budabalint/T.E.E.M.O/Circuit/CanSat/canSat_edge_cut_v1.dxf

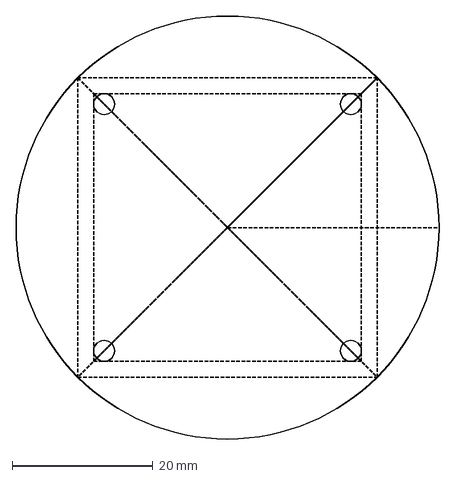
[picture p1: CAD file, 2025-11-27]
Circuit/CanSat/canSat_edge_cut_v1.dxf
60.0 x 60.0 mm
