budabalint/T.E.E.M.O/Circuit/CanSat_V2/V0.2.pdf

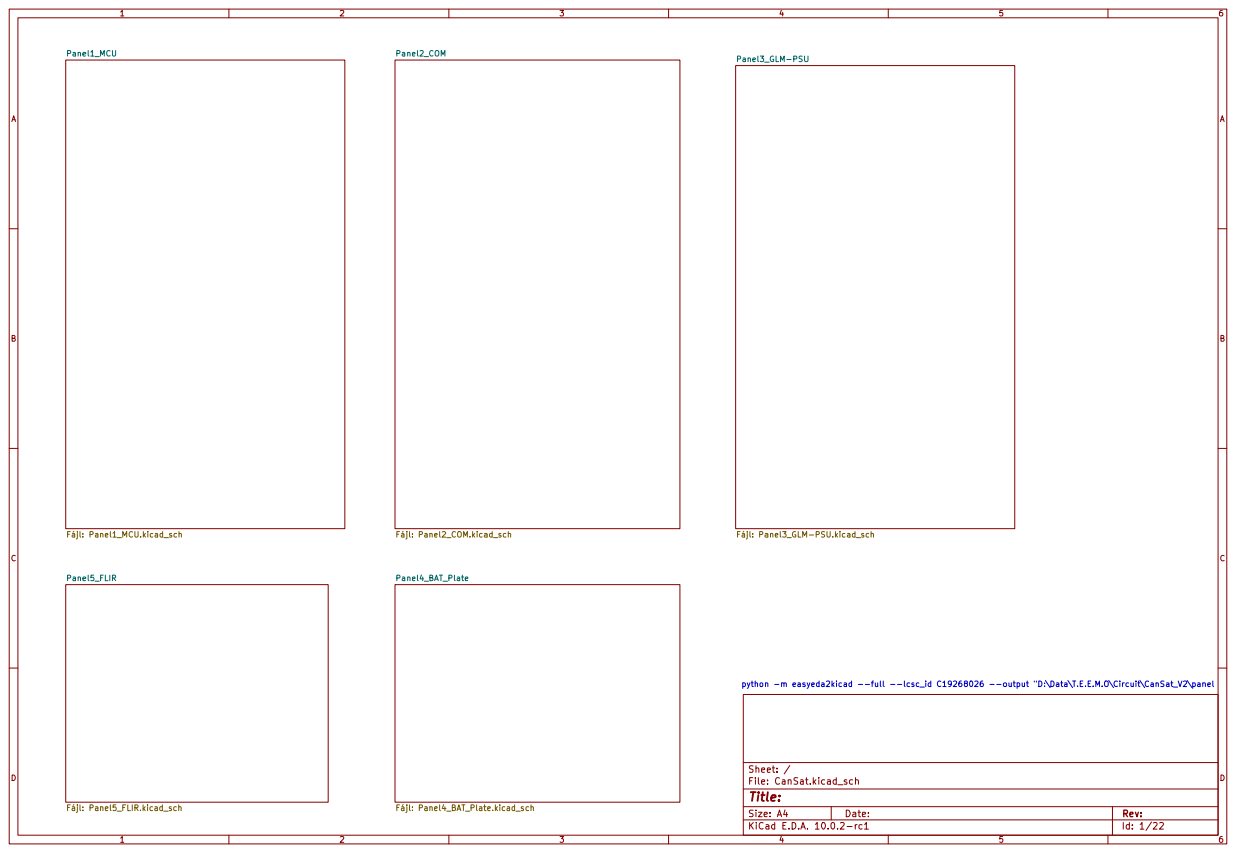
[picture p2: page 1]

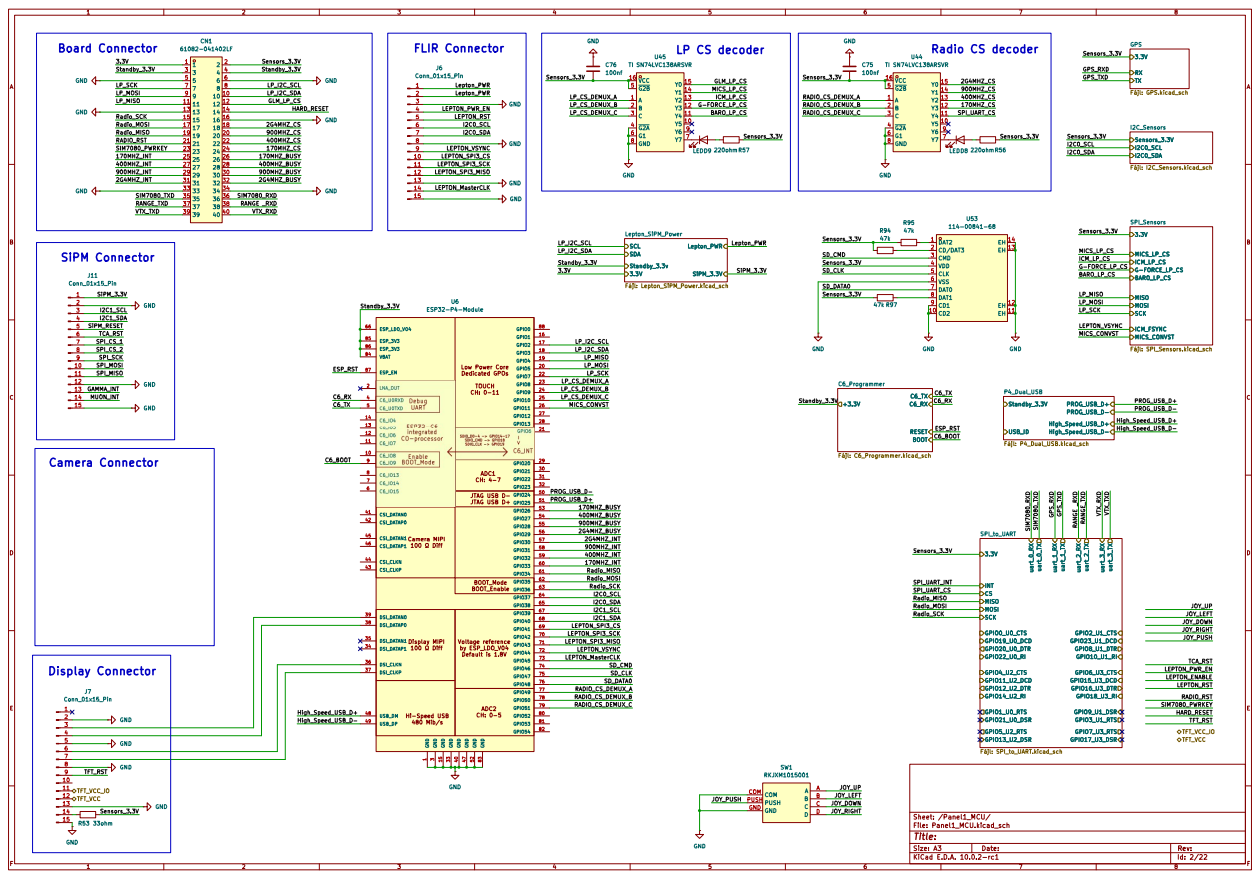
[picture p3: page 2]

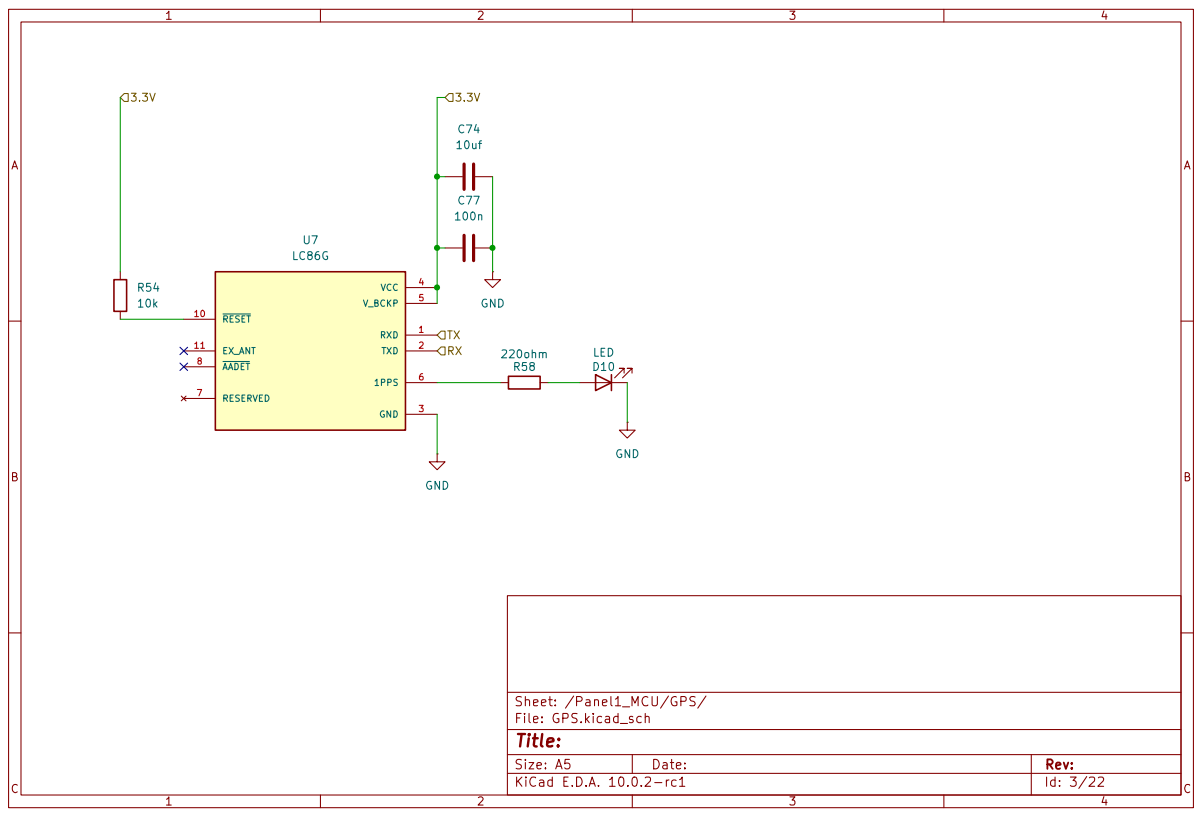
[picture p4: page 3]

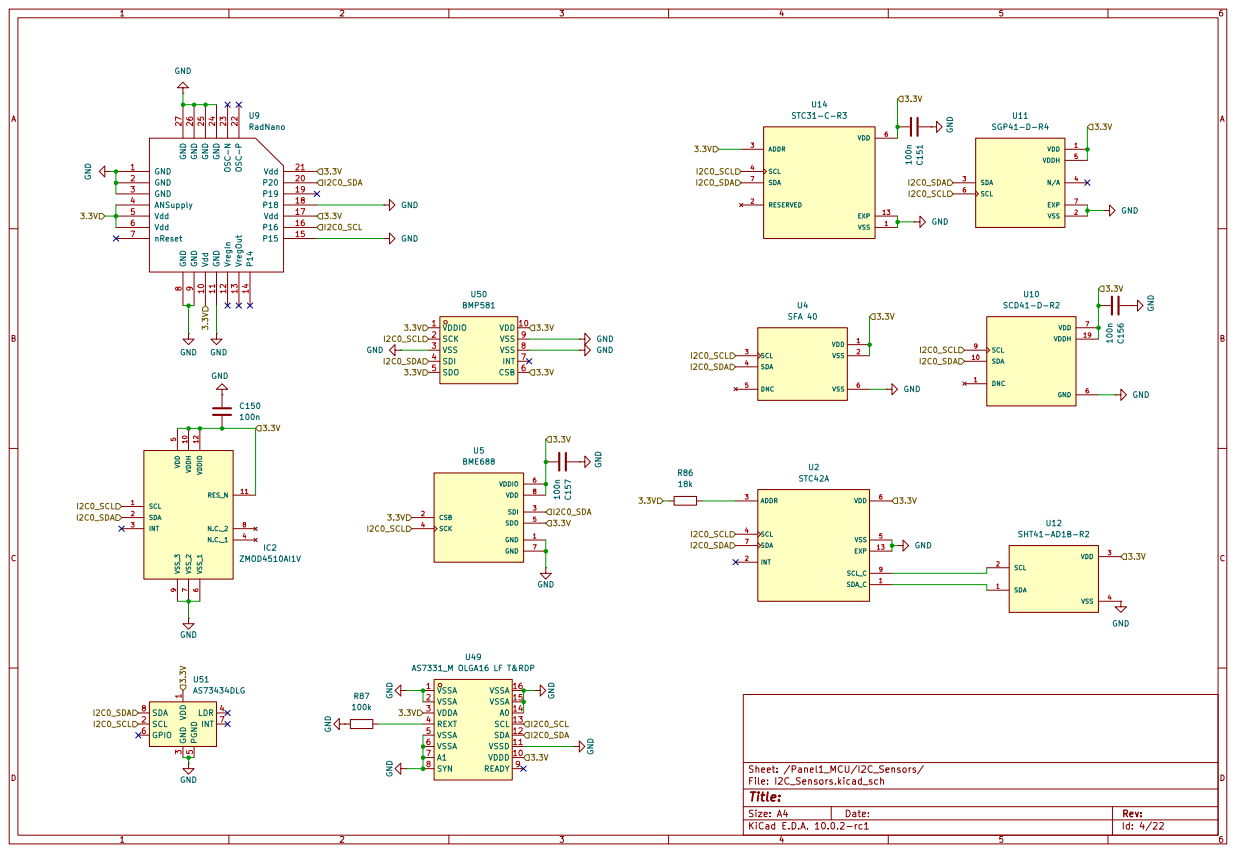
[picture p5: page 4]

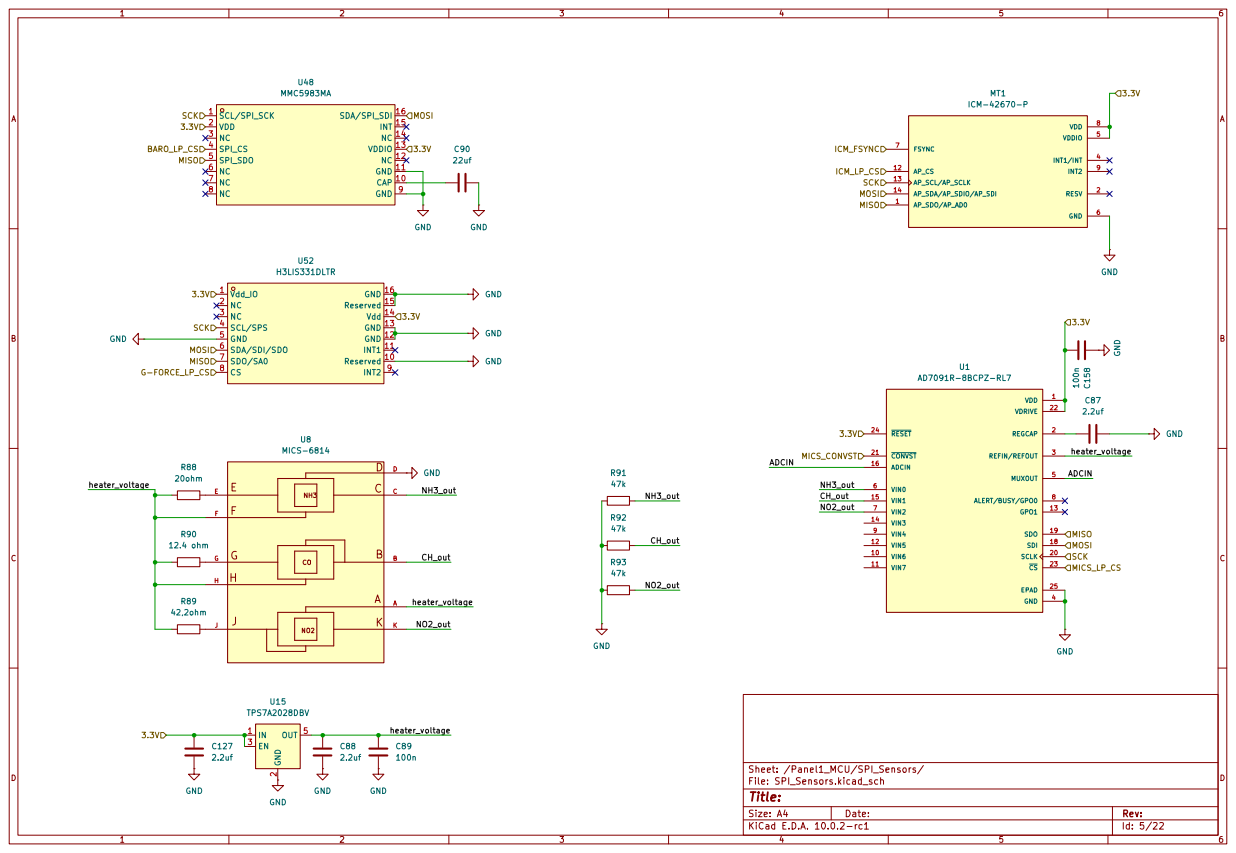
[picture p6: page 5]

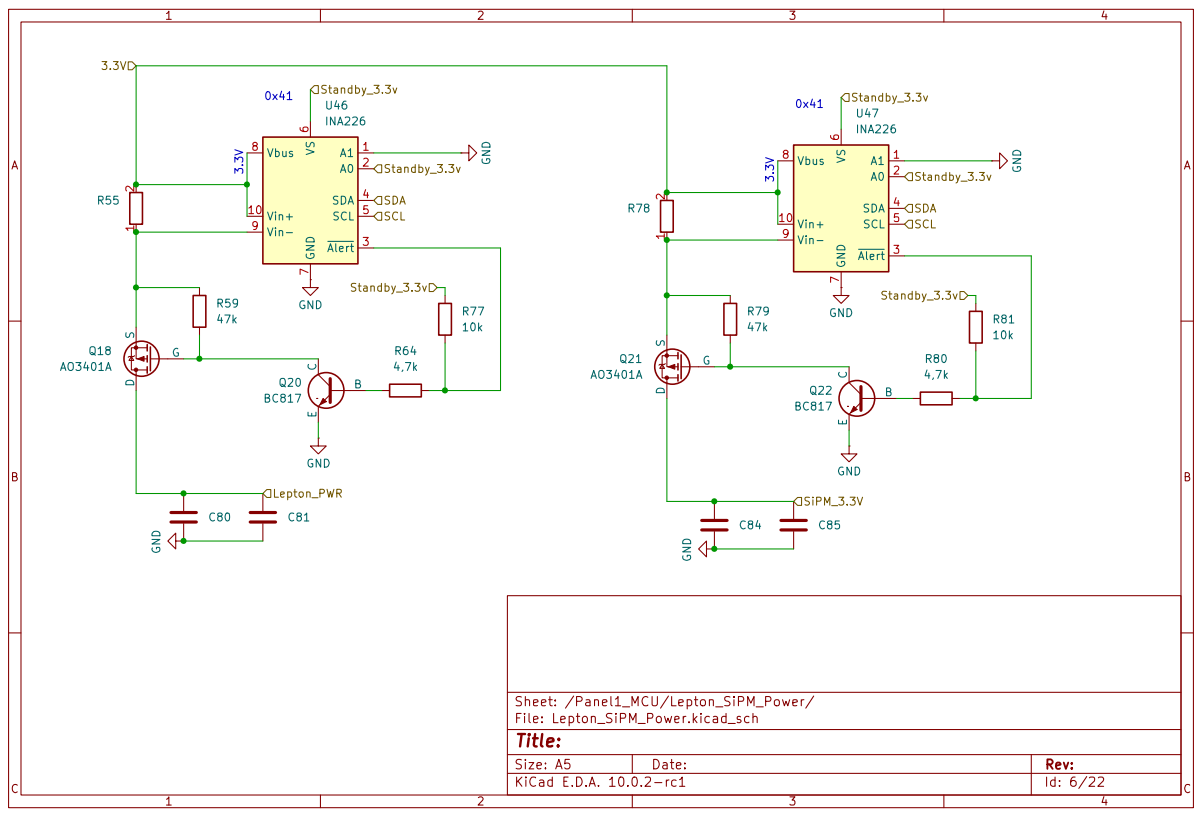
[picture p7: page 6]

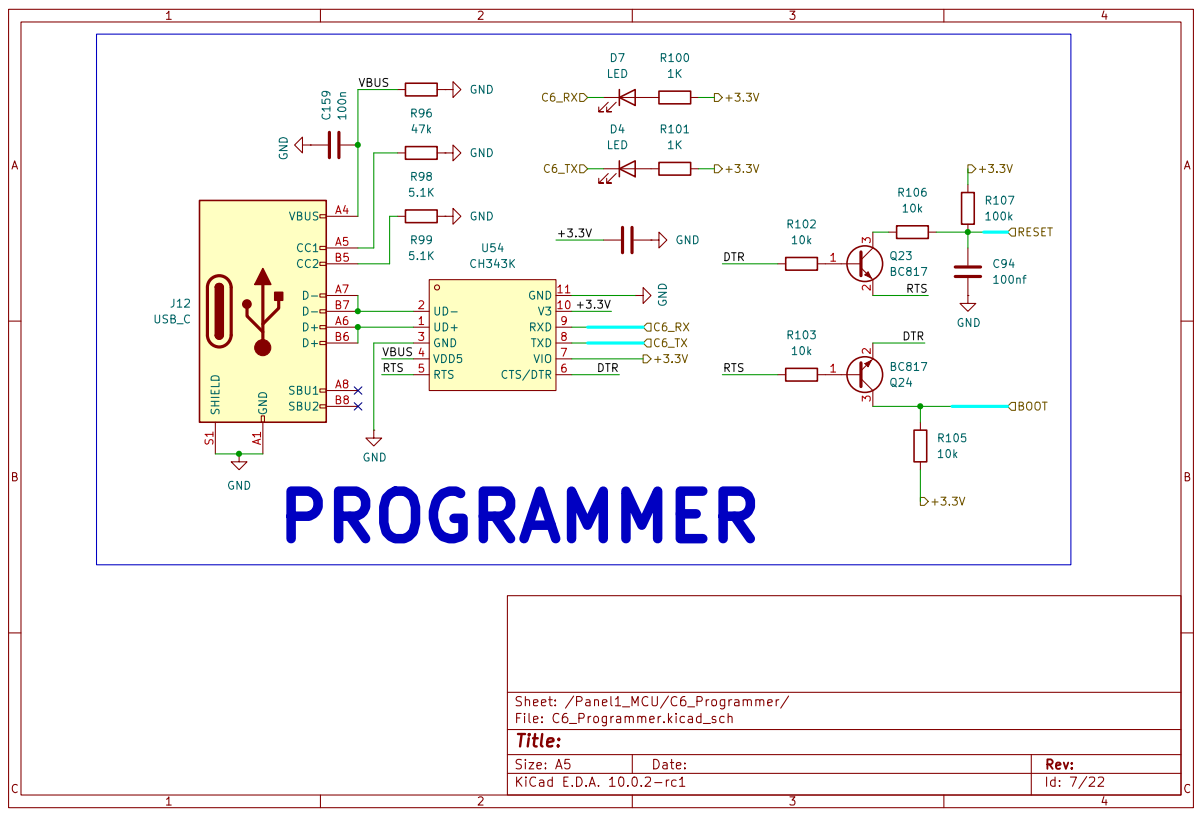
[picture p8: page 7]

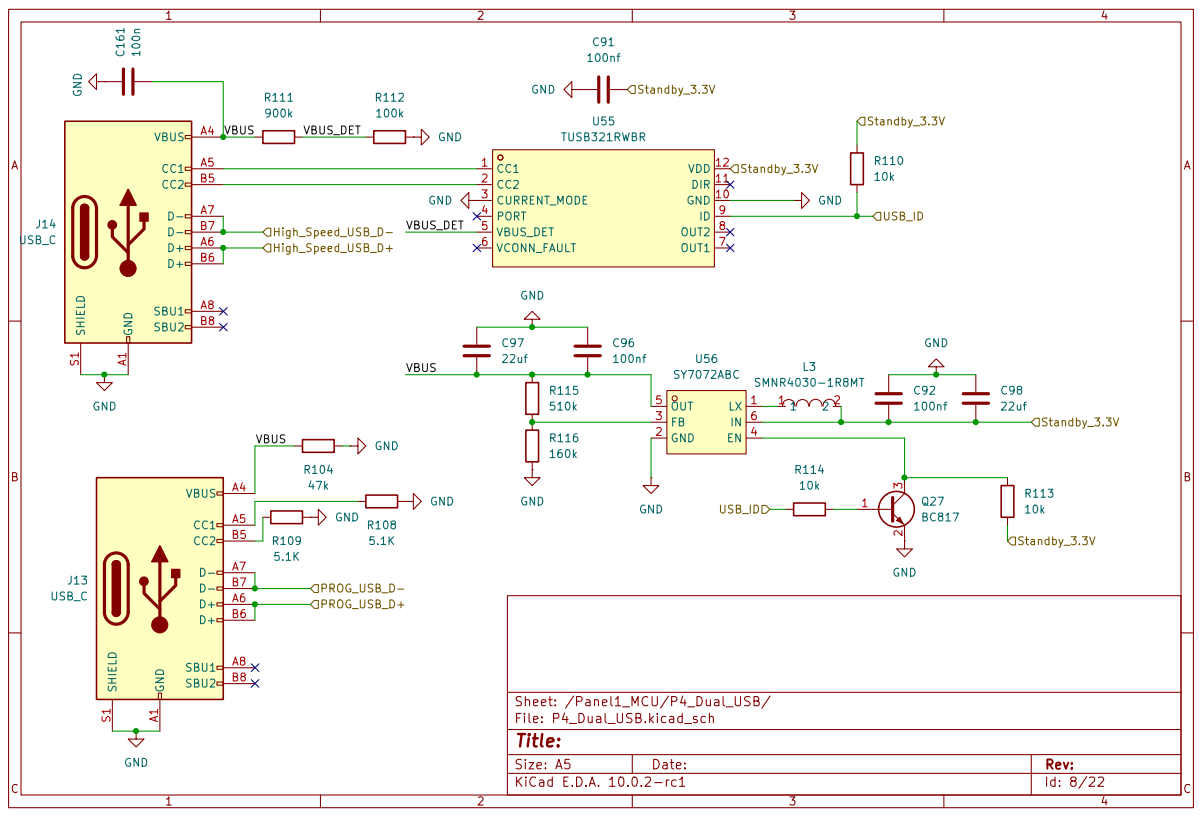
[picture p9: page 8]

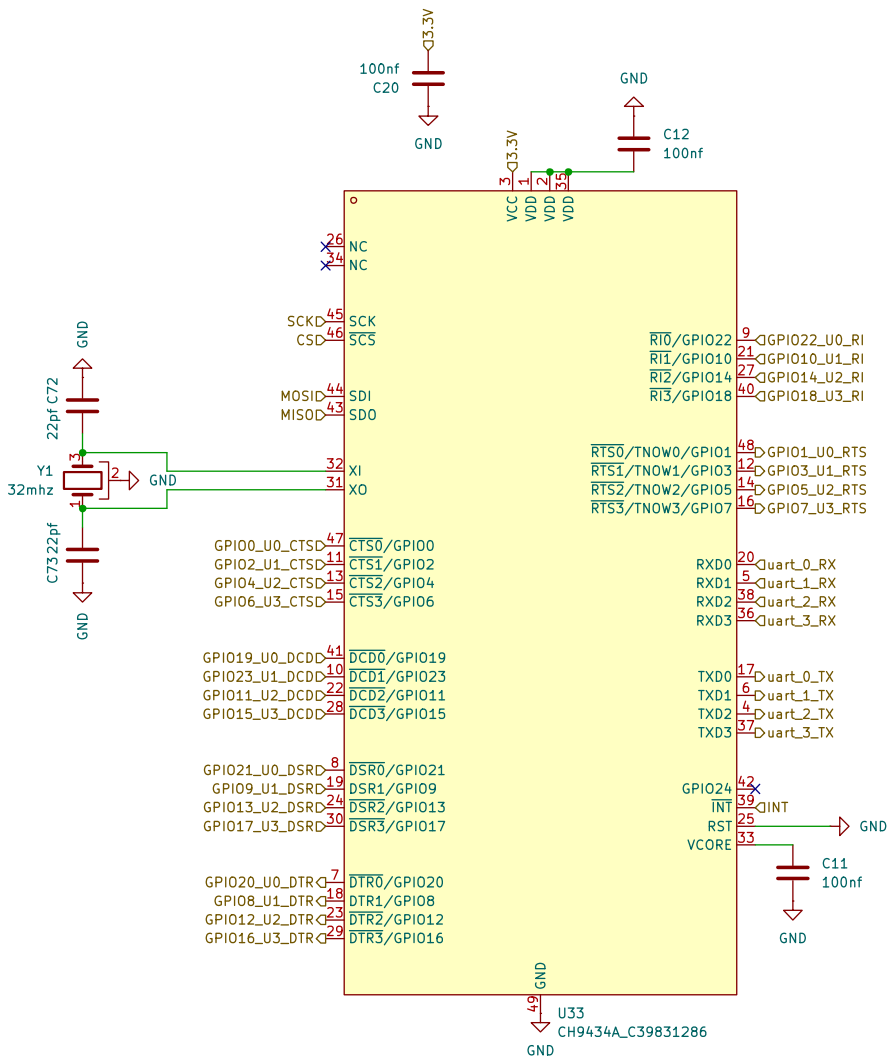
[picture p10: page 9]

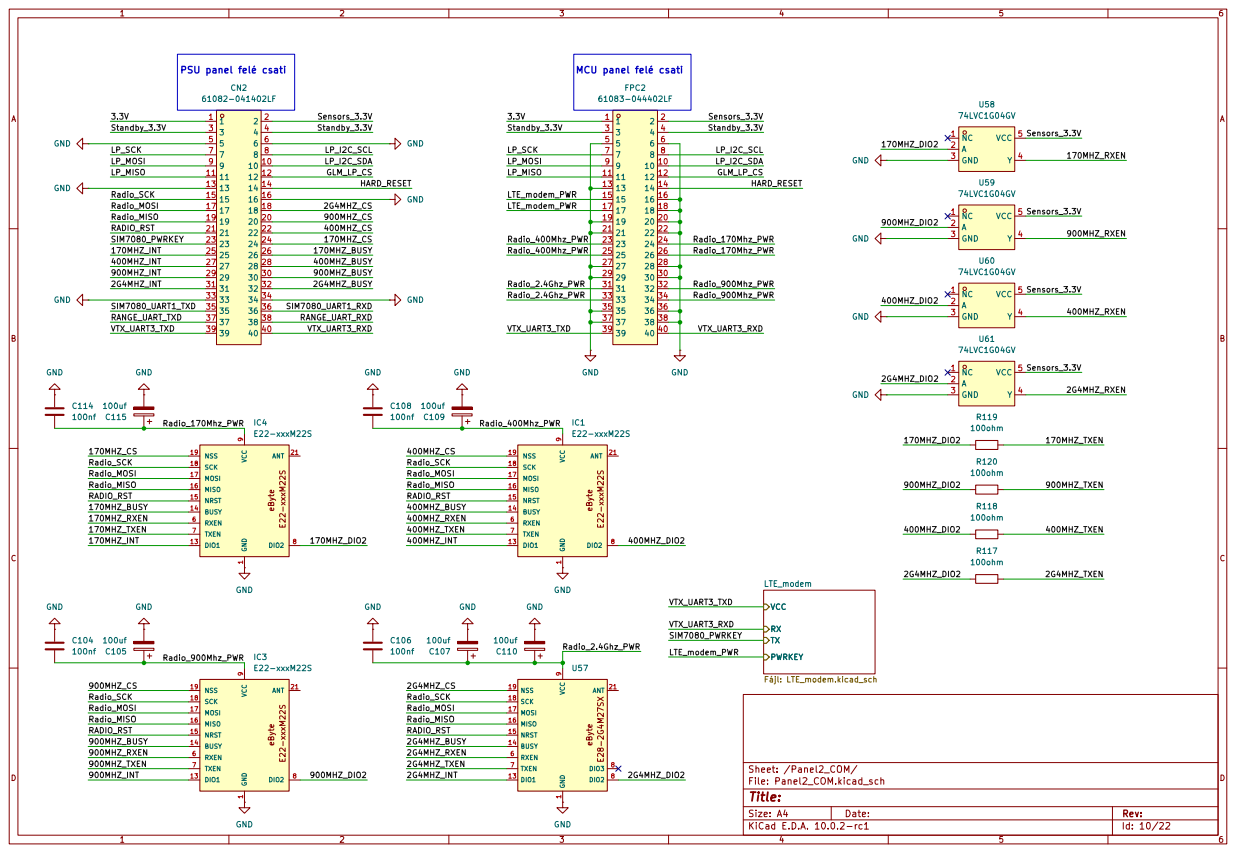
[picture p11: page 10]

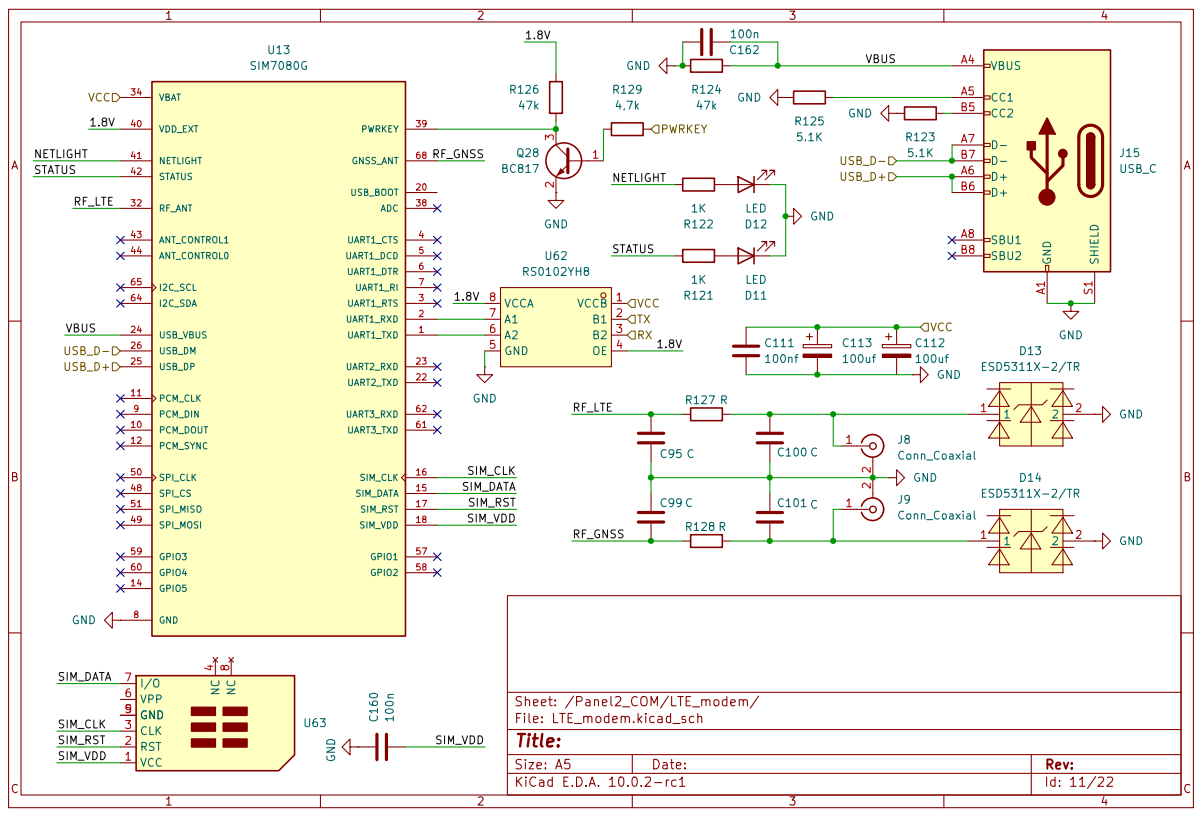
[picture p12: page 11]

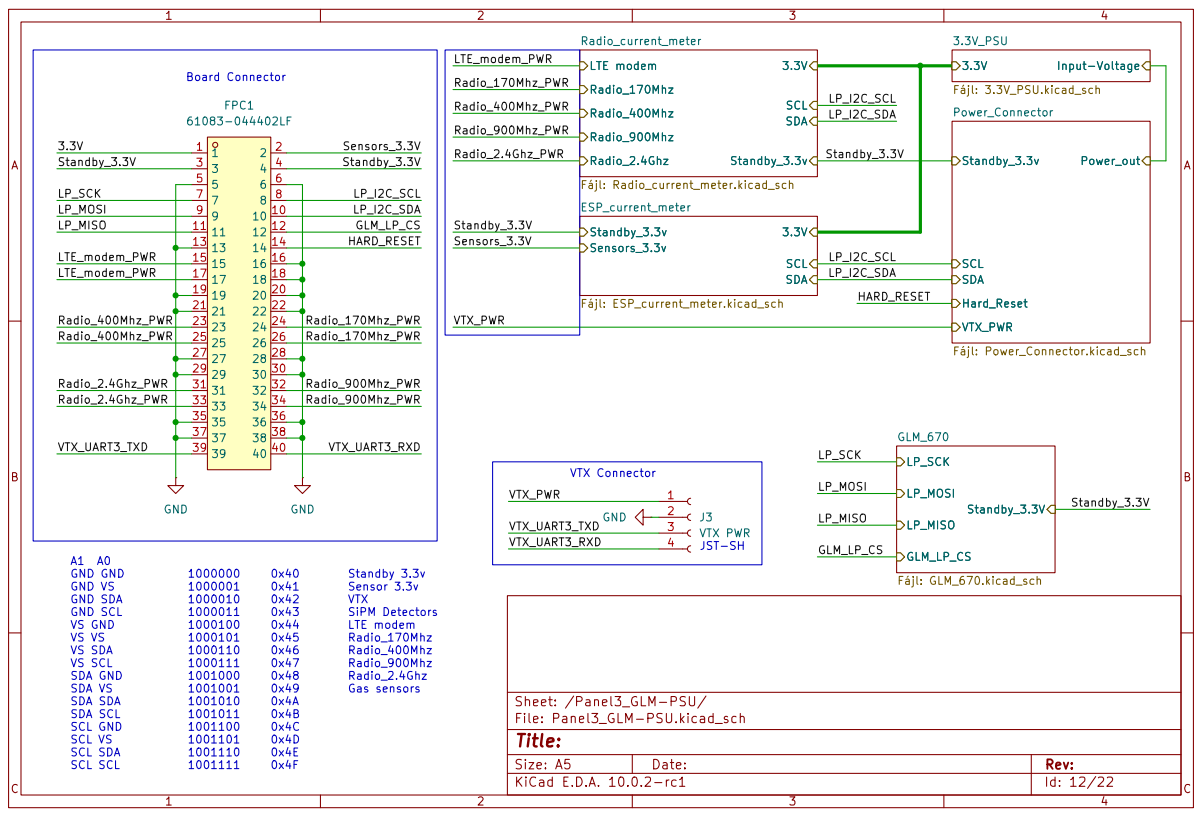
[picture p13: page 12]

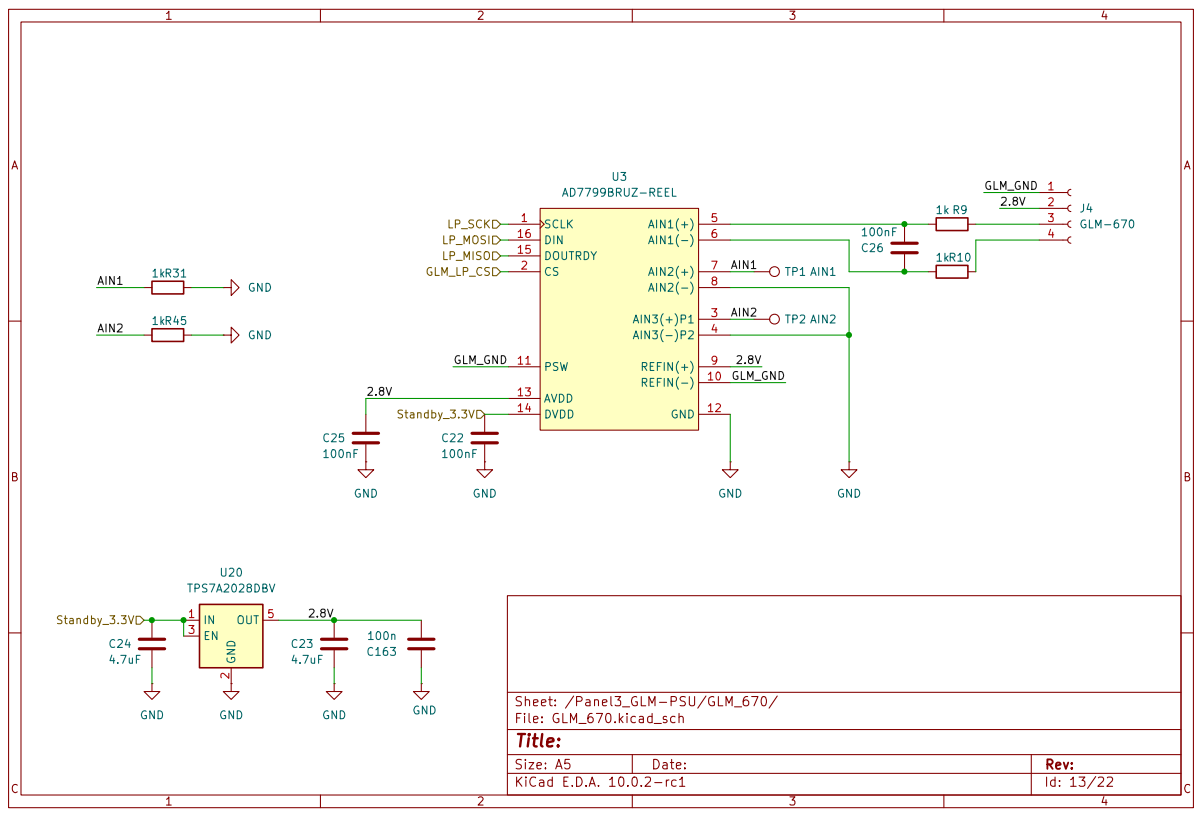
[picture p14: page 13]

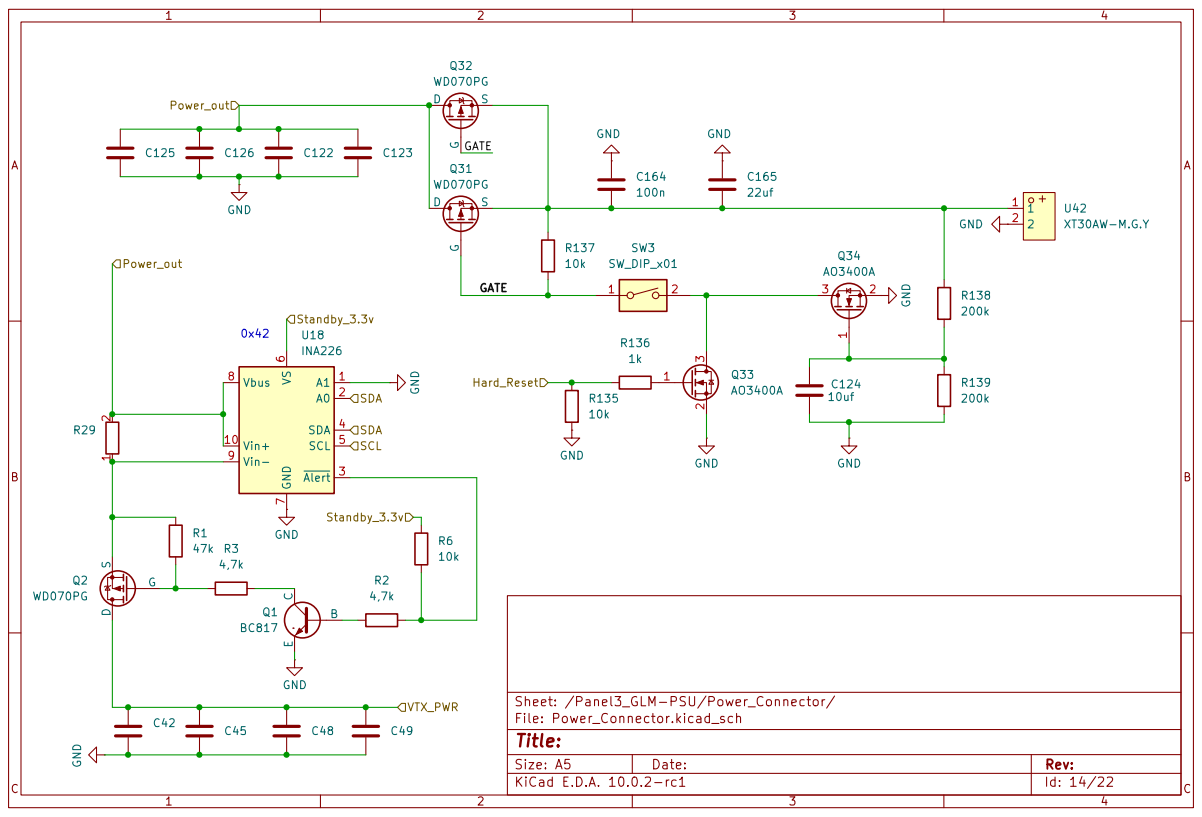
[picture p15: page 14]

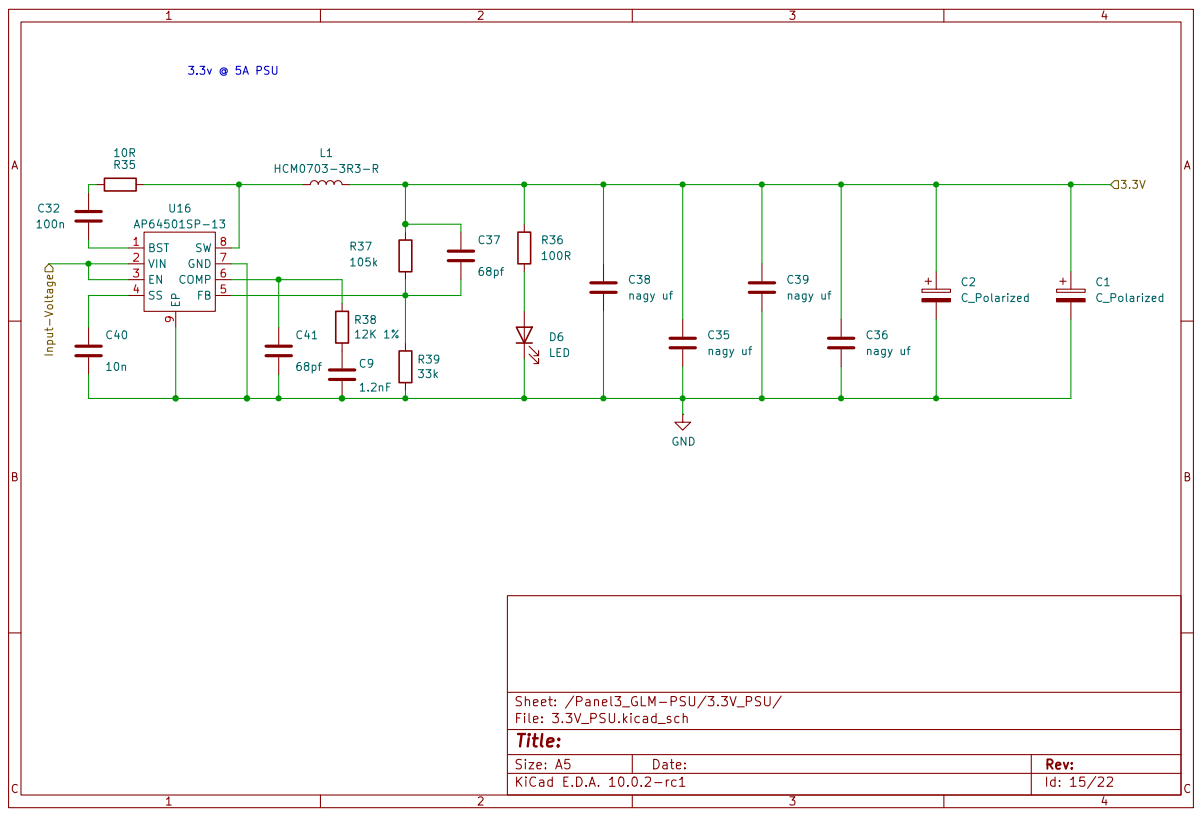
[picture p16: page 15]

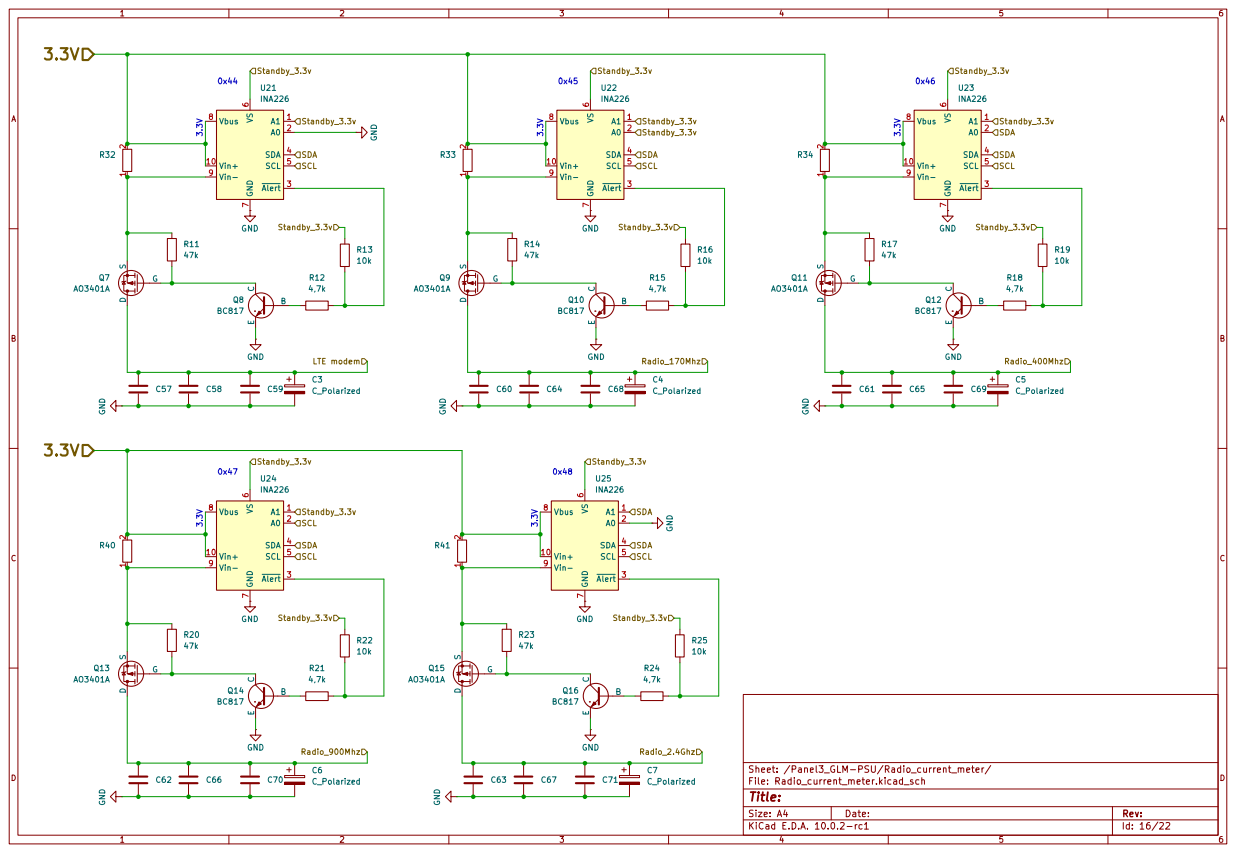
[picture p17: page 16]

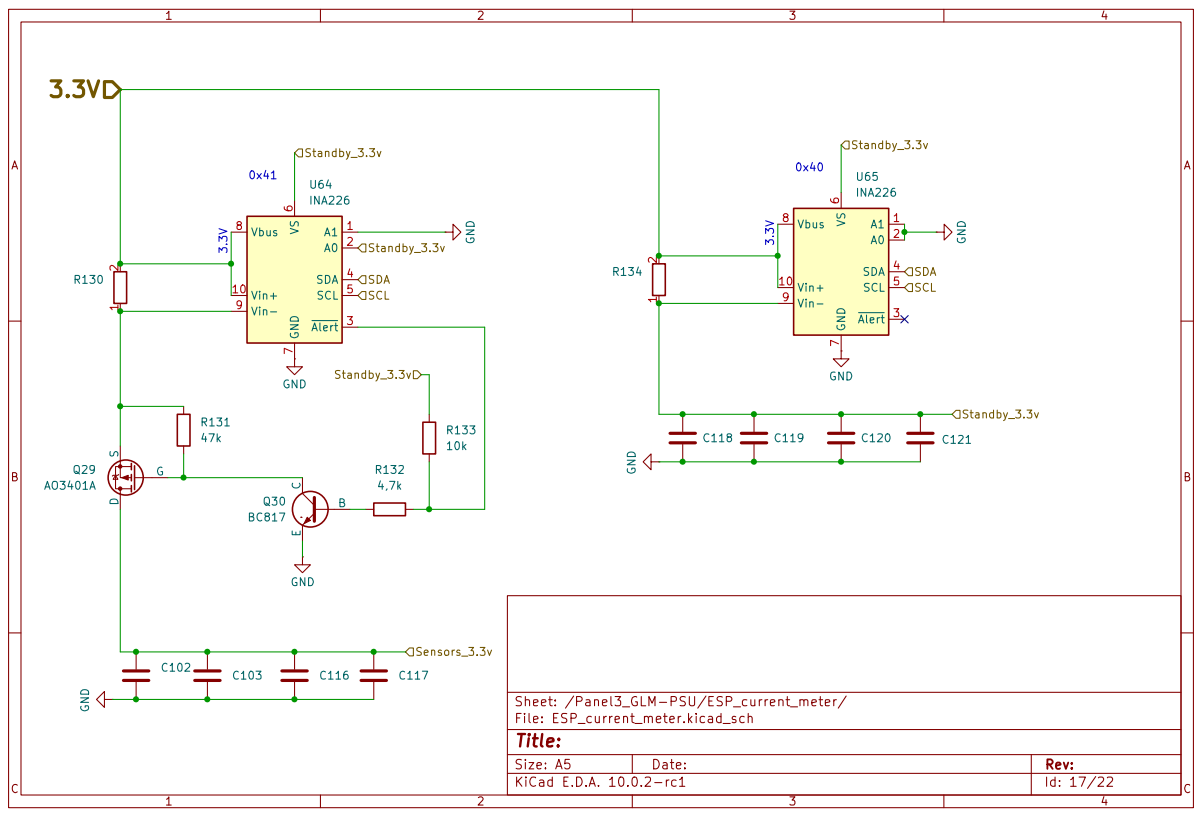
[picture p18: page 17]

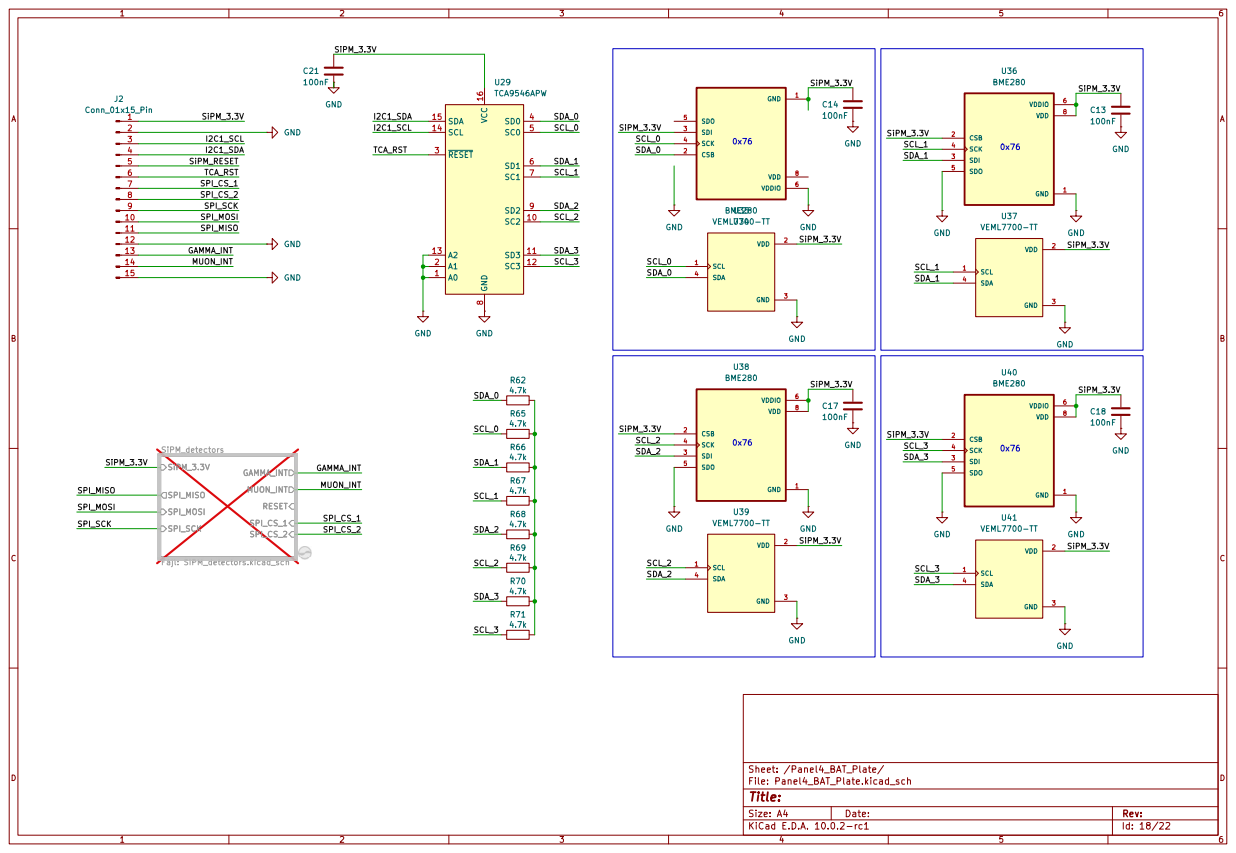
[picture p19: page 18]

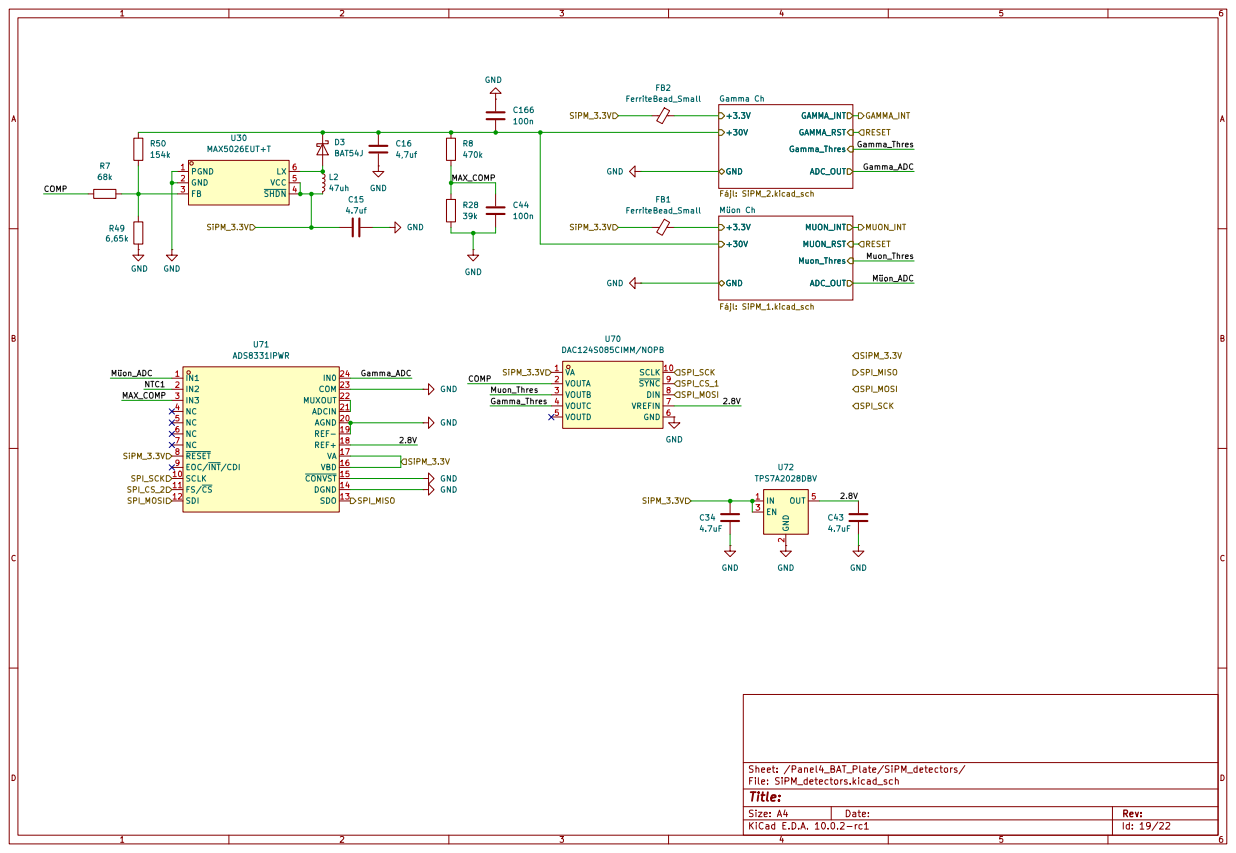
[picture p20: page 19]

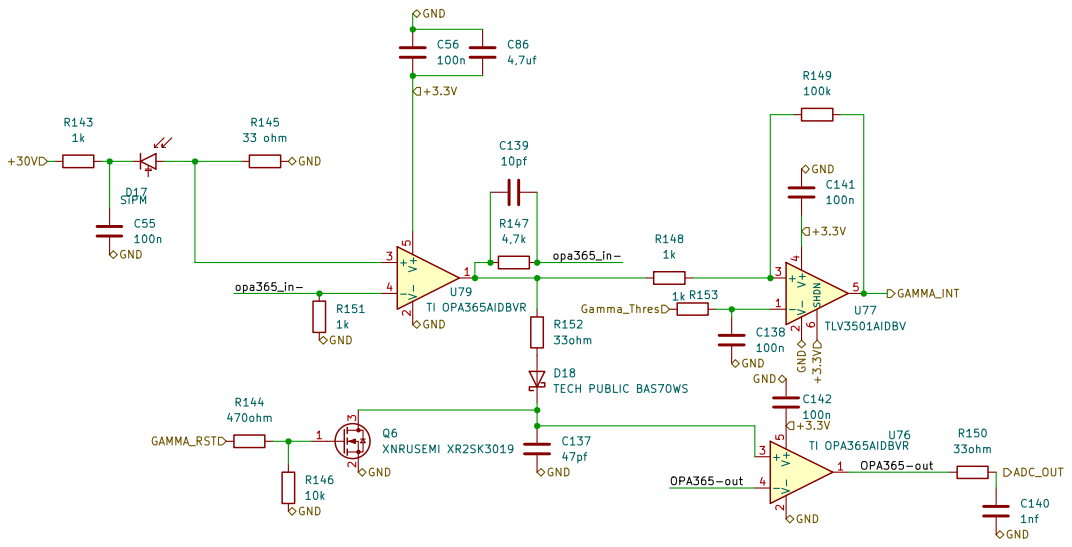
[picture p21: page 20]

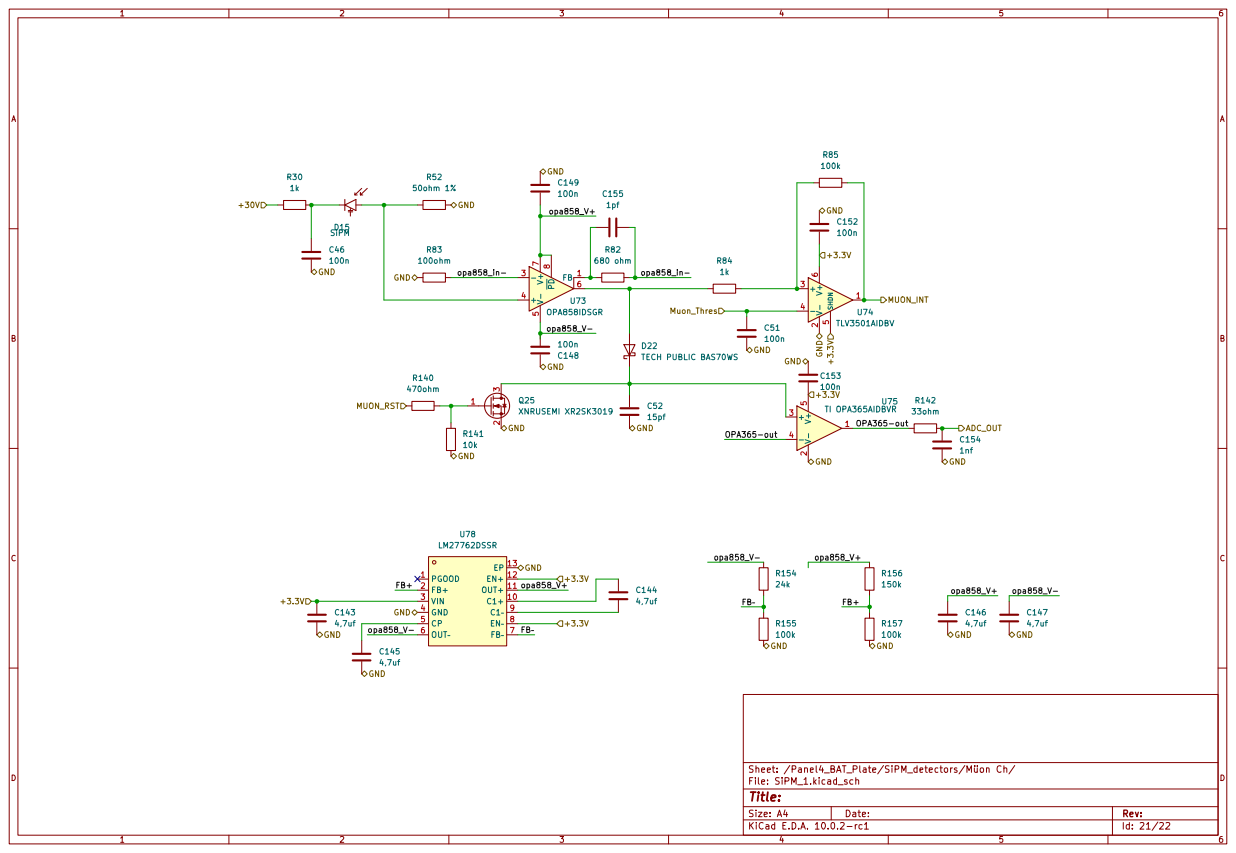
[picture p22: page 21]

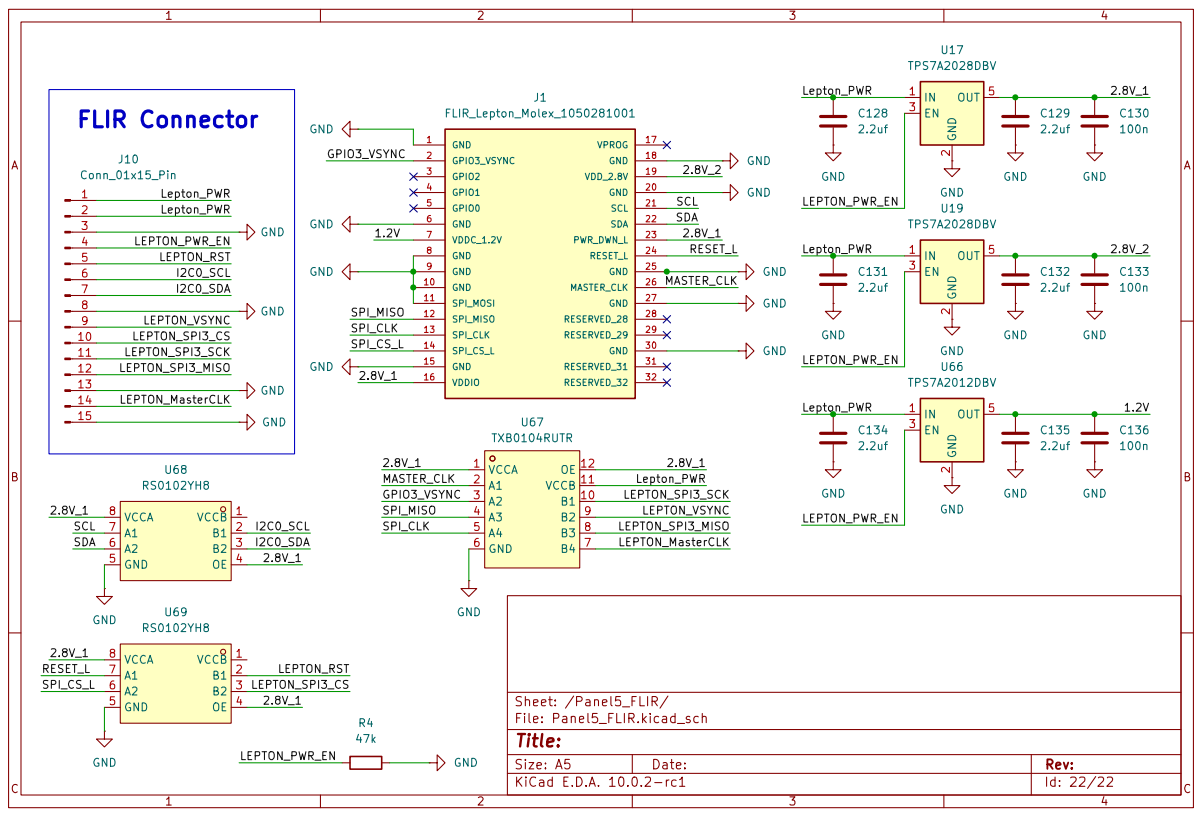
[picture p23: page 22]
