budabalint/T.E.E.M.O/Circuit/CanSat/V1.0.pdf

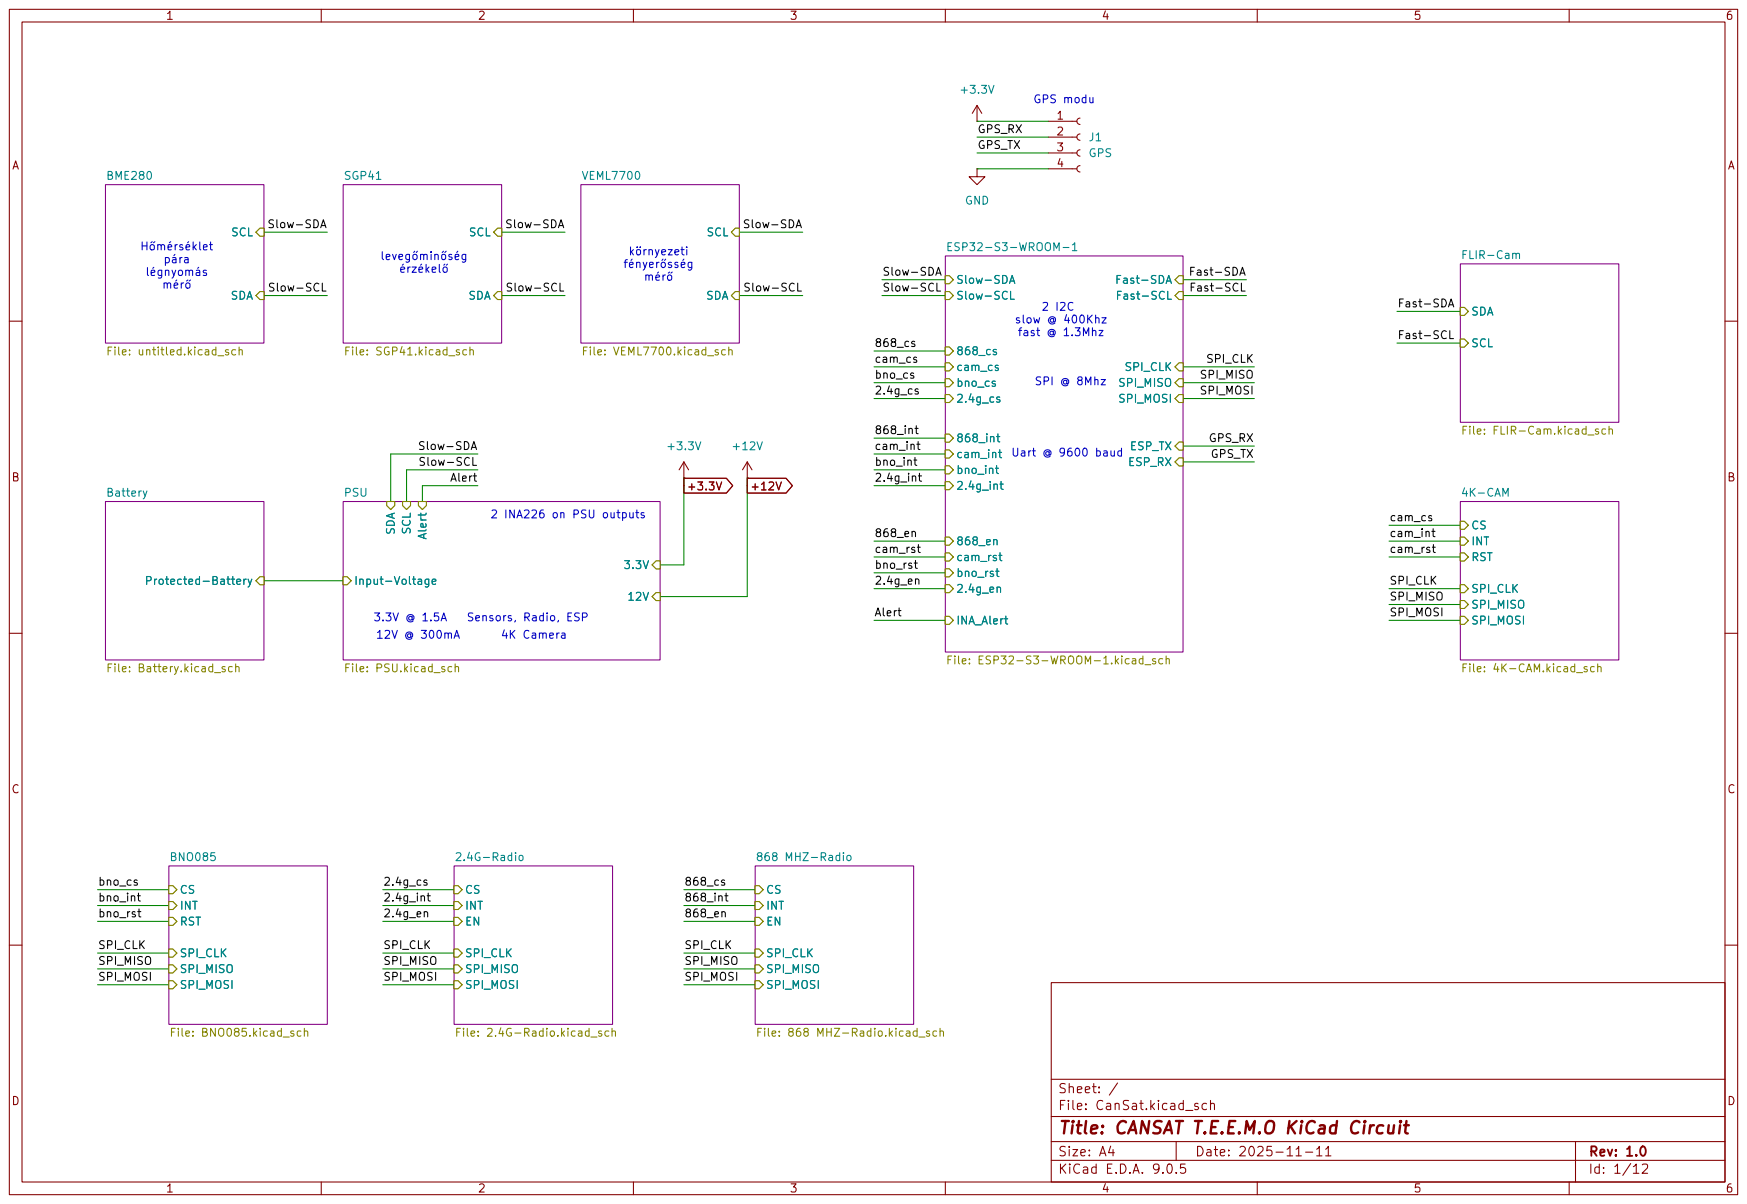
[picture p24: page 1]
