budabalint/T.E.E.M.O/Circuit/CanSat_V2/V0.1.pdf

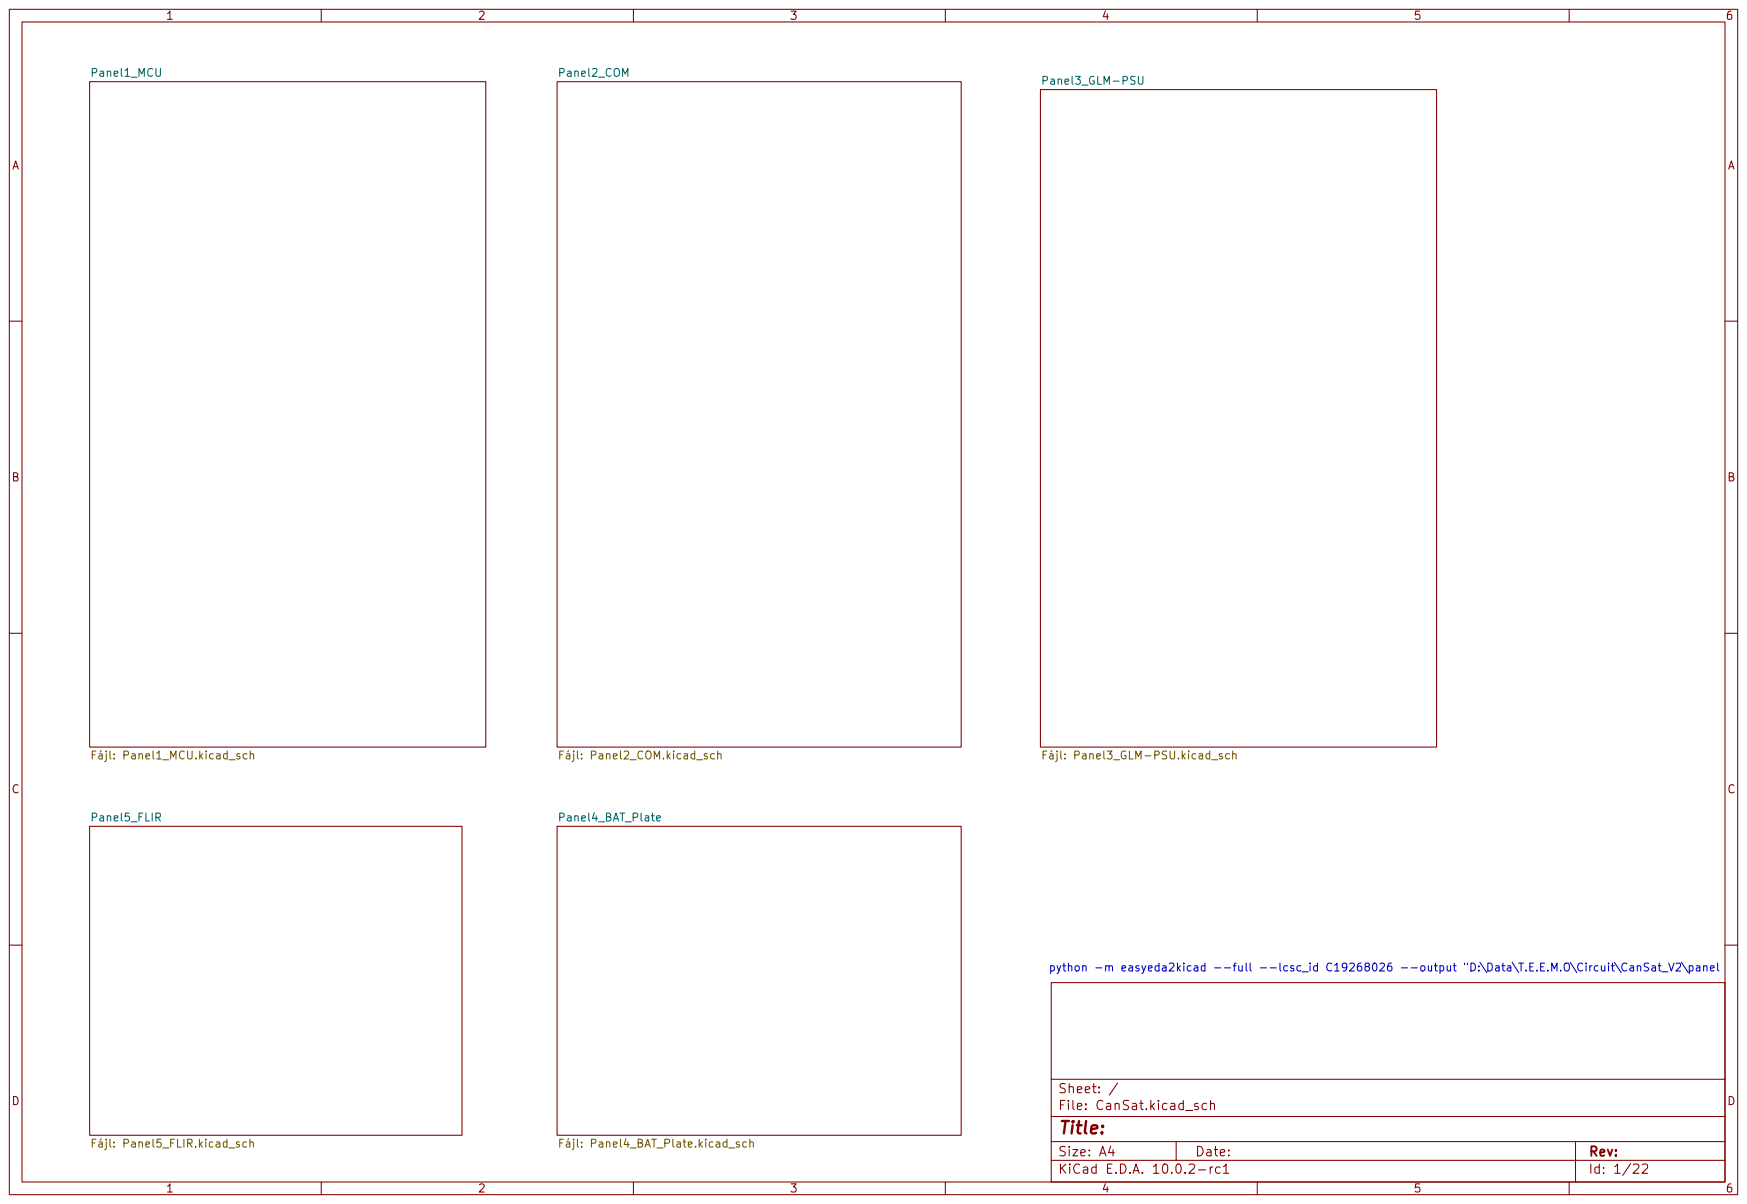
[picture p25: page 1]

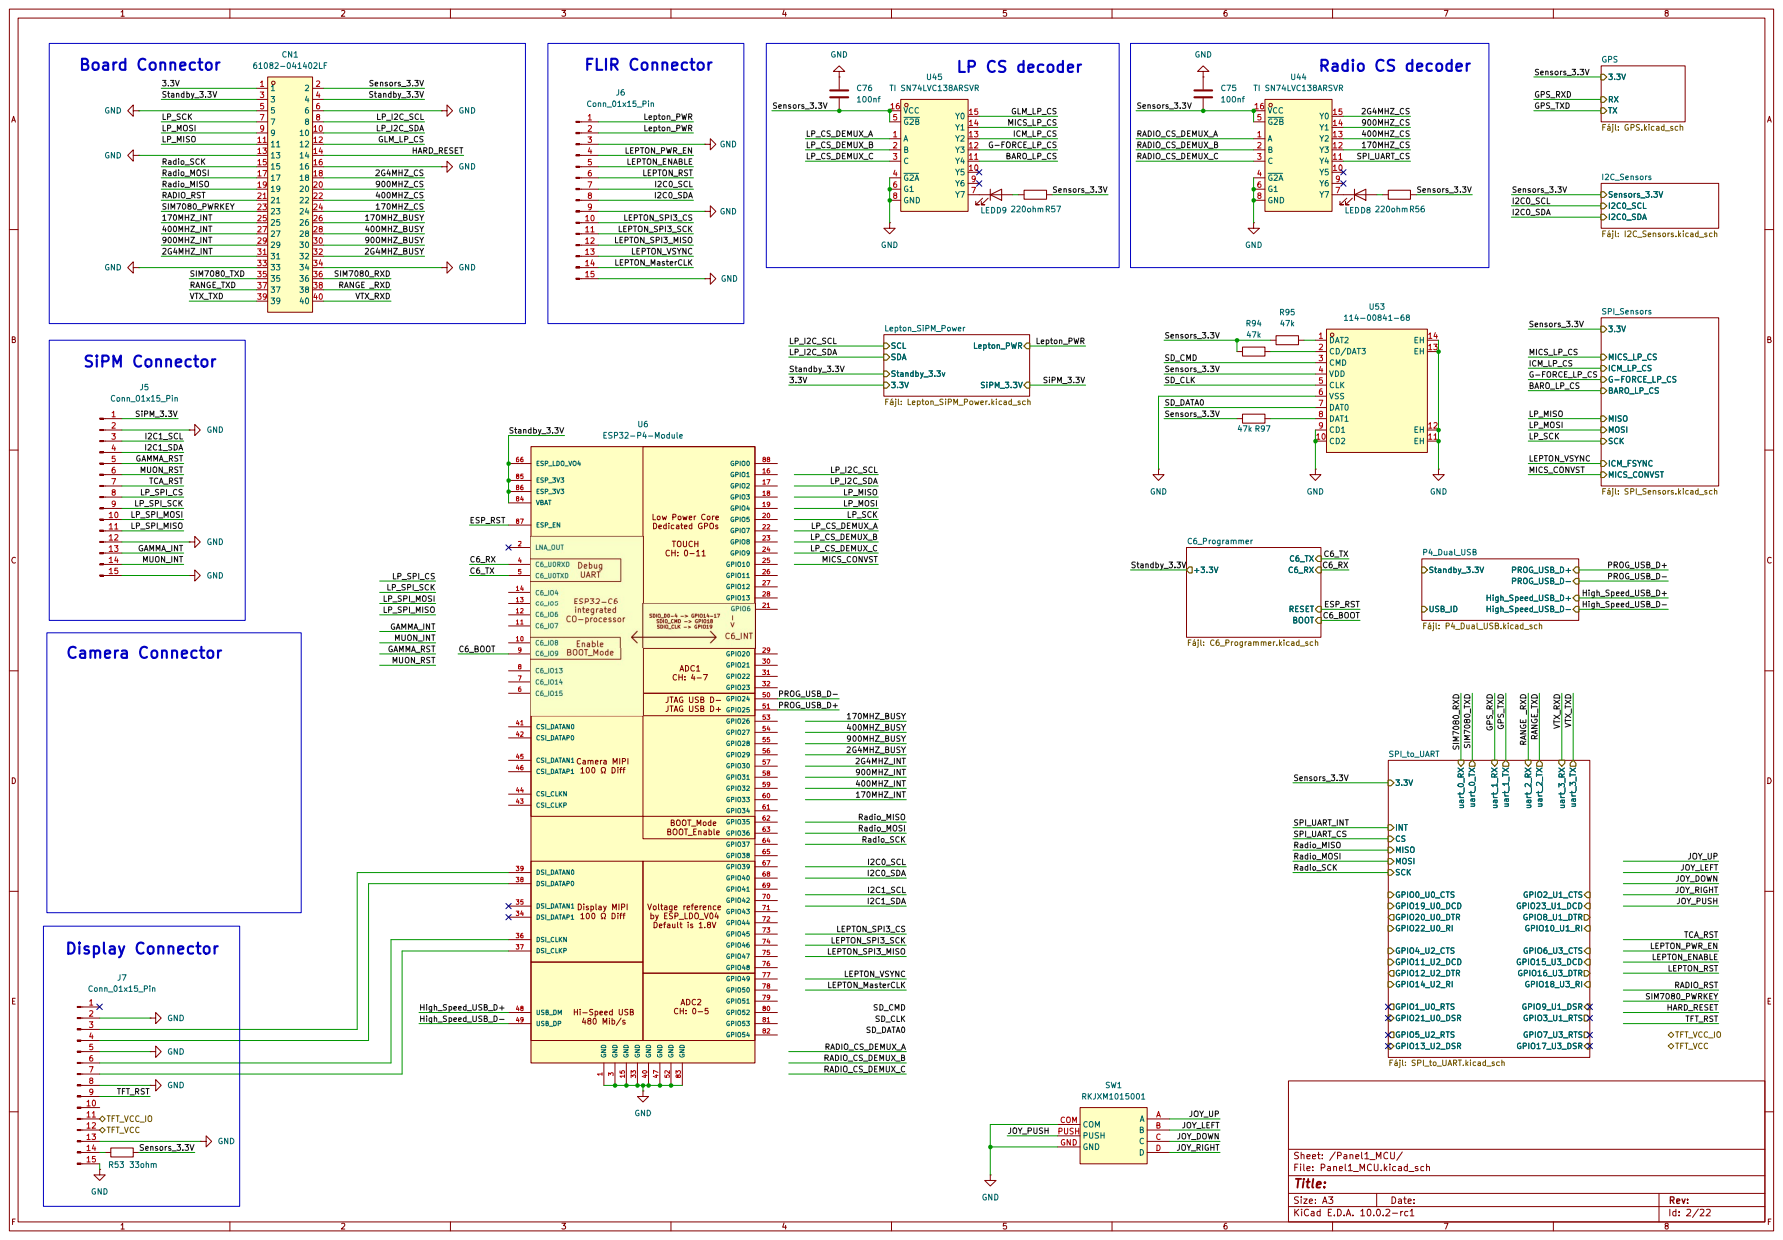
[picture p26: page 2]

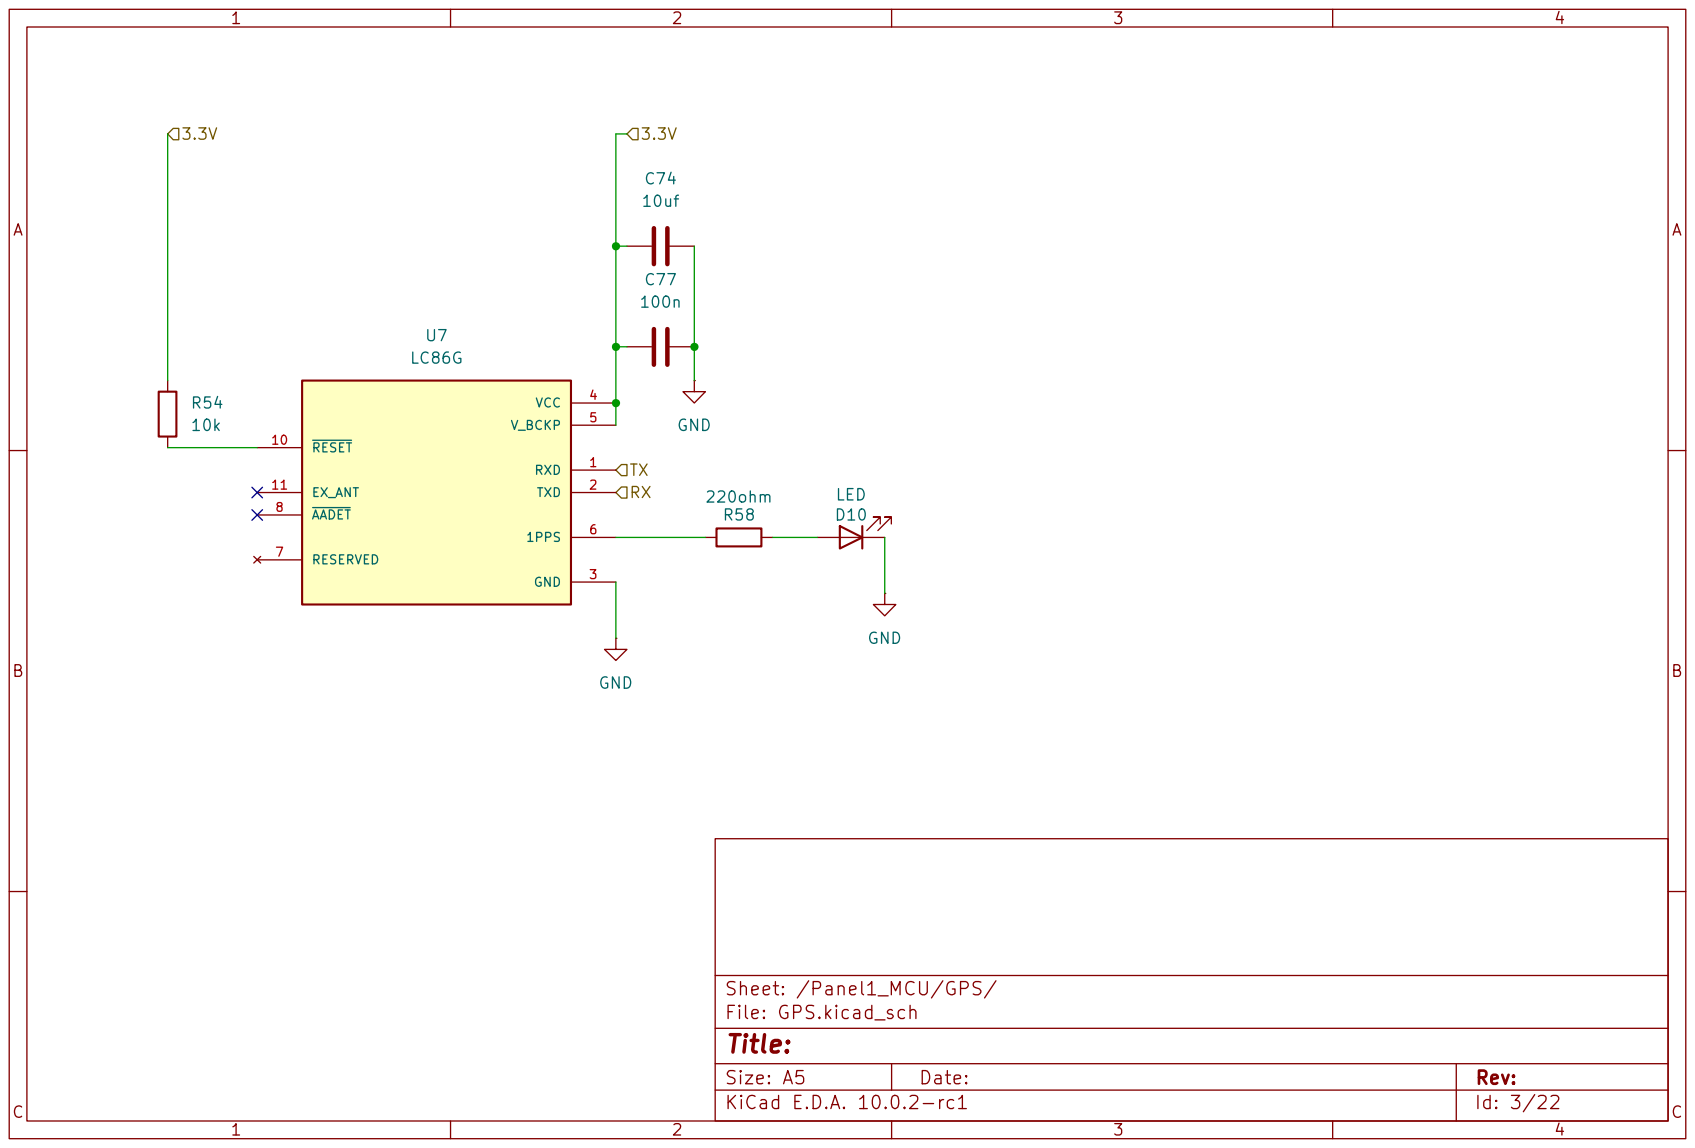
[picture p27: page 3]

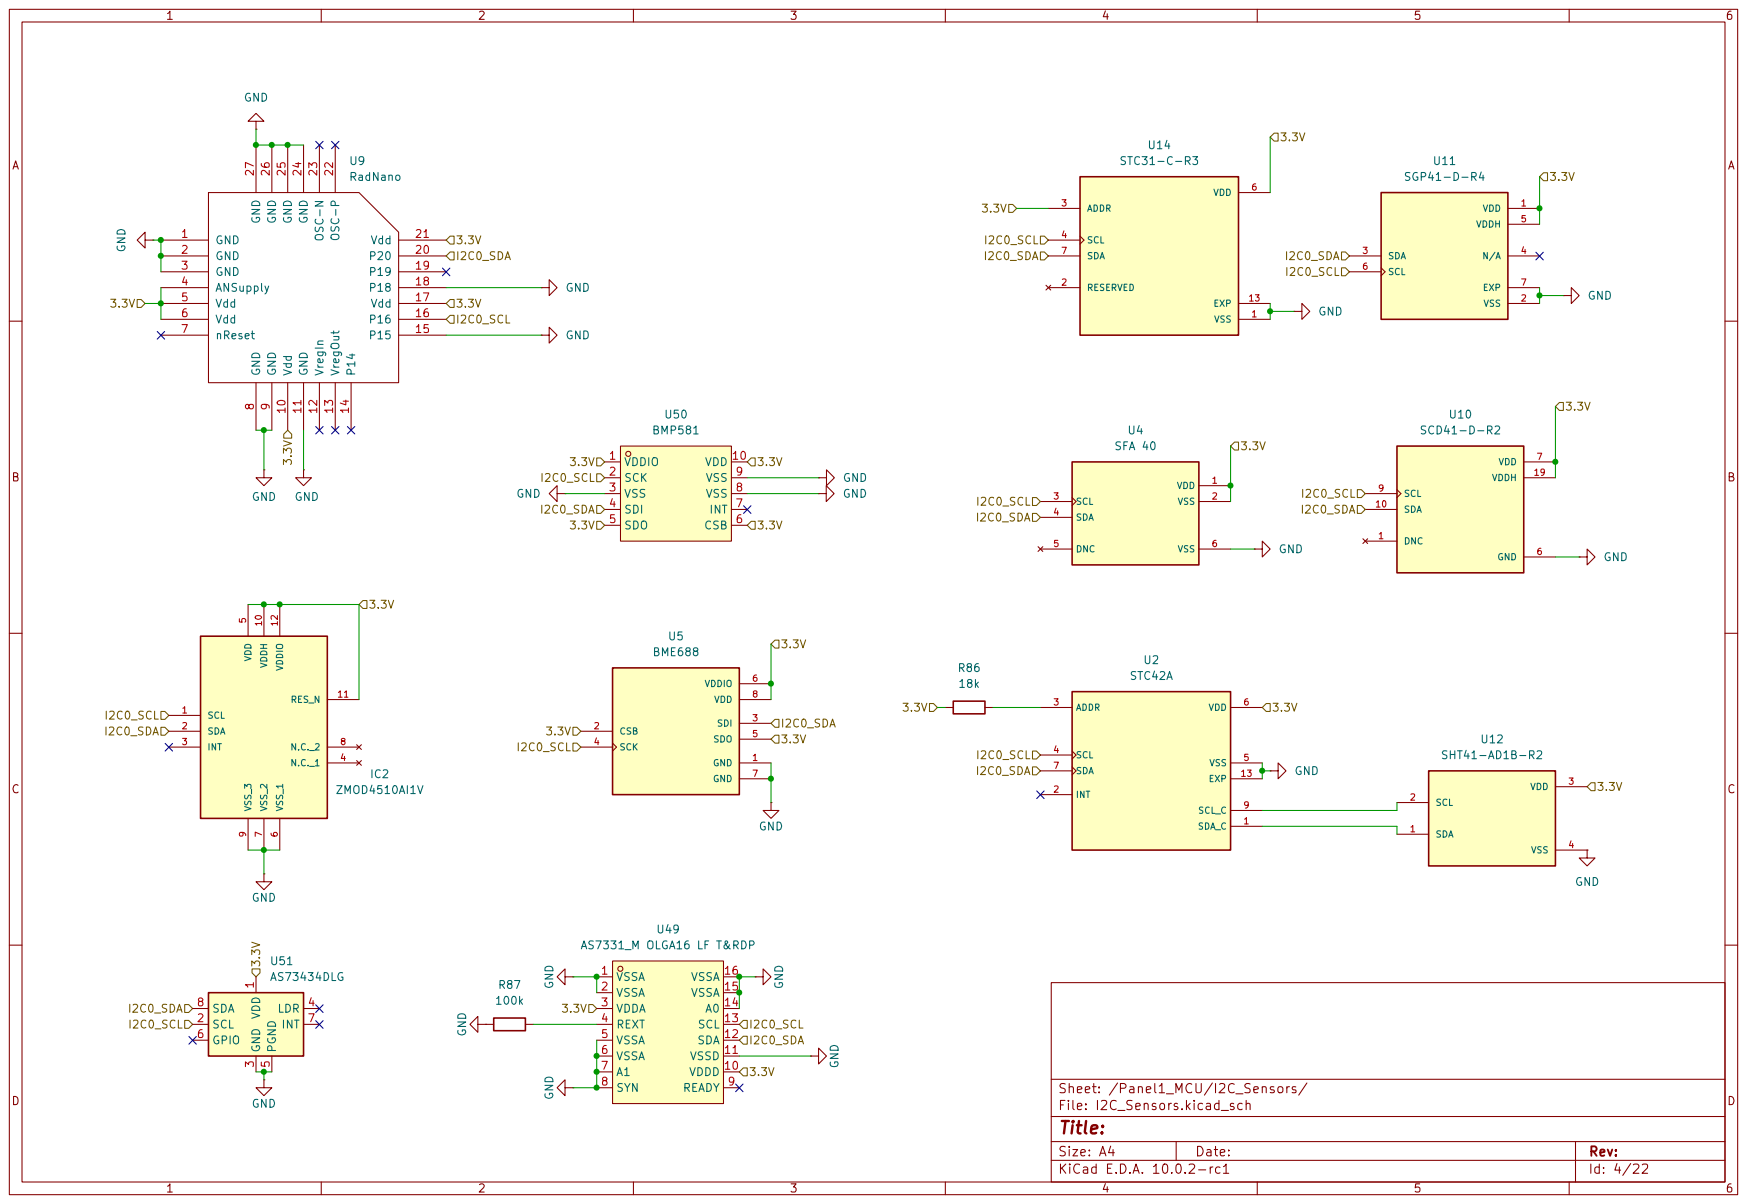
[picture p28: page 4]

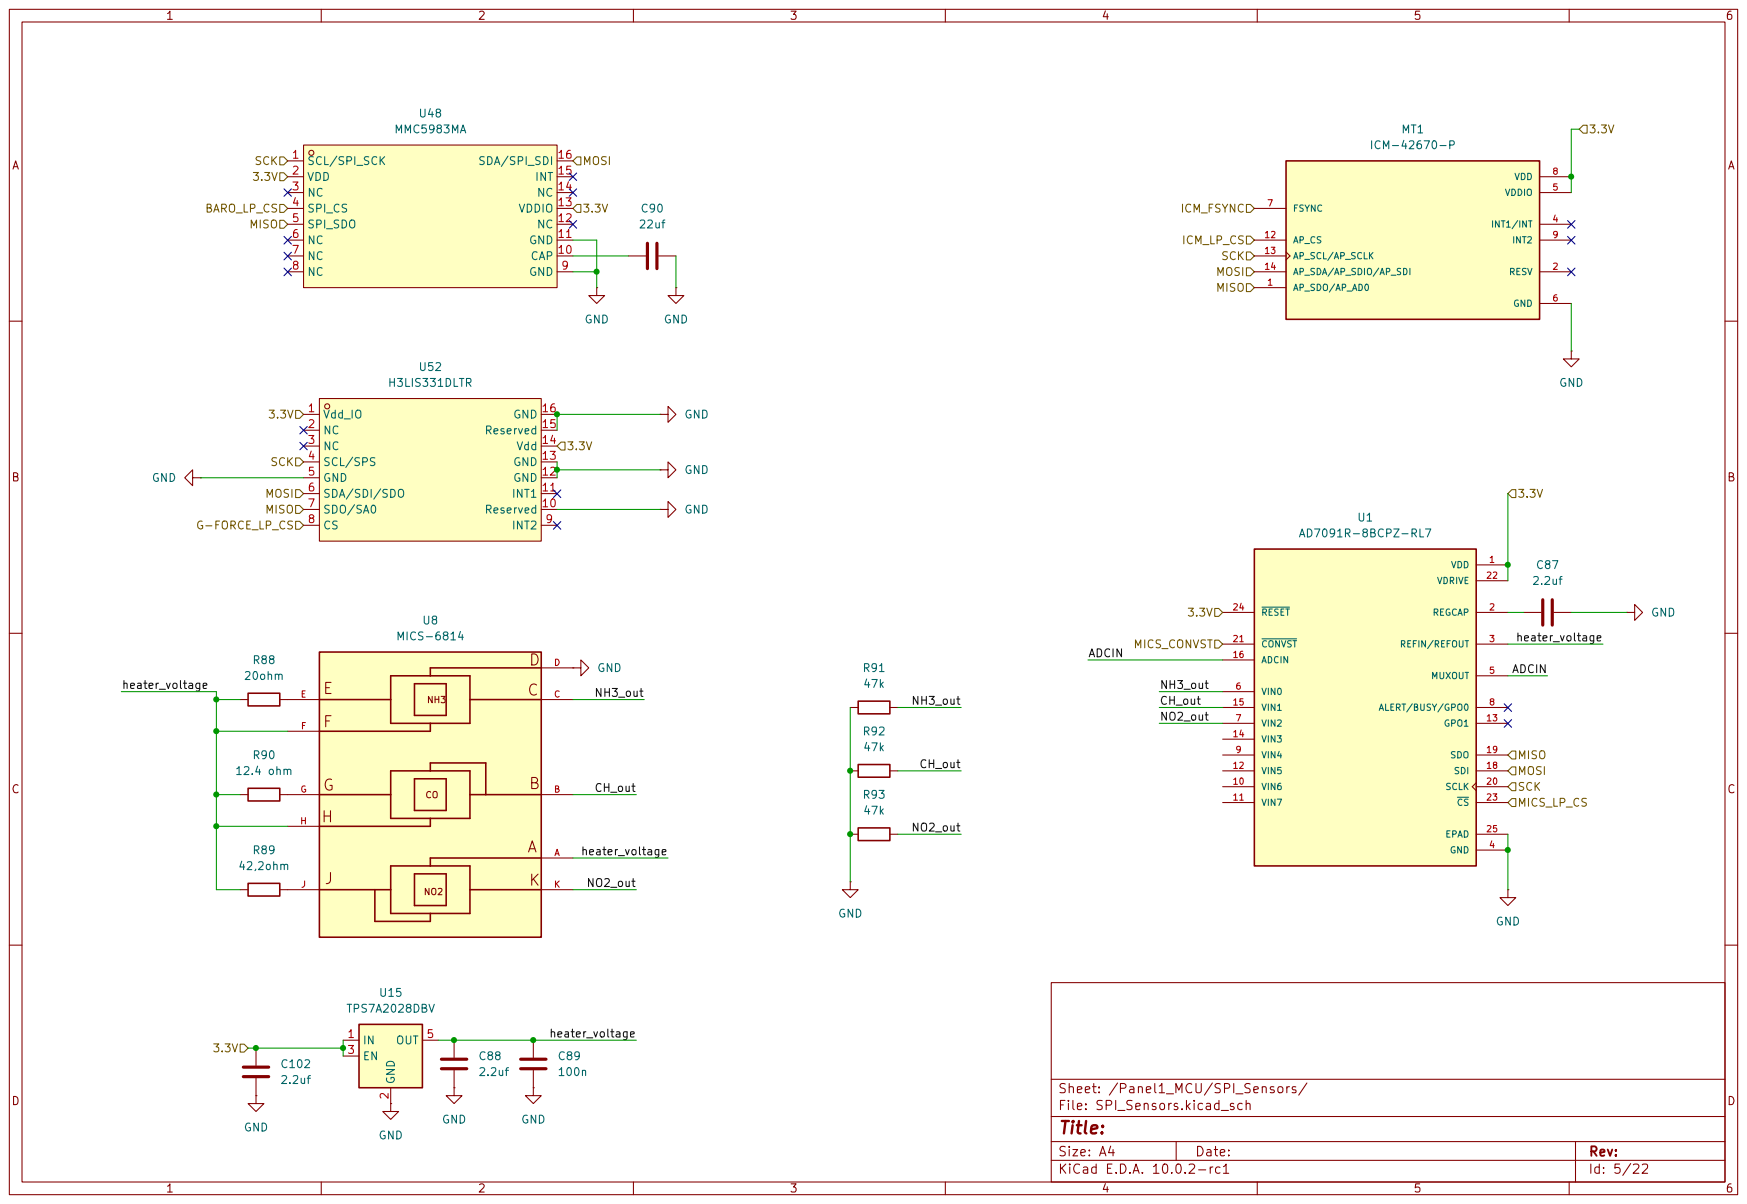
[picture p29: page 5]

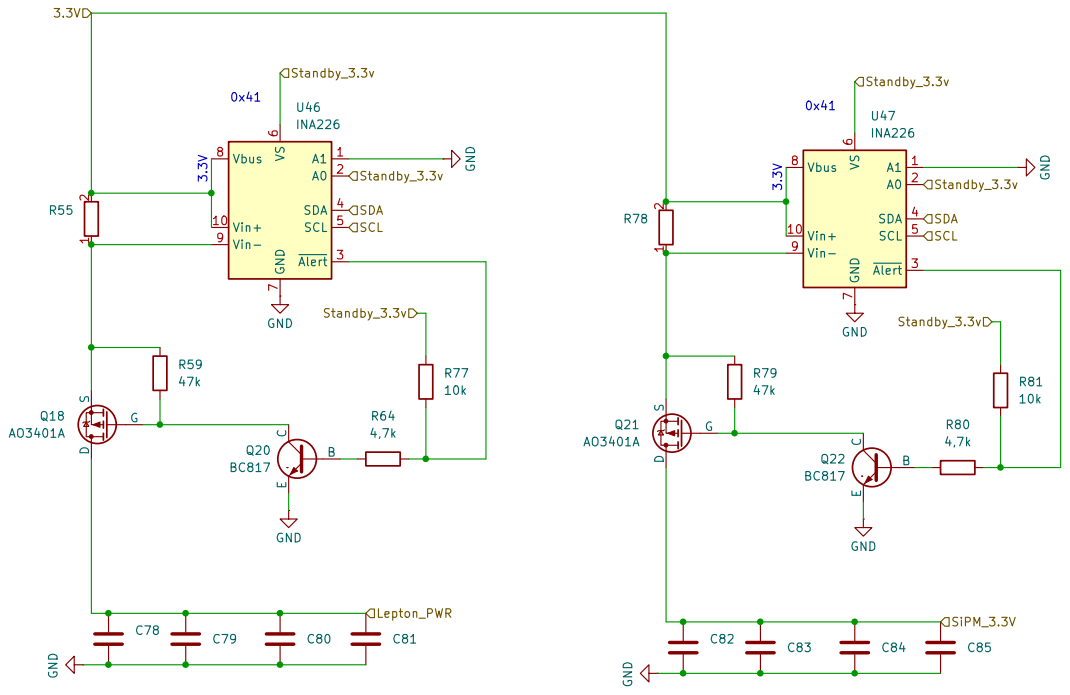
[picture p30: page 6]

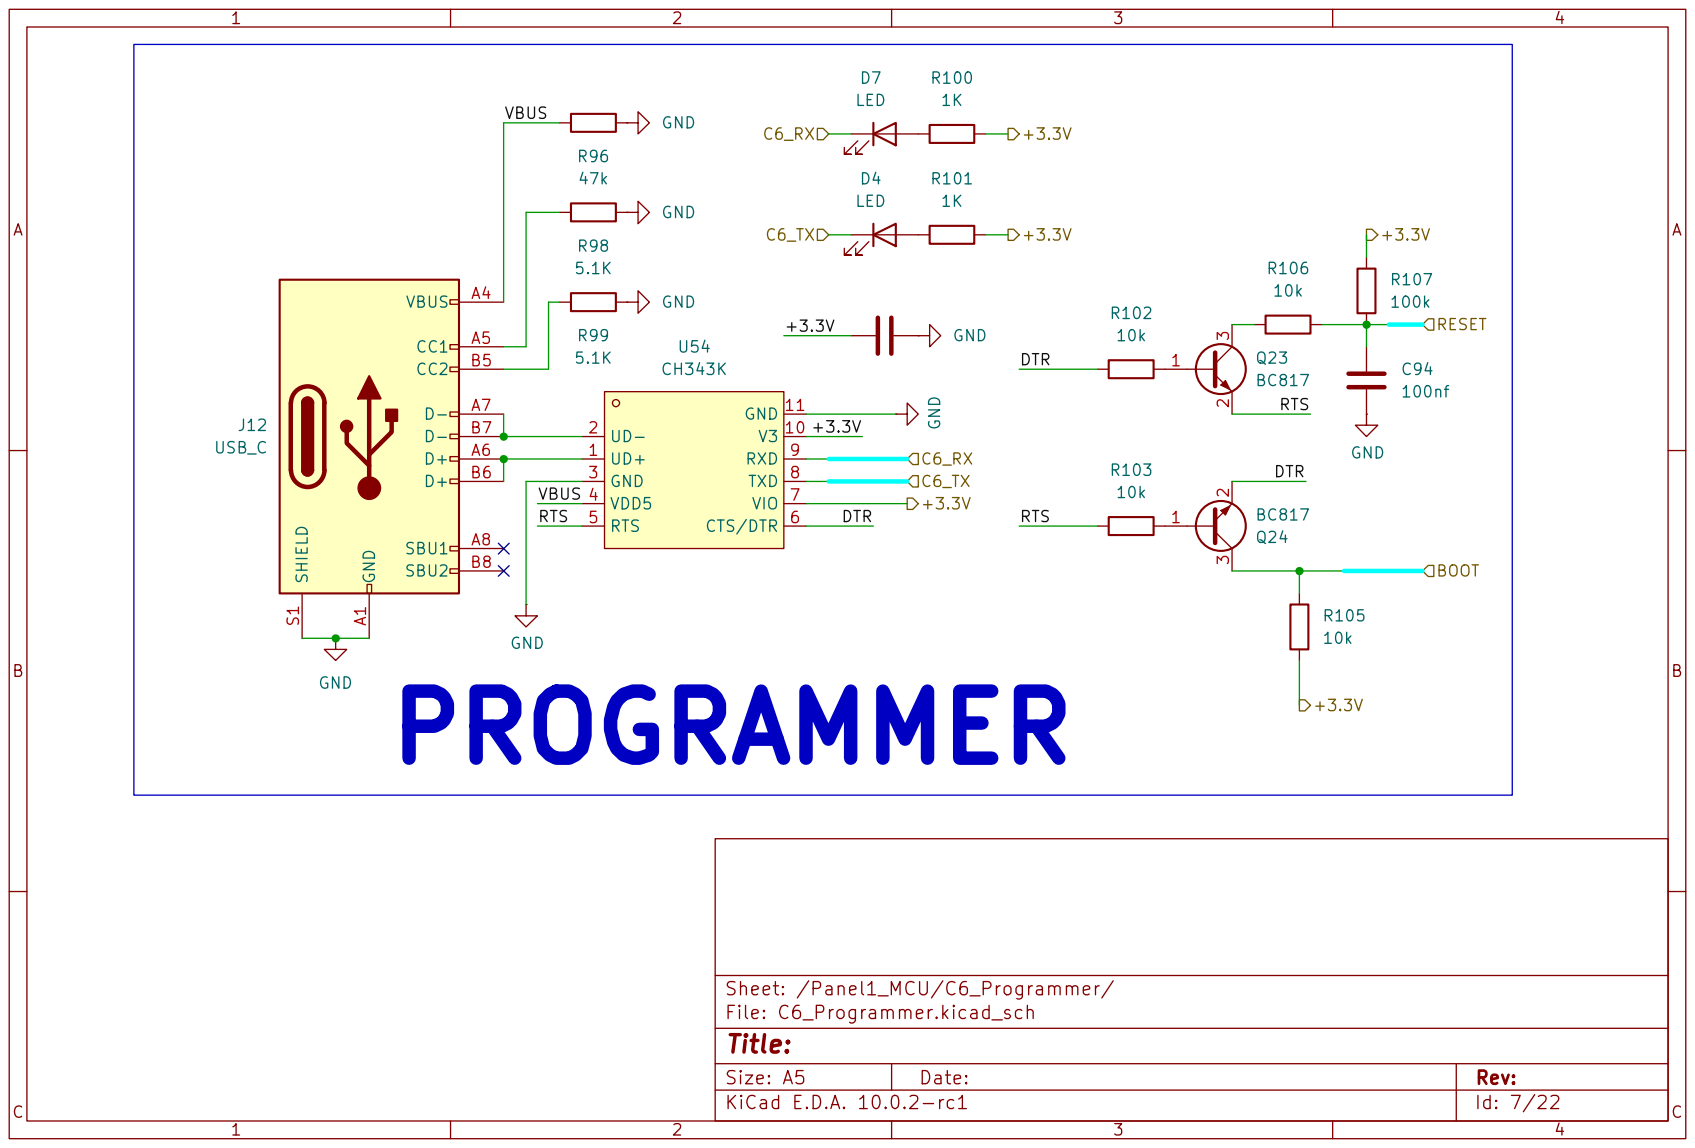
[picture p31: page 7]

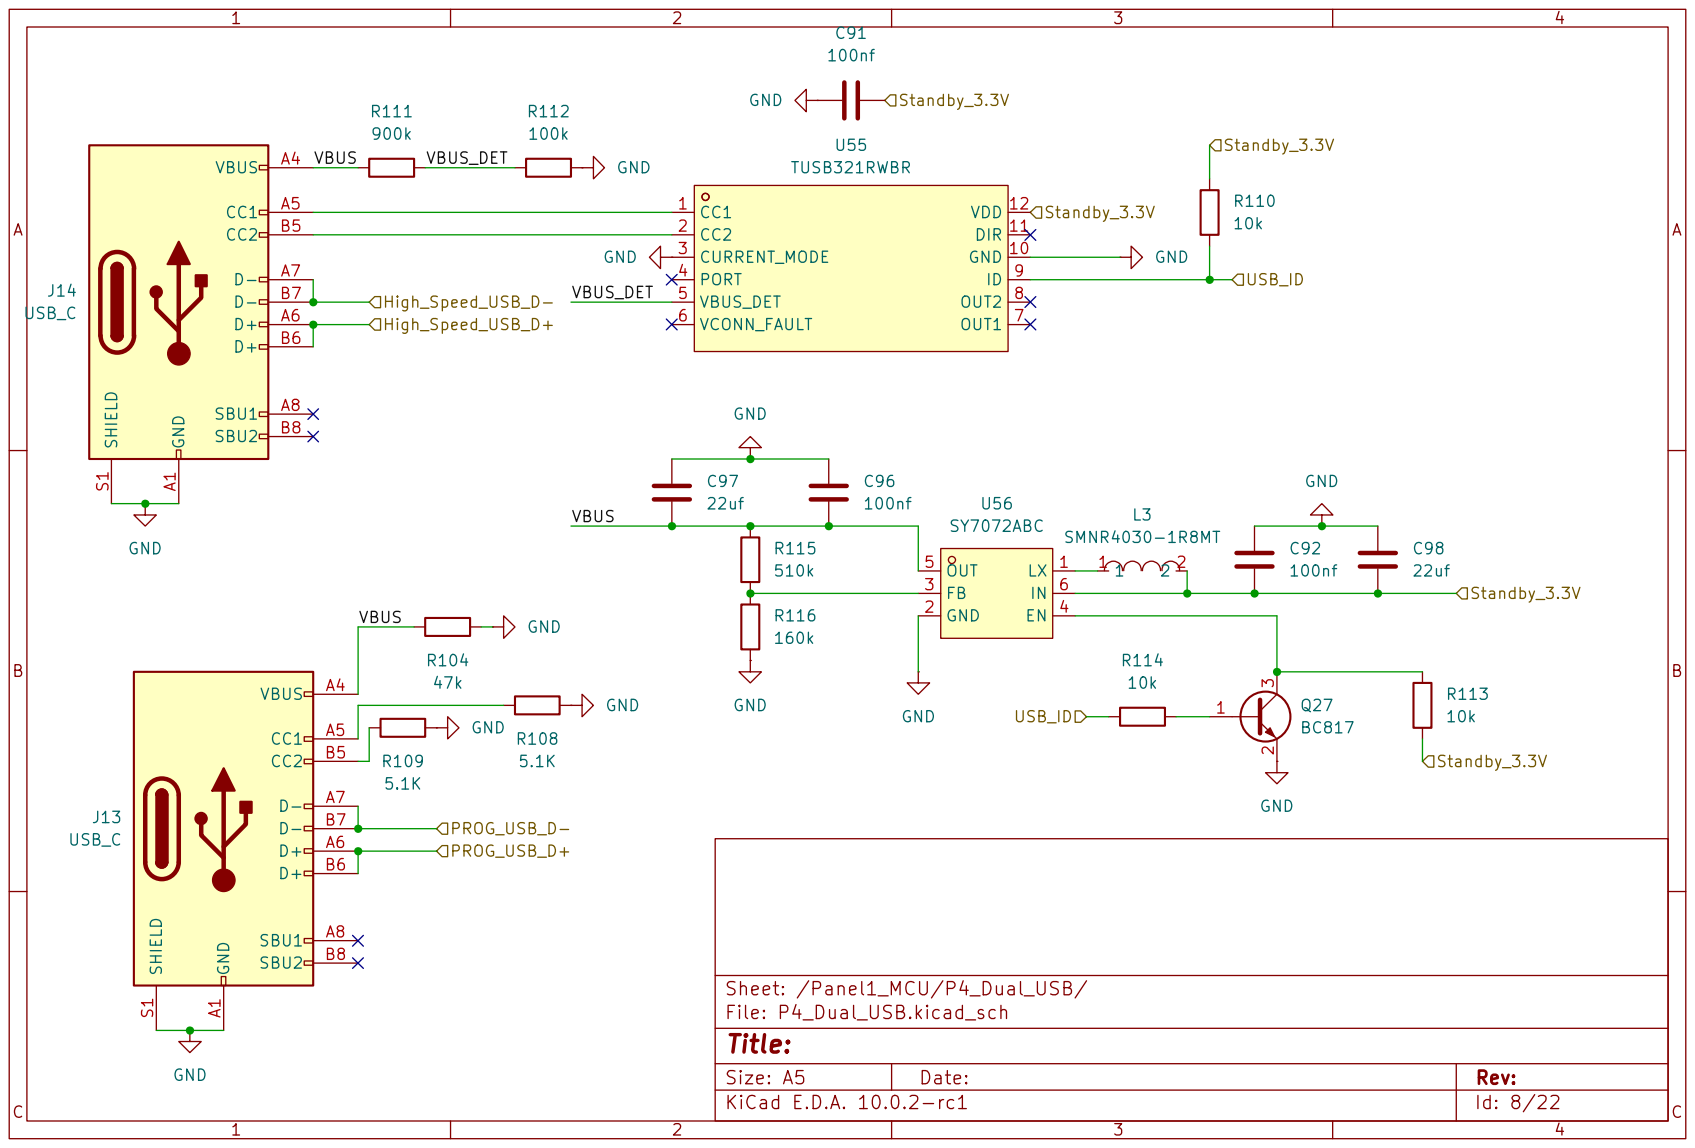
[picture p32: page 8]

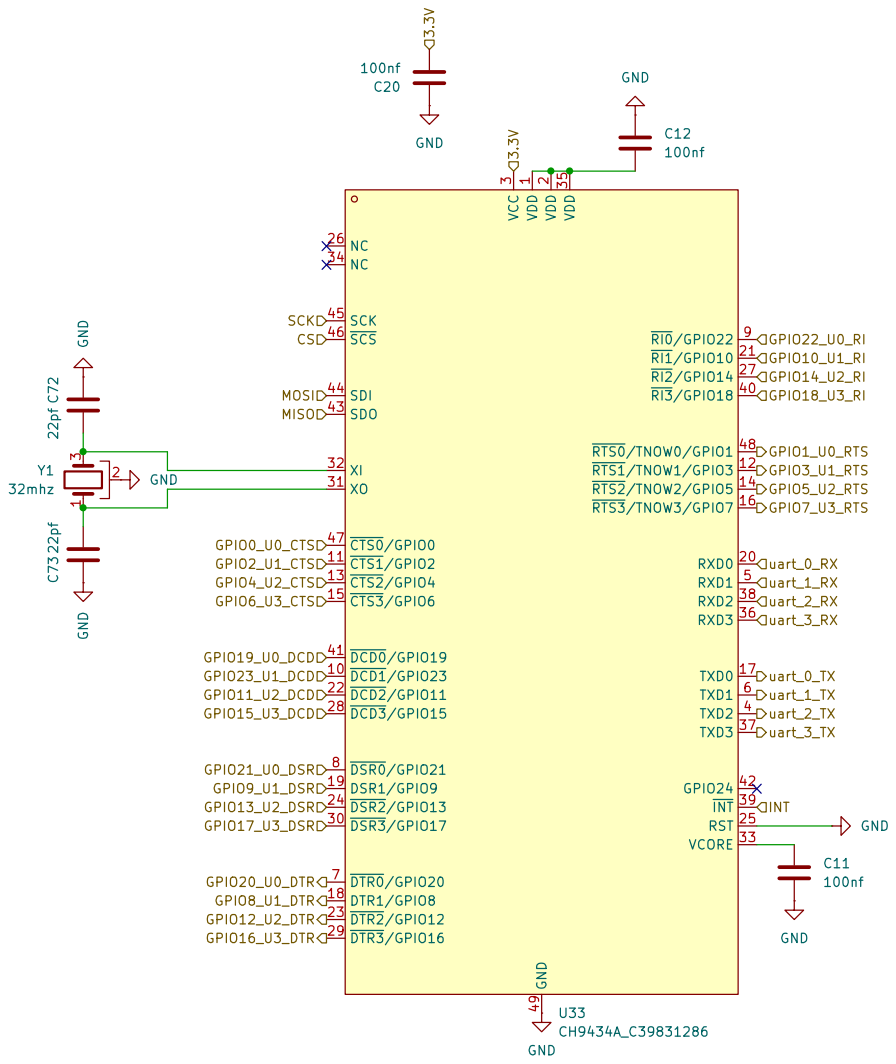
[picture p33: page 9]

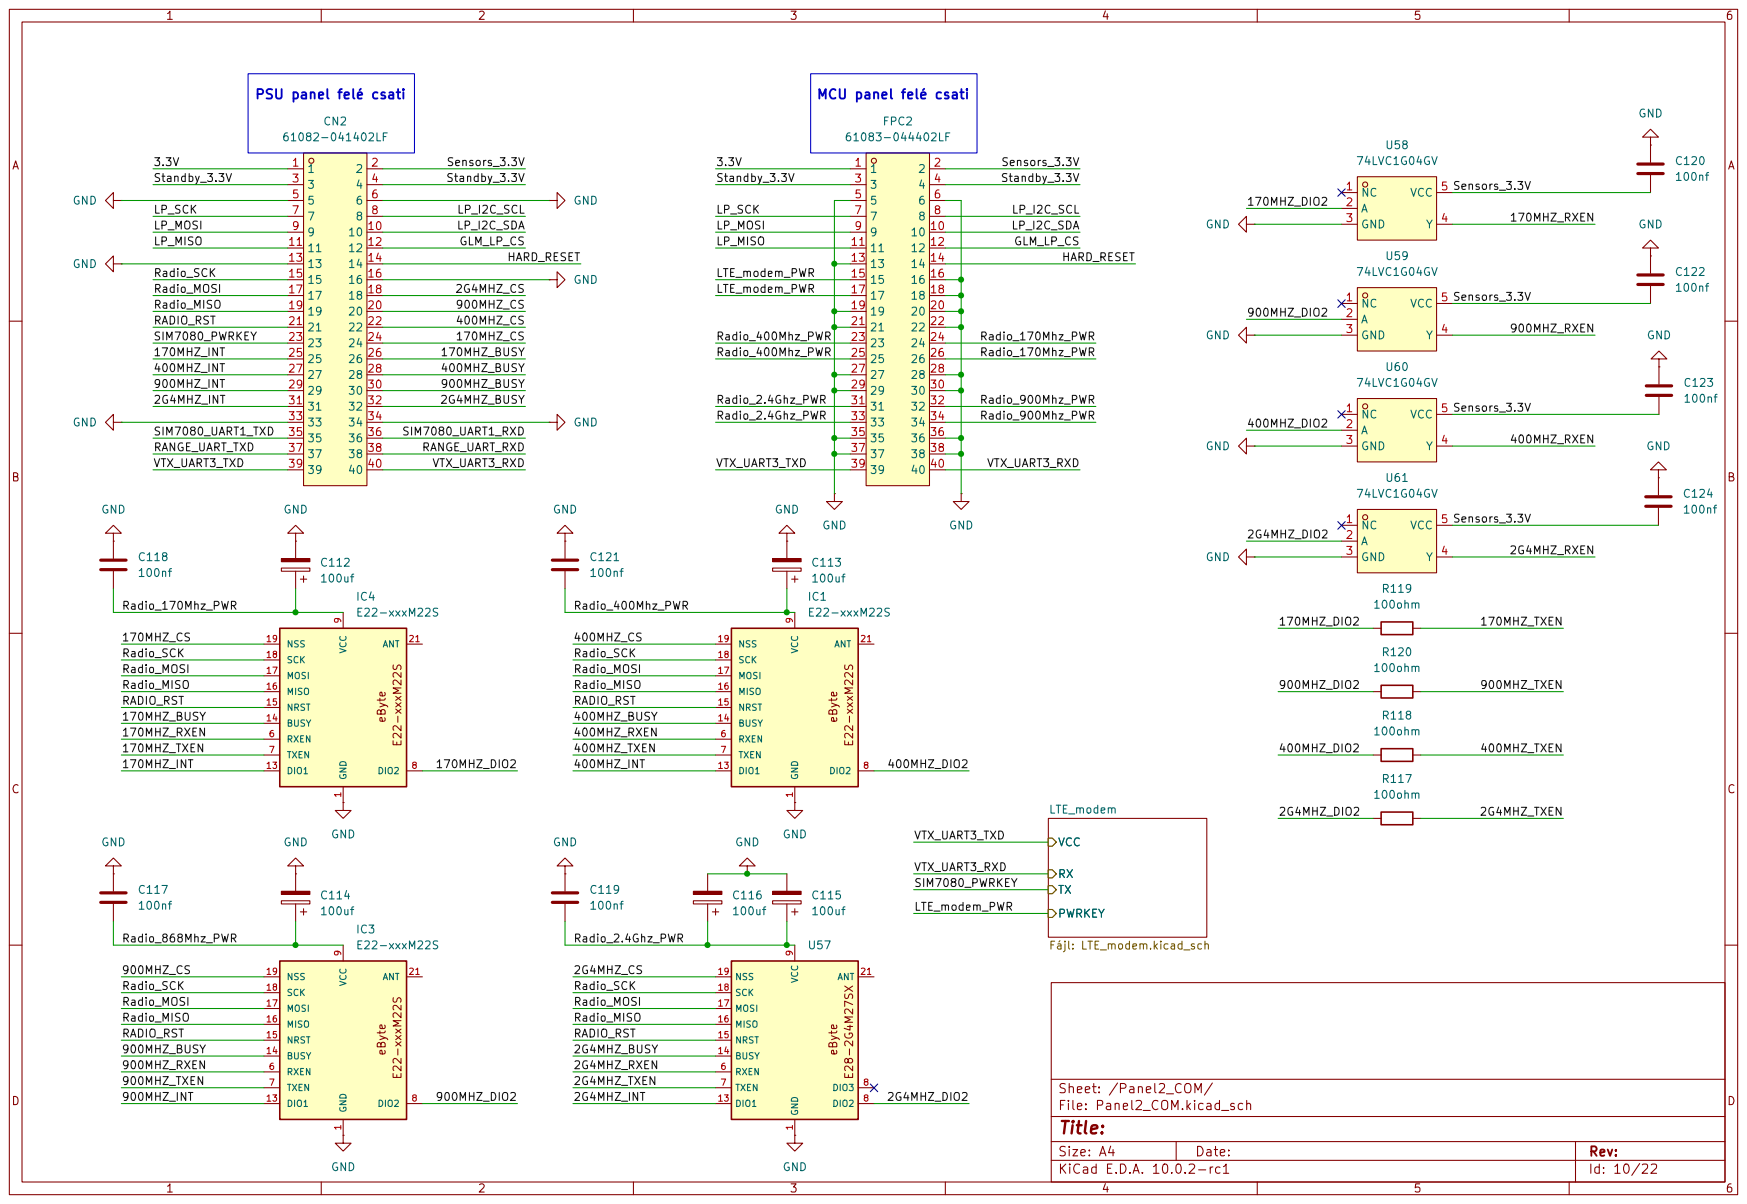
[picture p34: page 10]

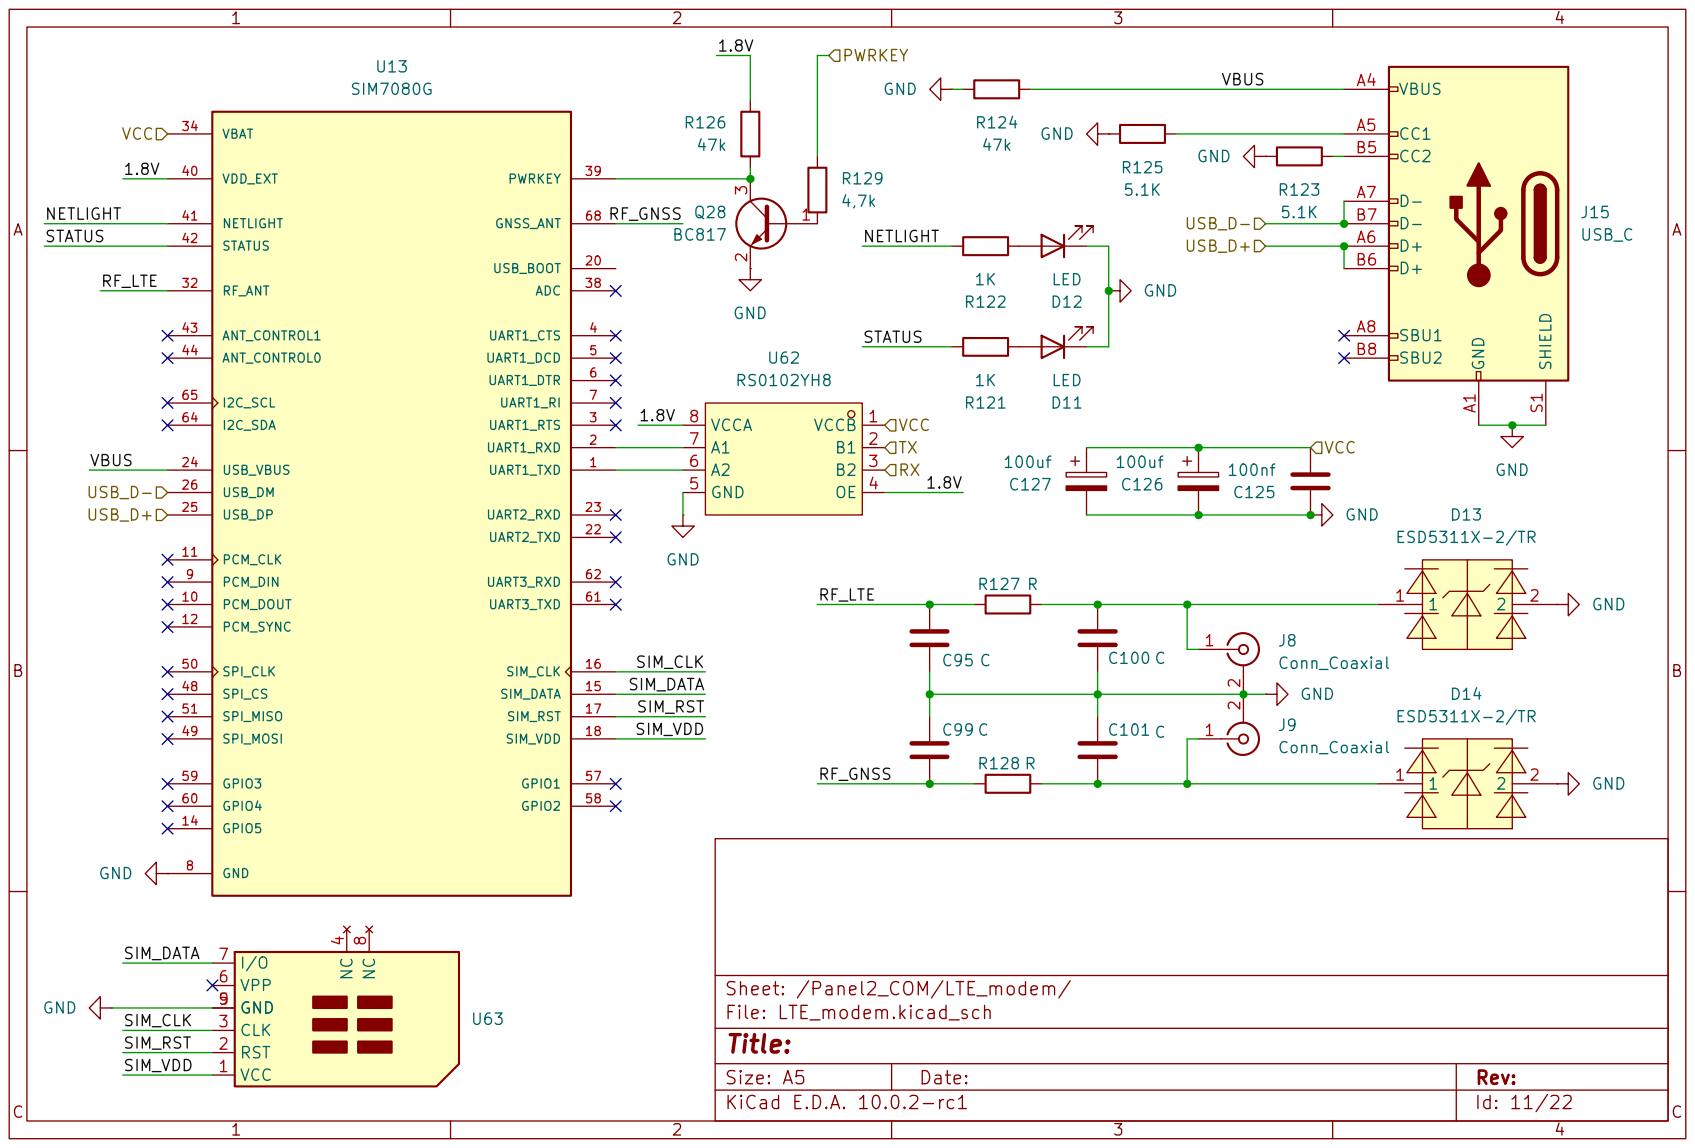
[picture p35: page 11]

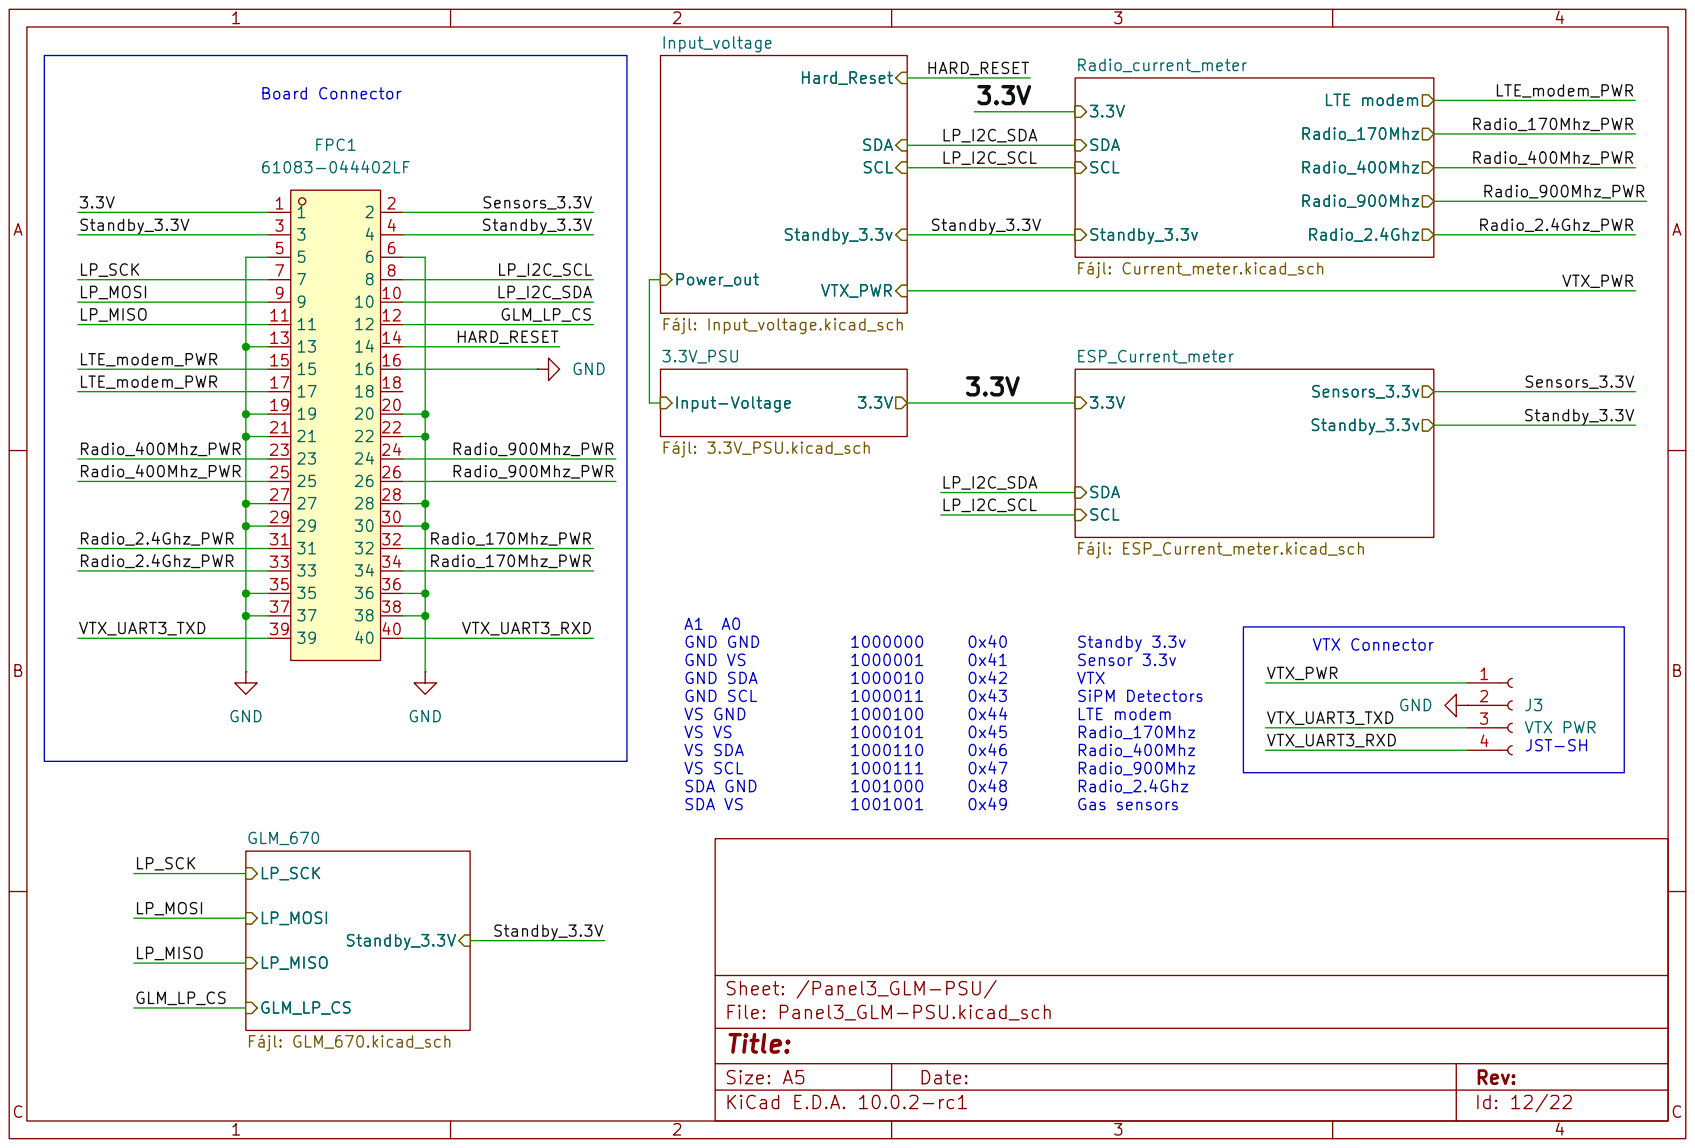
[picture p36: page 12]

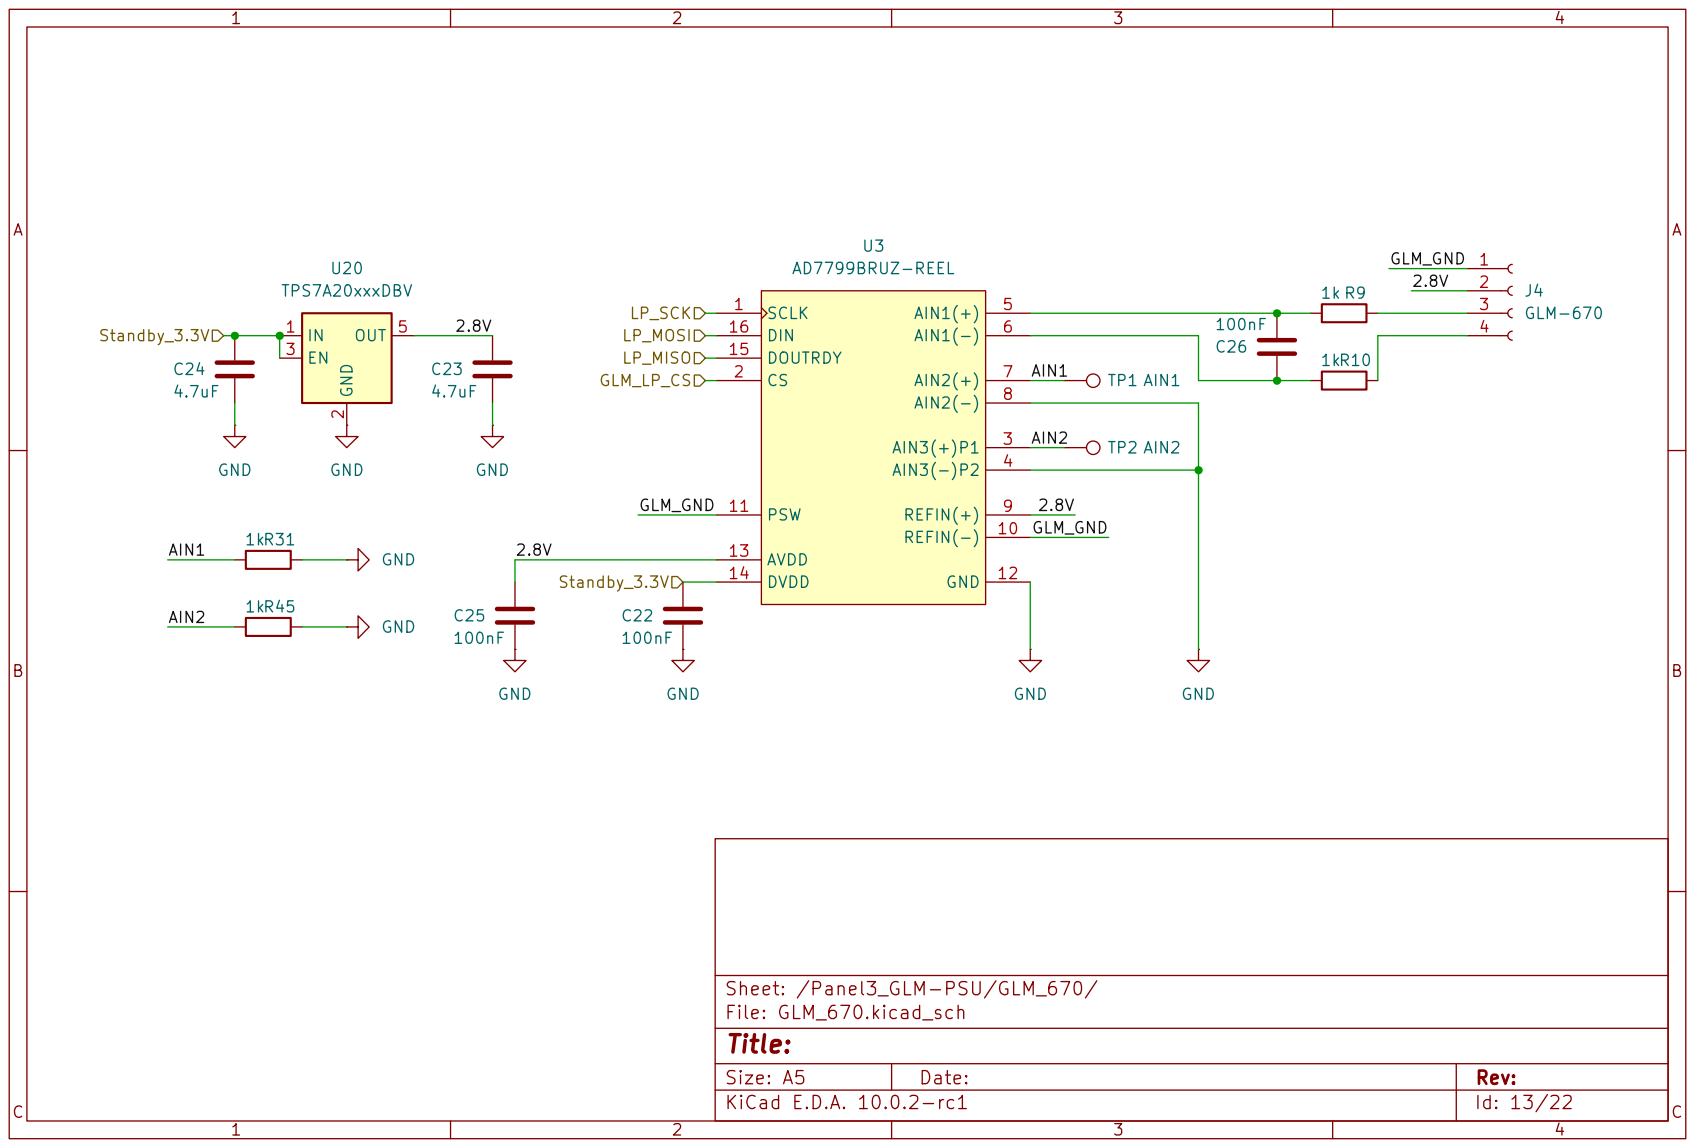
[picture p37: page 13]

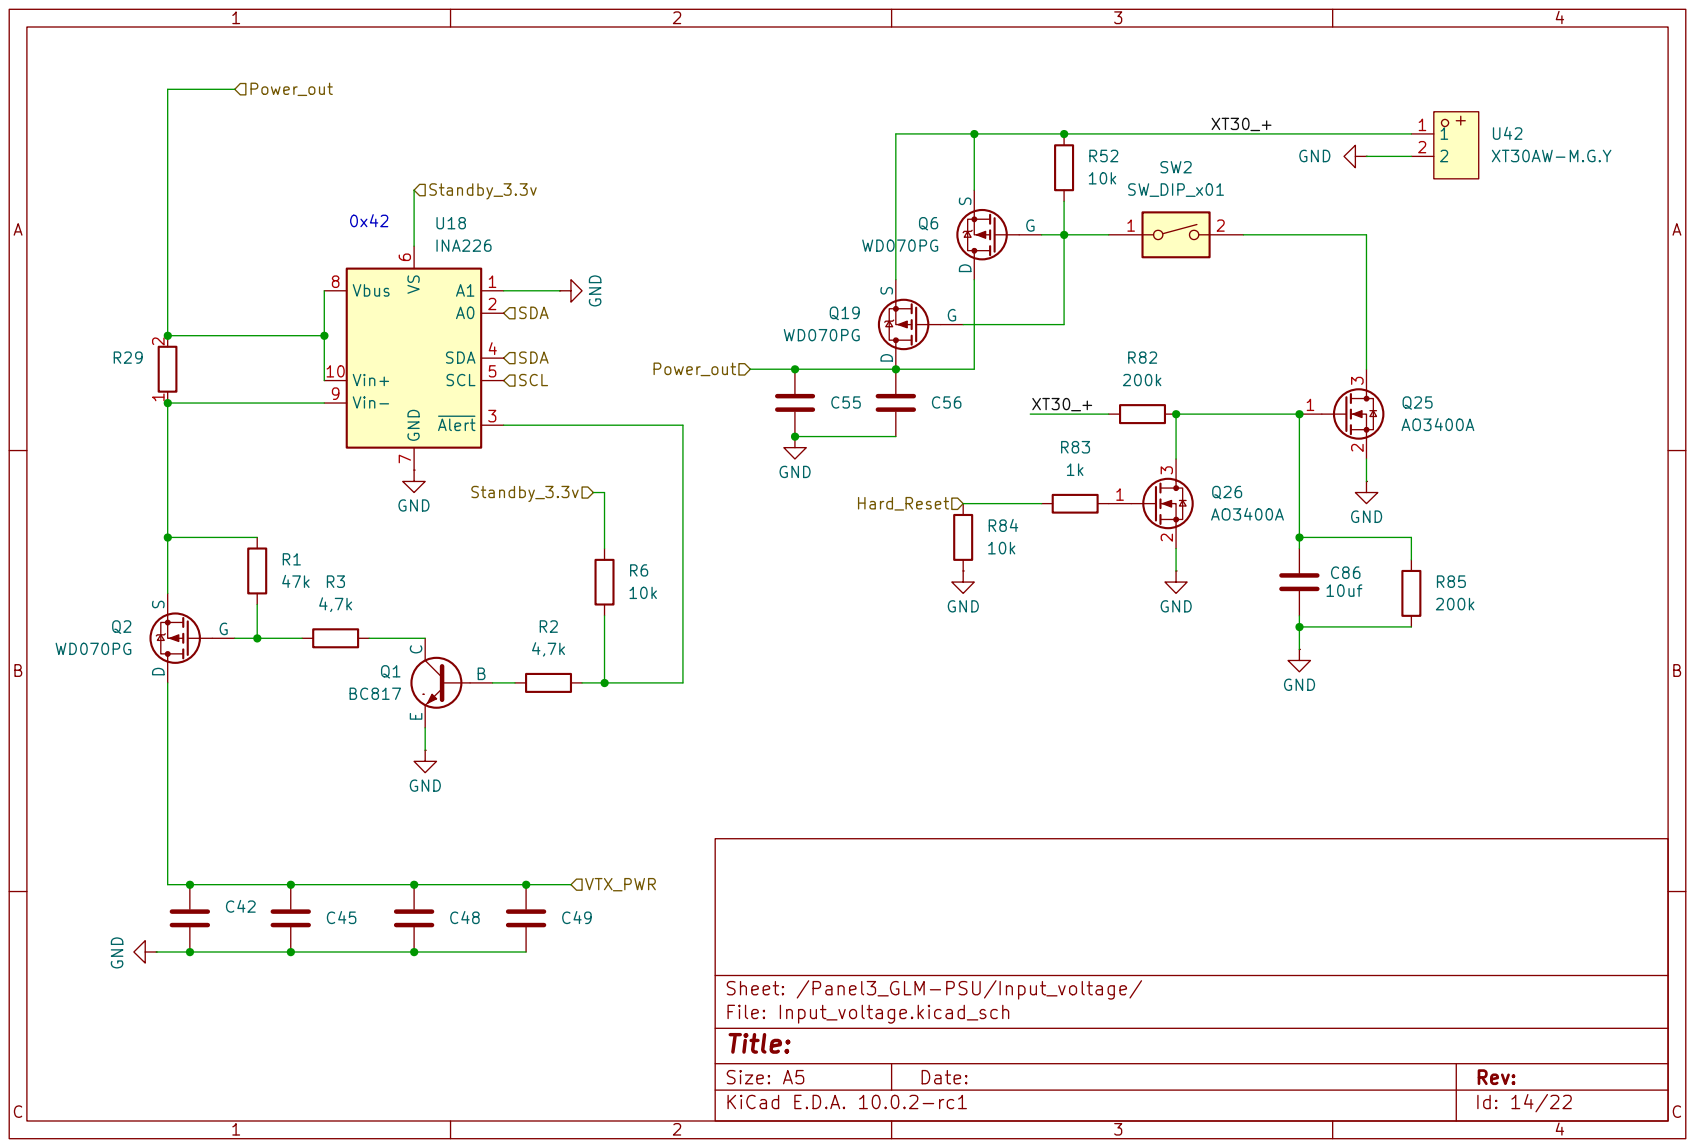
[picture p38: page 14]

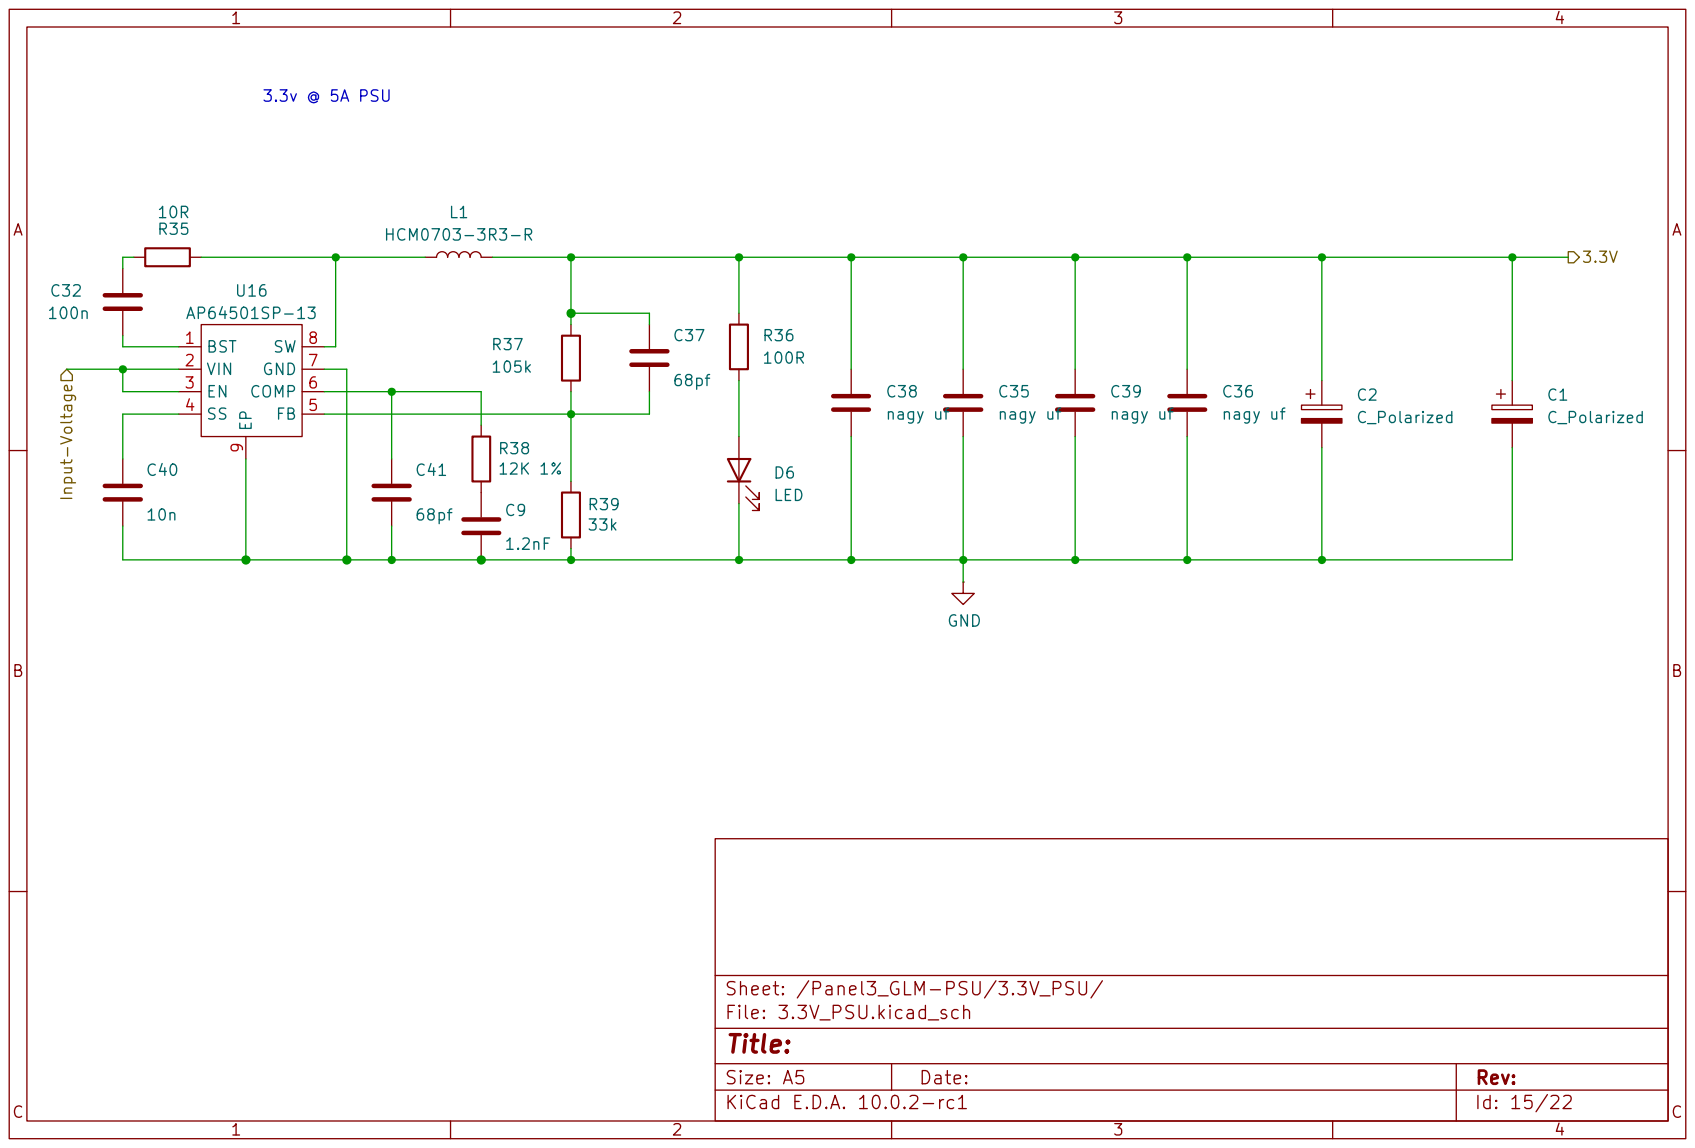
[picture p39: page 15]

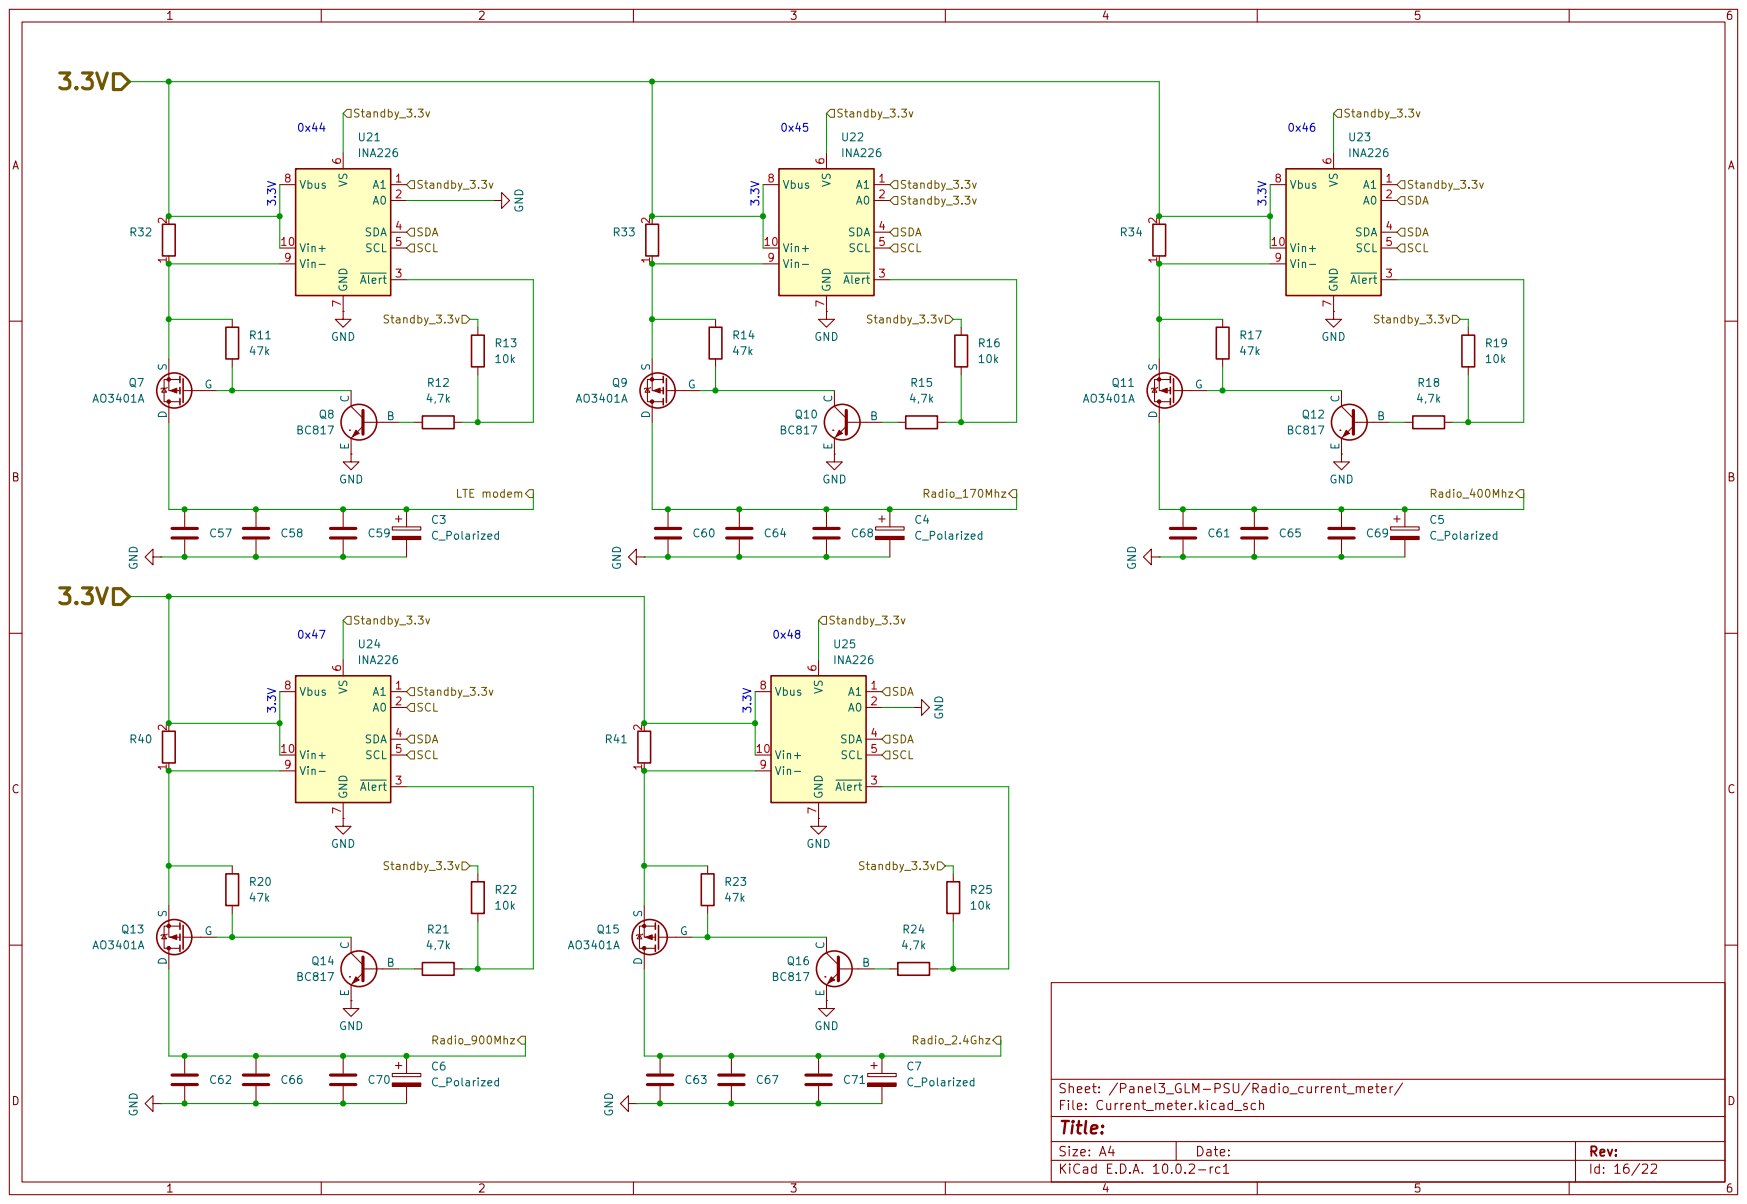
[picture p40: page 16]

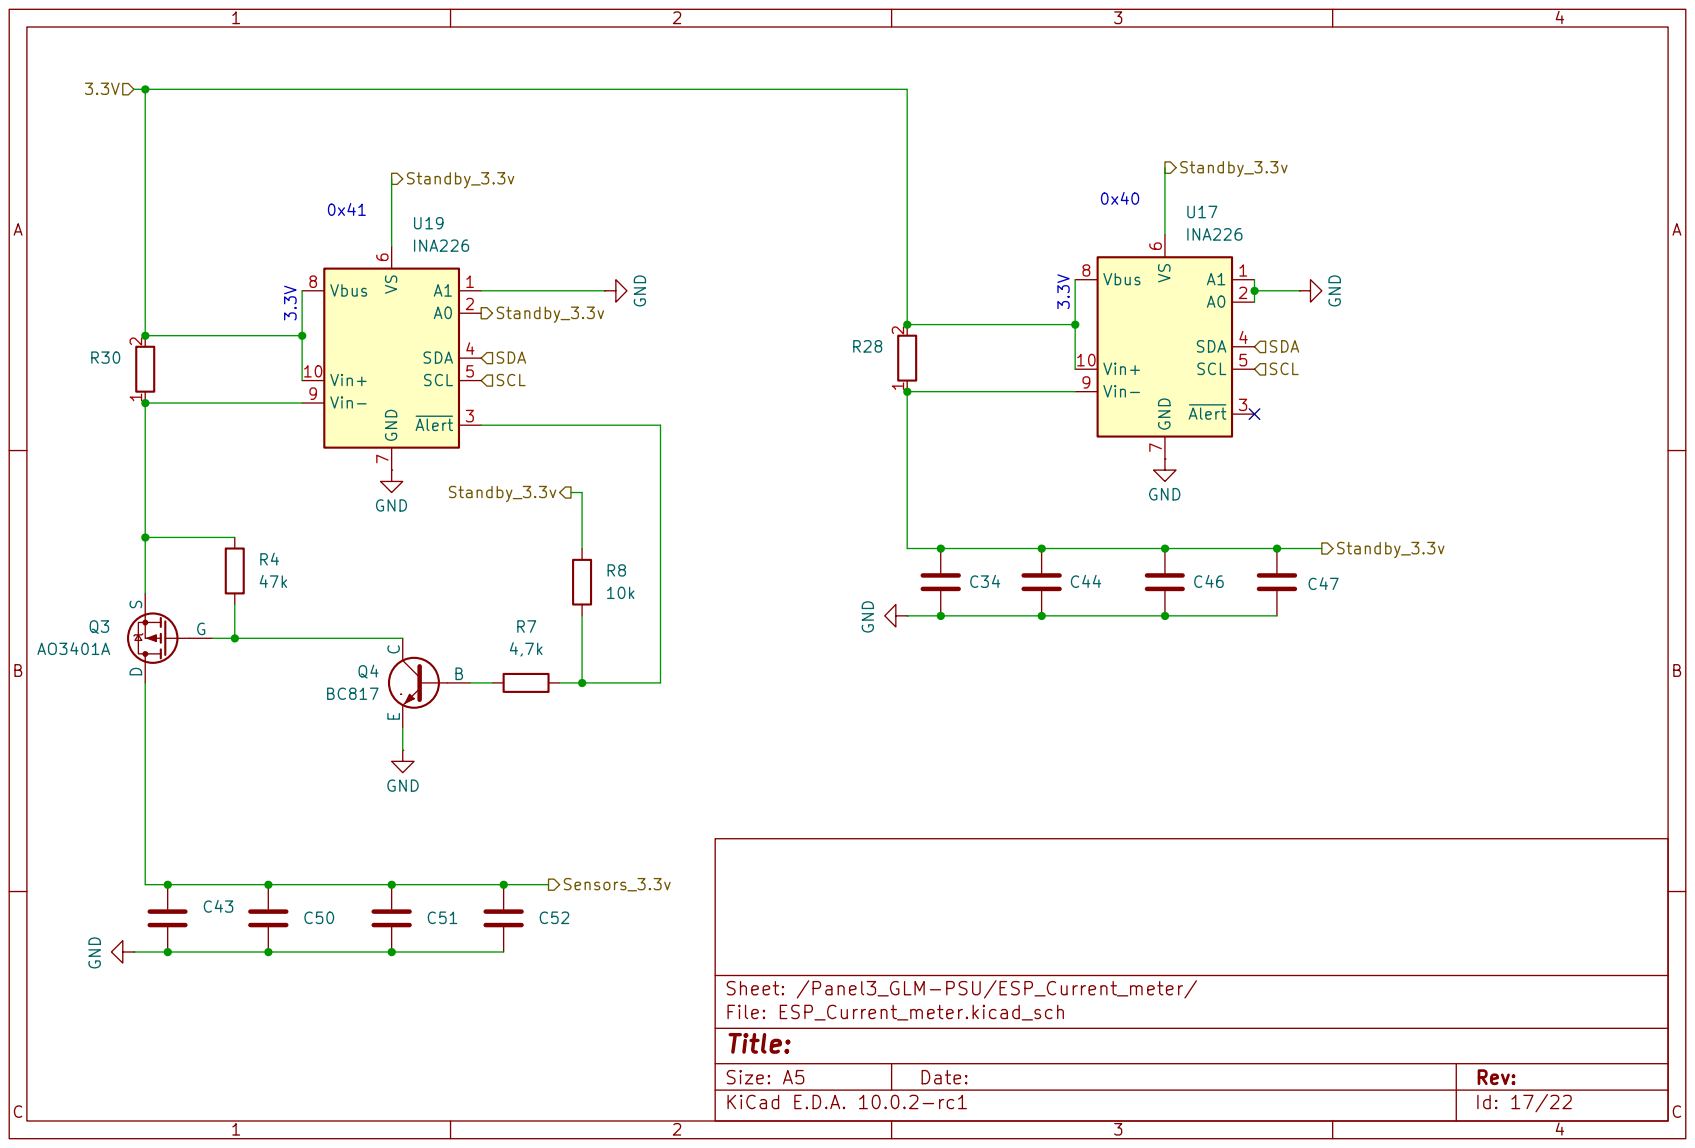
[picture p41: page 17]

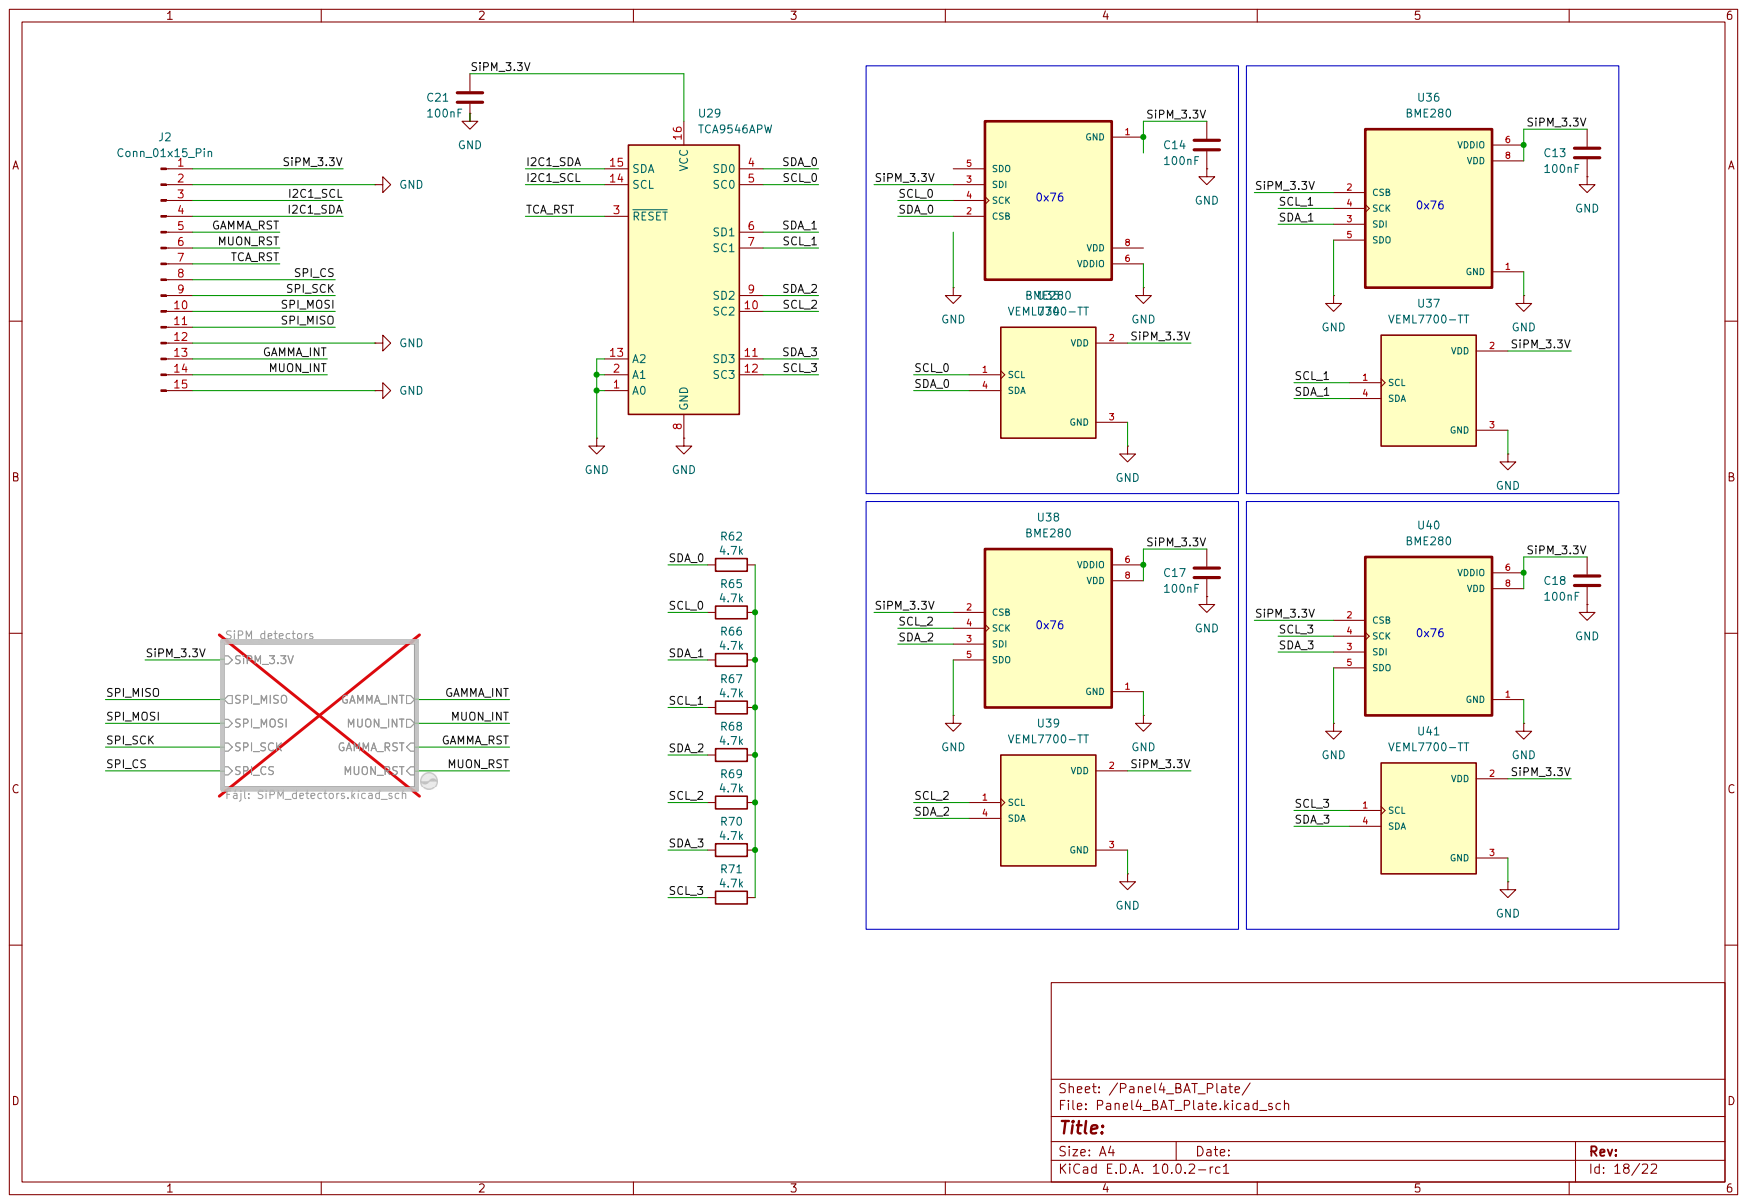
[picture p42: page 18]

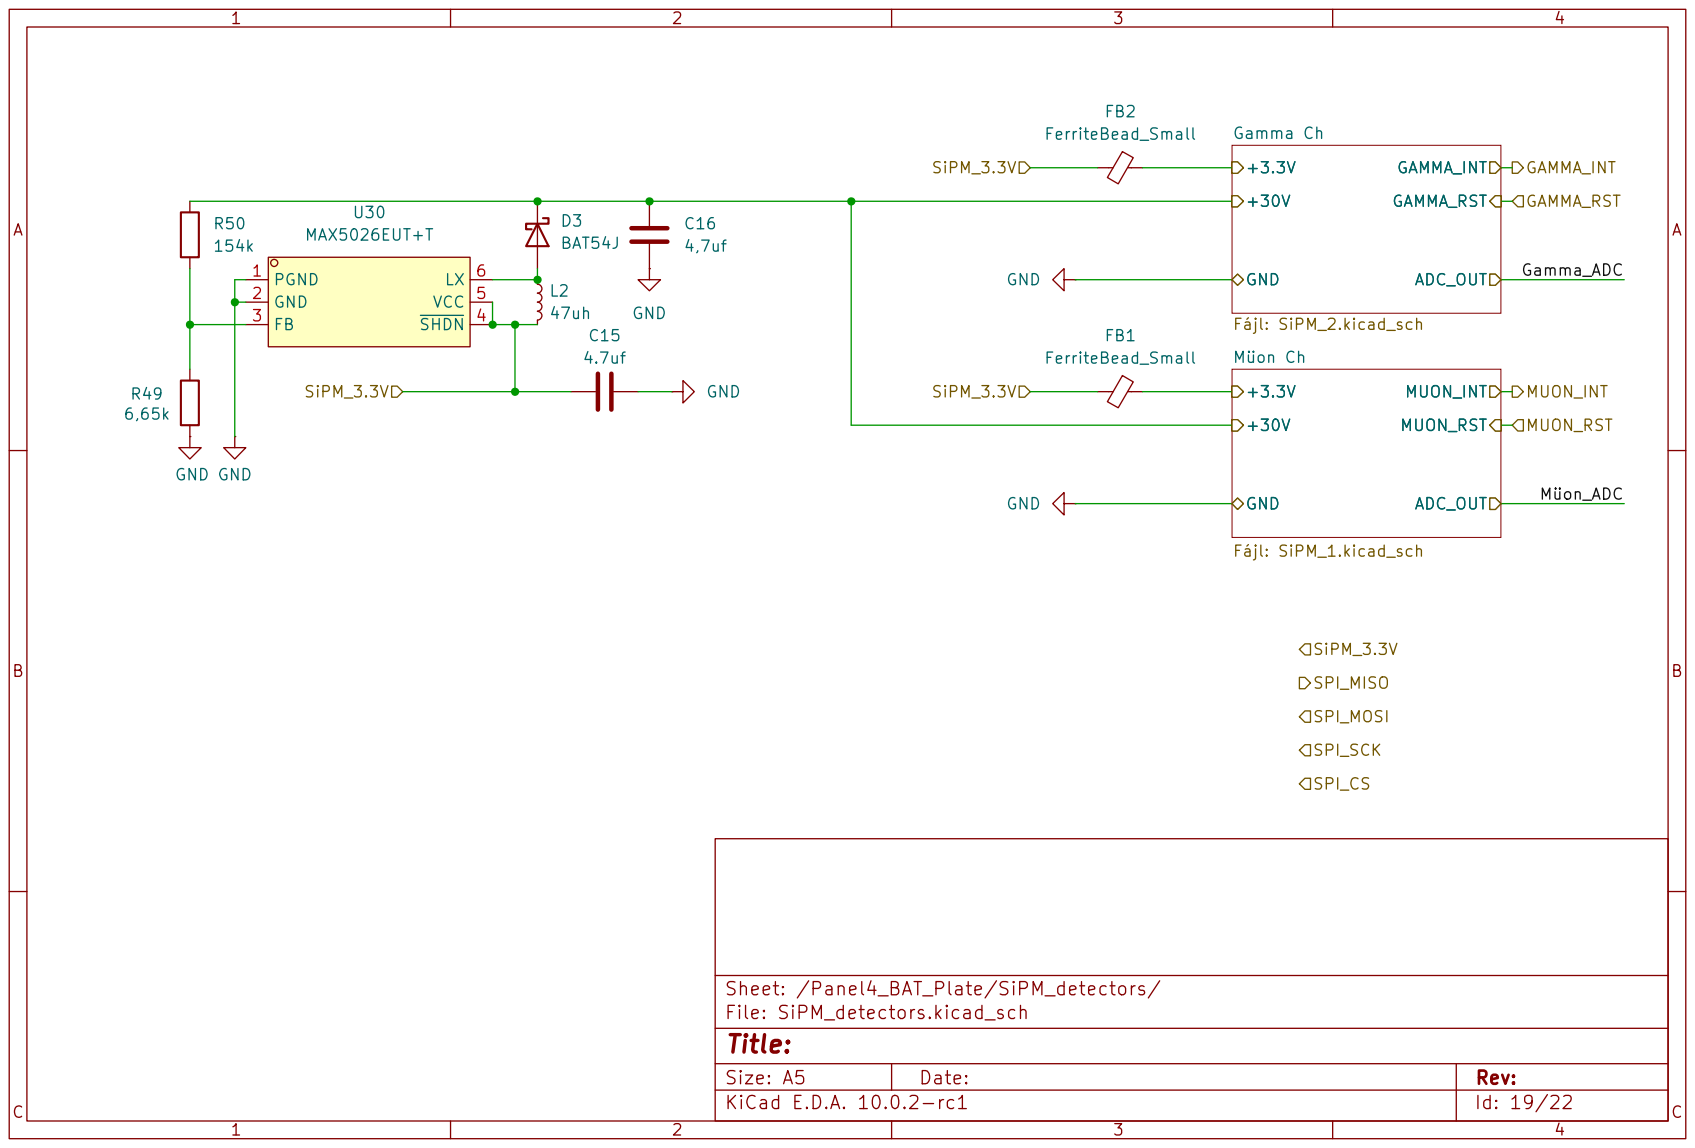
[picture p43: page 19]

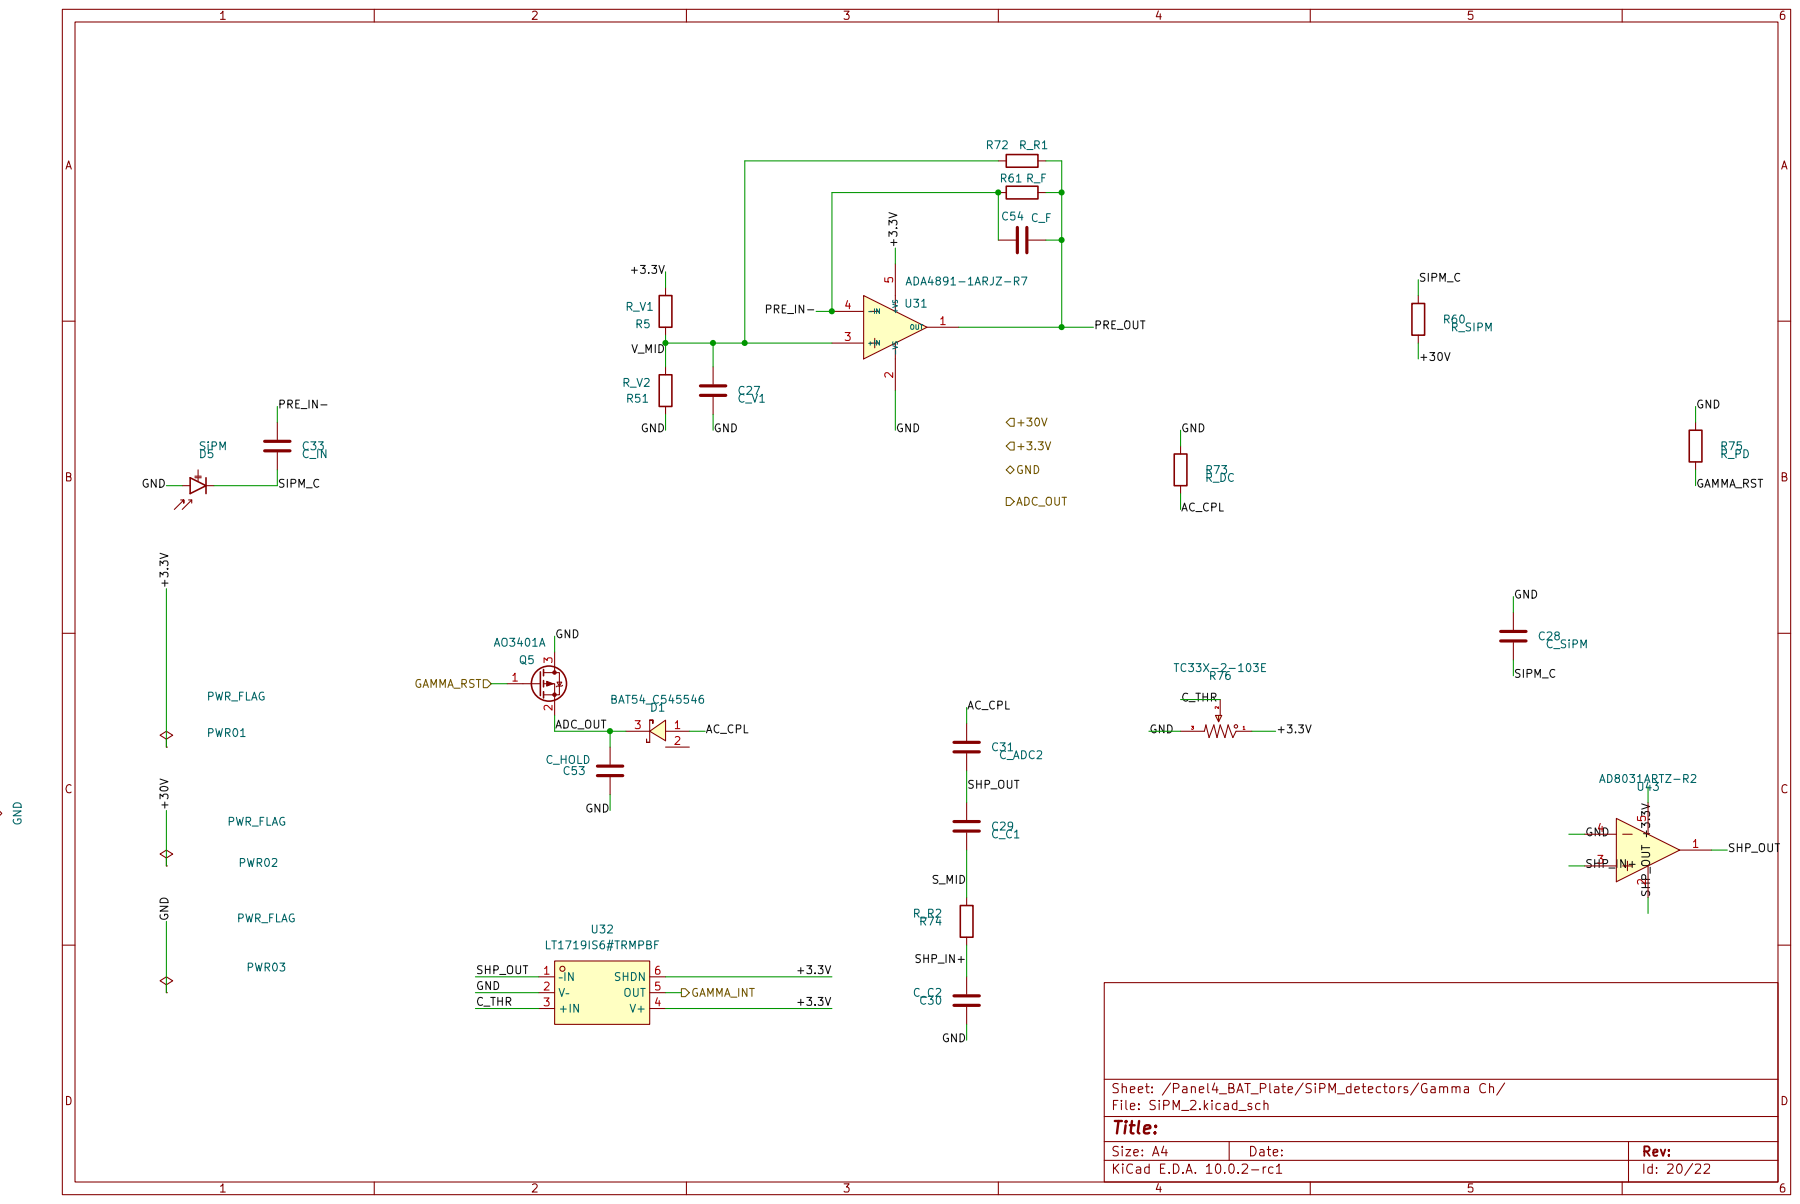
[picture p44: page 20]

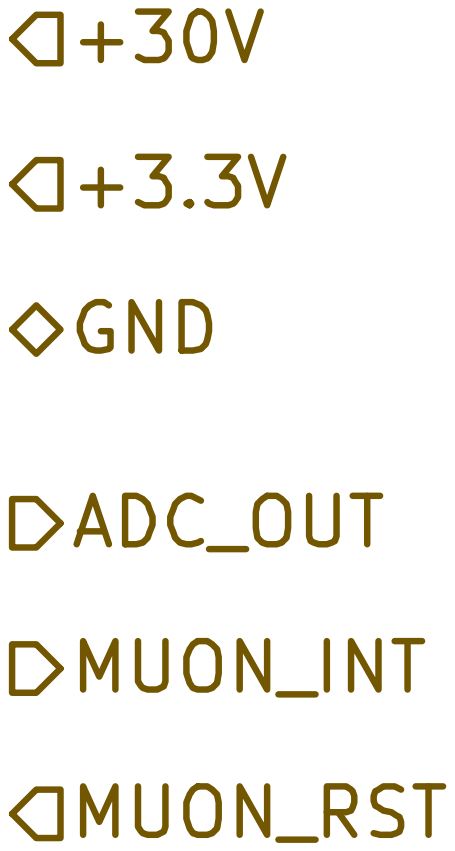
[picture p45: page 21]

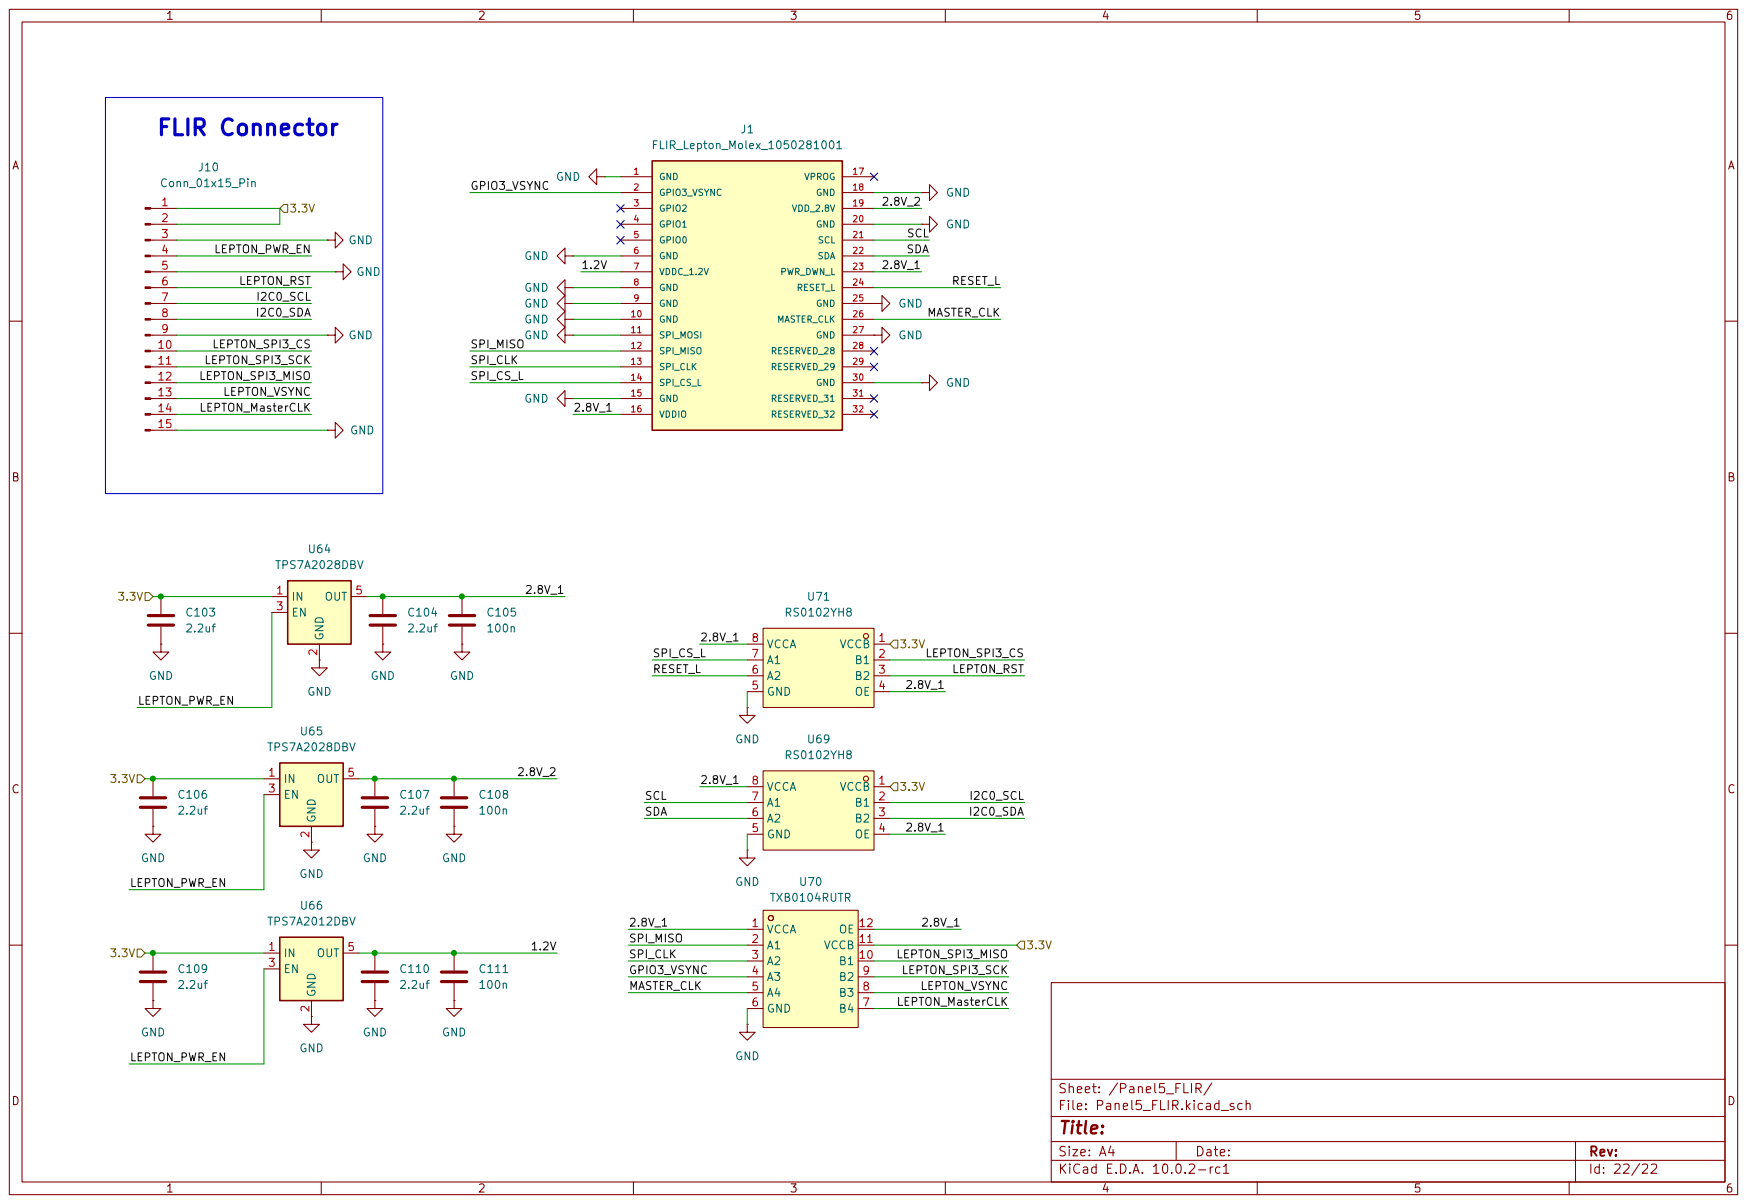
[picture p46: page 22]
