budabalint/T.E.E.M.O/Circuit/CanSat_V2/CanSat.kicad_pcb

## KiCad design Circuit/CanSat_V2/CanSat.kicad_pcb (2026-10-09)

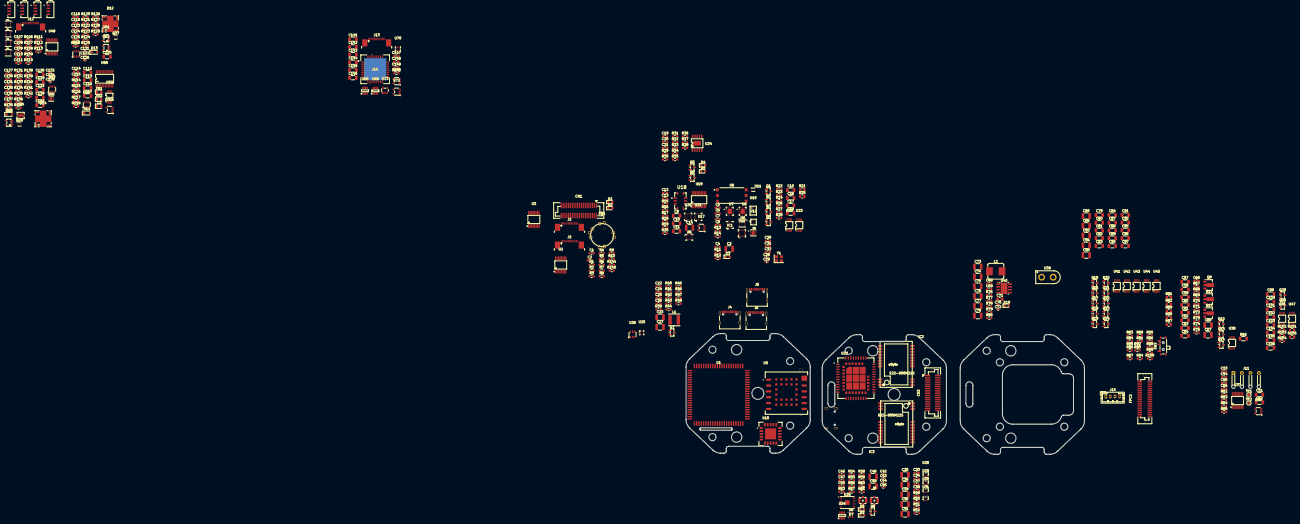
[picture p47: board Circuit/CanSat_V2/CanSat.kicad_pcb from above]

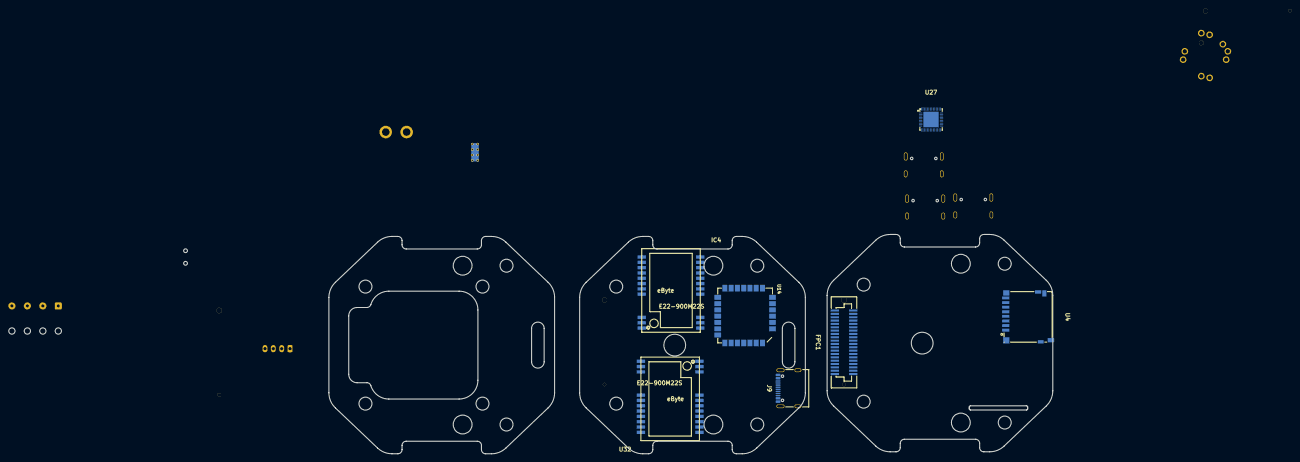
[picture p48: board Circuit/CanSat_V2/CanSat.kicad_pcb from below]

Board: 4 copper layers, 442 parts (7 on the bottom side), 345 nets, no tracks yet.

Parts:
C1, C2, C4, C5, C6, C7, C8, C12, C13, C19, C20, C21, C22, C24, C25, C26, C30, C31, C32, C33, C34, C37, C38, C46, C47, C50, C53, C54, C55, C56, C65, C68, C107, C108, C109, C110, C111, C114, C115, C118, C119, C123, C124, C125, C127, C130, C131, C135, C136, C137, C147, C148, C149: 100nF; C_0603_1608Metric_Pad1.08x0.95mm_HandSolder
C3, C14, C23, C27, C35, C36, C39, C40, C41, C48, C49, C66, C67, C73, C74, C75, C76, C77, C78, C85, C86, C93, C94, C98: 22uF; C_1210_3225Metric
C9, C10, C11, C15, C16, C17, C18, C51, C52, C57, C58, C59, C60, C61, C62, C63, C64, C79, C80, C81, C82, C83, C84, C87, C88, C89, C90, C91, C92, C95, C96, C97, C99, C100, C101, C102, C103, C104, C105, C106, C112, C113, C116, C117, C120, C128, C129, C133, C139, C140, C141, C142, C143, C144, C145, C146: 4.7uF; C_1206_3216Metric
C28, C29: 22pF; C_0402_1005Metric_Pad0.74x0.62mm_HandSolder
C42, C43, C44, C45: -; C_0402_1005Metric_Pad0.74x0.62mm_HandSolder
C69: 10nF; C_0603_1608Metric_Pad1.08x0.95mm_HandSolder
C70, C72: 68pF; C_0402_1005Metric_Pad0.74x0.62mm_HandSolder
C71: 1.2nF; C_0805_2012Metric_Pad1.18x1.45mm_HandSolder
C121: 10pF; C_0402_1005Metric_Pad0.74x0.62mm_HandSolder
C122: 47pF; C_0402_1005Metric_Pad0.74x0.62mm_HandSolder
C126, C138: 1nF; C_0402_1005Metric_Pad0.74x0.62mm_HandSolder
C132: 1pF; C_0402_1005Metric_Pad0.74x0.62mm_HandSolder
C134: 15pF; C_0402_1005Metric_Pad0.74x0.62mm_HandSolder
CN1, CN2: 61082-041402LF; CONN-SMD_61082-041402LF
D1, D2, D3, D4, D5, D8, D9, D10: LED; LED_0603_1608Metric_Pad1.05x0.95mm_HandSolder
D6, D7: ESD5311X-2/TR; D_0402_1005Metric_Pad0.77x0.64mm_HandSolder
D11: BAT54J; D_SOD-323_HandSoldering
D12, D14: SiPM; OPTO-SMD_4P-MICROFC-60035-SMT-TR
D13, D15: TECH PUBLIC BAS70WS; D_SOD-323_HandSoldering
FB1, FB2: FerriteBead_Small; D_0805_2012Metric
FPC1, FPC2: 61083-044402LF; FPC-SMD_40P-P0.80_61083-044402LF
IC1: ZMOD4510AI1V
IC2, IC3, IC4: E22-xxxM22S; E22-400M22S
J2, J3, J12, J13: Conn_01x15_Pin; TE_1-1734839-5_1x15-1MP_P0.5mm_Horizontal
J4, J5, J6, J9: USB_C; USB_C_Receptacle_Palconn_UTC16-G
J7, J8: U-Fl-IPEX; IPEX-SMD_4P-L2.6-W2.6-LS3.1
J10: VTX PWR; JST_PH_B4B-PH-K_1x04_P2.00mm_Vertical
J11: GLM-670; SolderWire-0.127sqmm_1x04_P3.7mm_D0.48mm_OD1mm_Relief
J14: FLIR_Lepton_Molex_1050281001; flir_CONN_1050282031_MOL
L1: SMNR4030-1R8MT; L_Taiyo-Yuden_NR-50xx
L2: FXL0630-3R3-M; L_Bourns_SRP7028A_7.3x6.6mm
L3: 47uh; D_0805_2012Metric
MT1: ICM-42670-P; XDCR_ICM-42670-P
Q1, Q3, Q15, Q16, Q19, Q20, Q23, Q25: AO3401A; SOT-23
Q2, Q4, Q5, Q6, Q7, Q8, Q10, Q17, Q18, Q21, Q22, Q24, Q26: BC817; SOT-23
Q9, Q11, Q12: WD070PG; SOT-89-3
Q13, Q14: AO3400A; SOT-23
Q27, Q28: XNRUSEMI XR2SK3019; SOT-523
R1, R121, R125, R129, R142: 33Ω; R_0603_1608Metric_Pad0.98x0.95mm_HandSolder
R2, R3, R4, R5: 2.2kΩ; R_0603_1608Metric_Pad0.98x0.95mm_HandSolder
R6, R10, R12: 220Ω; R_0603_1608Metric_Pad0.98x0.95mm_HandSolder
R7, R8, R9, R18, R19, R20, R22, R26, R29, R41, R55, R59, R67, R83, R84, R91, R92, R98, R102, R143, R144, R145: 47kΩ; R_0603_1608Metric_Pad0.98x0.95mm_HandSolder
R11, R24, R28, R34, R35, R36, R37, R46, R47, R48, R70, R71, R72, R87, R88, R95, R96, R100, R104, R122, R134: 10kΩ; R_0603_1608Metric_Pad0.98x0.95mm_HandSolder
R13: 18kΩ; R_0603_1608Metric_Pad0.98x0.95mm_HandSolder
R14, R38, R43, R128, R138, R139, R141: 100kΩ; R_0603_1608Metric_Pad0.98x0.95mm_HandSolder
R15: 20Ω; R_0603_1608Metric_Pad0.98x0.95mm_HandSolder
R16: 12.4Ω; R_0603_1608Metric_Pad0.98x0.95mm_HandSolder
R17: 42.2Ω; R_0603_1608Metric_Pad0.98x0.95mm_HandSolder
R21, R25, R81, R82, R89, R90, R97, R101, R105: shunt; R_0805_2012Metric
R23, R27, R58, R68, R69, R85, R86, R93, R94, R99, R103, R106, R107, R108, R109, R110, R111, R112, R113, R124: 4.7kΩ; R_0603_1608Metric_Pad0.98x0.95mm_HandSolder
R30, R31, R40, R42, R60, R61: 5.1kΩ; R_0603_1608Metric_Pad0.98x0.95mm_HandSolder
R32, R33, R56, R57, R62, R63, R64, R65, R73, R119, R123, R126, R127, R130, R136: 1kΩ; R_0603_1608Metric_Pad0.98x0.95mm_HandSolder
R39: 910kΩ; R_0603_1608Metric_Pad0.98x0.95mm_HandSolder
R44: 510kΩ; R_0603_1608Metric_Pad0.98x0.95mm_HandSolder
R45: 160kΩ; R_0603_1608Metric_Pad0.98x0.95mm_HandSolder
R49, R50, R51, R52, R80, R133: 100Ω; R_0603_1608Metric_Pad0.98x0.95mm_HandSolder
R53, R54: 0Ω; R_0603_1608Metric_Pad0.98x0.95mm_HandSolder
R66: shunt; R_1206_3216Metric
R74, R75: 200kΩ; R_0603_1608Metric_Pad0.98x0.95mm_HandSolder
R76: 10Ω; R_0603_1608Metric_Pad0.98x0.95mm_HandSolder
R77: 12kΩ; R_0603_1608Metric_Pad0.98x0.95mm_HandSolder
R78: 105kΩ; R_0603_1608Metric_Pad0.98x0.95mm_HandSolder
R79: 33kΩ; R_0603_1608Metric_Pad0.98x0.95mm_HandSolder
R114: 68kΩ; R_0603_1608Metric_Pad0.98x0.95mm_HandSolder
R115: 154kΩ; R_0603_1608Metric_Pad0.98x0.95mm_HandSolder
R116: 6,65kΩ; R_0603_1608Metric_Pad0.98x0.95mm_HandSolder
R117: 470kΩ; R_0603_1608Metric_Pad0.98x0.95mm_HandSolder
R118: 39kΩ; R_0603_1608Metric_Pad0.98x0.95mm_HandSolder
R120, R131: 470Ω; R_0603_1608Metric_Pad0.98x0.95mm_HandSolder
R132: 50Ω; R_0603_1608Metric_Pad0.98x0.95mm_HandSolder
R135: 680Ω; R_0603_1608Metric_Pad0.98x0.95mm_HandSolder
R137: 24kΩ; R_0603_1608Metric_Pad0.98x0.95mm_HandSolder
R140: 150kΩ; R_0603_1608Metric_Pad0.98x0.95mm_HandSolder
SW1: RKJXM1015001; SW-TH_RKJXM1015001
SW2: Power sw; SW_SPDT_PCM12
TP1: AIN1; TestPoint_Pad_D1.5mm
TP2: AIN2; TestPoint_Pad_D1.5mm
U1: ESP32-P4-Module; ESP32-P4
U2, U3: SN74LVC138ADGVR; TSSOP-16_L5.0-W4.4-P0.65-LS6.4-BL
U4: 114-00841-68; SIM-SMD_114-00841-68
U5: LC86G; XCVR_LC86G
U6: SFA 40; SFA40
U7: STC42A
U8: STC31-C-R3; STC42A
U9: SGP41-D-R4; XDCR_SGP41-D-R4
U10: SCD41-D-R2; XDCR_SCD41-D-R2
U11: SHT41-AD1B-R2; SHT4X
U12: BMP581; LGA-10_L2.0-W2.0-P0.50-TL_BMP581
U13: BME688; IC_BME688
U14: RadNano
U15: AS7331_M OLGA16 LF T&RDP; OLGA-16_L3.7-W2.6-P0.50-TL_AS7331-AQFM
U16: AS7343L-DLGM; LGA-16_L3.0-W3.0-P0.50-BL
U17, U36, U60, U71, U72: TPS7A2028DBV; SOT-23-5_L2.9-W1.6-P0.95-LS2.7-BR
U18: MICS-6814; SENSOR_MICS-6814
U19: AD7091R-4BRUZ; TSSOP-20_L6.5-W4.4-P0.65-LS6.4-BL
U20: H3LIS331DLTR; LGA-16_L3.0-W3.0-P0.50-BL_SQ
U21: MMC5983MA; LGA-16_L3.0-W3.0-P0.50-BL_SQ
U22, U23, U38, U41, U42, U43, U44, U45, U46, U47: INA226; VSSOP-10_L3.0-W3.0-P0.50-LS4.9-BL
U24: CH343K; ESSOP-10_L4.9-W3.9-P1.0-LS6.0-TL-EP
U25: TUSB321RWBR; X2QFN-12_L1.6-W1.6-P0.40-TL
U26: SY7072ABC; SOT-23-6_L2.9-W1.6-P0.95-LS2.8-BL
U27: CH9434A_C39831286; QFN-48_L5.0-W5.0-P0.35-TL-EP3.7-1
U28, U29, U30, U31: 74LVC1G04GV; SOT-353_L2.0-W1.2-P0.65-LS2.1-BL
U32: E28-2G4M27SX; E22-400M22S
U33: SIM7080G; XCVR_SIM7080G
U34, U68, U69: RS0102YH8; SOT-23-8_L3.0-W1.7-P0.65-LS2.8-BL
U35: MFF2-SIM; DFN-8-1EP_6x5mm_P1.27mm_EP2x2mm
U37: AD7799BRUZ-REEL; TSSOP-16_L5.0-W4.4-P0.65-LS6.4-BL
U39: XT30AW-M.G.Y; CONN-TH_XT30AW-M.G.Y
U40: AP64501SP-13; SOIC-8-1EP_3.9x4.9mm_P1.27mm_EP2.95x4.9mm_Mask2.71x3.4mm_Th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
U48: TCA9546APW; TSSOP-16_L5.0-W4.4-P0.65-LS6.4-BL
U49, U51, U53, U55: BME280; BME280_PSON65P250X250X100-8N
U50, U52, U54, U56: VEML7700-TT; XDCR_VEML7700-TT
U57: MAX5026EUT+T; SOT-23-6_L2.9-W1.6-P0.95-LS2.8-BL
U58: ADS8331IPWR; TSSOP-24_L7.8-W4.4-P0.65-LS6.4-BL
U59: DAC124S085CIMM/NOPB; VSSOP-10_L3.0-W3.0-P0.50-LS4.9-BL
U61, U62, U66: OPA365AIDBVR; SOT-23-5_L3.0-W1.7-P0.95-LS2.8-BR
U63, U67: TLV3501AIDBV; SOT-23-6_L2.9-W1.6-P0.95-LS2.9-BL
U64: LM27762DSSR; WSON-12_L3.0-W2.0-P0.50-BL-EP
U65: OPA858IDSGR; Texas_DSG0008A_WSON-8-1EP_2x2mm_P0.5mm_EP0.9x1.6mm
U70: TXB0104RUTR; UQFN-12_L2.0-W1.7-P0.40-BL
U73: TPS7A2012; SOT-23-5_L2.9-W1.6-P0.95-LS2.8-BL
Y1: 32Mhz; Crystal_SMD_3225-4Pin_3.2x2.5mm

Connections:
/Panel1_MCU/2G4MHZ_BUSY: CN1.32, U1.56 (GPIO29)
/Panel1_MCU/2G4MHZ_CS: CN1.18, U3.15 (Y0)
/Panel1_MCU/2G4MHZ_INT: CN1.31, U1.57 (GPIO30)
/Panel1_MCU/3.3V: CN1.1, R21.2, R25.2, U22.8 (Vbus), U22.10 (Vin+), U23.8 (Vbus), U23.10 (Vin+)
/Panel1_MCU/170MHZ_BUSY: CN1.26, U1.53 (GPIO26)
/Panel1_MCU/170MHZ_CS: CN1.24, U3.12 (Y3)
/Panel1_MCU/170MHZ_INT: CN1.25, U1.60 (GPIO33)
/Panel1_MCU/400MHZ_BUSY: CN1.28, U1.54 (GPIO27)
/Panel1_MCU/400MHZ_CS: CN1.22, U3.13 (Y2)
/Panel1_MCU/400MHZ_INT: CN1.27, U1.59 (GPIO32)
/Panel1_MCU/900MHZ_BUSY: CN1.30, U1.55 (GPIO28)
/Panel1_MCU/900MHZ_CS: CN1.20, U3.14 (Y1)
/Panel1_MCU/900MHZ_INT: CN1.29, U1.58 (GPIO31)
/Panel1_MCU/BARO_LP_CS: U2.11 (Y4), U21.4 (SPI_CS)
/Panel1_MCU/C6_BOOT: Q6.2 (E), R37.2, U1.9 (C6_IO9)
/Panel1_MCU/C6_Programmer/DTR: Q6.3 (C), R34.1, U24.6 (CTS/DTR)
/Panel1_MCU/C6_Programmer/RTS: Q5.2 (E), R35.1, U24.5 (RTS)
/Panel1_MCU/C6_Programmer/VBUS: C19.1, J4.A4 (VBUS), J4.A9 (VBUS), J4.B4 (VBUS), J4.B9 (VBUS), R29.2, U24.4 (VDD5)
/Panel1_MCU/C6_RX: D4.1 (K), U1.4 (C6_U0RXD), U24.9 (RXD)
/Panel1_MCU/C6_TX: D5.1 (K), U1.5 (C6_U0TXD), U24.8 (TXD)
/Panel1_MCU/ESP_RST: C21.1, R36.2, R38.1, U1.87 (ESP_EN)
/Panel1_MCU/G-FORCE_LP_CS: U2.12 (Y3), U20.8 (CS)
/Panel1_MCU/GLM_LP_CS: CN1.12, U2.15 (Y0)
/Panel1_MCU/GPS_RXD: U5.2 (TXD), U27.5 (RXD1)
/Panel1_MCU/GPS_TXD: U5.1 (RXD), U27.6 (TXD1)
/Panel1_MCU/High_Speed_USB_D+: J5.A6 (D+), J5.B6 (D+), U1.48 (USB_DM)
/Panel1_MCU/High_Speed_USB_D-: J5.A7 (D-), J5.B7 (D-), U1.49 (USB_DP)
/Panel1_MCU/I2C0_SCL: IC1.1 (SCL), J3.6, R2.1, U1.64 (GPIO37), U6.3 (SCL), U7.4 (SCL), U8.4 (SCL), U9.6 (SCL), U10.9 (SCL), U12.2 (SCK), U13.4 (SCK), U14.16, U15.13 (SCL), U16.2 (SCL)
/Panel1_MCU/I2C0_SDA: IC1.2 (SDA), J3.7, R3.1, U1.65 (GPIO38), U6.4 (SDA), U7.7 (SDA), U8.7 (SDA), U9.3 (SDA), U10.10 (SDA), U12.4 (SDI), U13.3 (SDI), U14.20, U15.12 (SDA), U16.8 (SDA)
/Panel1_MCU/I2C1_SCL: J2.3, R4.1, U1.67 (GPIO39)
/Panel1_MCU/I2C1_SDA: J2.4, R5.1, U1.68 (GPIO40)
/Panel1_MCU/I2C_Sensors/3.3V: C5.1, C6.1, C7.1, C8.1, IC1.5 (VDD), IC1.10 (VDDH), IC1.11 (RES_N), IC1.12 (VDDIO), R13.1, U6.1 (VDD), U6.2 (VSS), U7.6 (VDD), U8.3 (ADDR), U8.6 (VDD), U9.1 (VDD), U9.5 (VDDH), U10.7 (VDD), U10.19 (VDDH), U11.3 (VDD), U12.1 (VDDIO), U12.5 (SDO), U12.6 (CSB), U12.10 (VDD), U13.2 (CSB), U13.5 (SDO), U13.6 (VDDIO), U13.8 (VDD), U14.4 (ANSupply), U14.5 (Vdd), U14.6 (Vdd), U14.10 (Vdd), U14.17 (Vdd), U14.21 (Vdd), U15.3 (VDDA), U15.10 (VDDD), U16.1 (VDD)
/Panel1_MCU/ICM_LP_CS: MT1.12 (AP_CS), U2.13 (Y2)
/Panel1_MCU/LEPTON_MasterCLK: J3.14, U1.73 (GPIO45)
/Panel1_MCU/LEPTON_SPI3_CS: J3.10, U1.69 (GPIO41)
/Panel1_MCU/LEPTON_SPI3_MISO: J3.12, U1.71 (GPIO43)
/Panel1_MCU/LEPTON_SPI3_SCK: J3.11, U1.70 (GPIO42)
/Panel1_MCU/LEPTON_VSYNC: J3.9, MT1.7 (FSYNC), U1.72 (GPIO44)
/Panel1_MCU/LP_CS_DEMUX_A: U1.23 (GPIO8), U2.1 (A)
/Panel1_MCU/LP_CS_DEMUX_B: U1.24 (GPIO9), U2.2 (B)
/Panel1_MCU/LP_CS_DEMUX_C: U1.25 (GPIO10), U2.3 (C)
/Panel1_MCU/LP_I2C_SCL: CN1.8, U1.17 (GPIO2), U22.5 (SCL), U23.5 (SCL)
/Panel1_MCU/LP_I2C_SDA: CN1.10, U1.18 (GPIO3), U22.4 (SDA), U23.4 (SDA)
/Panel1_MCU/LP_MISO: CN1.11, MT1.1 (AP_SDO/AP_AD0), U1.19 (GPIO4), U19.17 (SDO), U20.7 (SDO/SA0), U21.5 (SPI_SDO)
/Panel1_MCU/LP_MOSI: CN1.9, MT1.14 (AP_SDA/AP_SDIO/AP_SDI), U1.20 (GPIO5), U19.16 (SDI), U20.6 (SDA/SDI/SDO), U21.16 (SDA/SPI_SDI)
/Panel1_MCU/LP_SCK: CN1.7, MT1.13 (AP_SCL/AP_SCLK), U1.22 (GPIO7), U19.18 (SCLK), U20.4 (SCL/SPS), U21.1 (SCL/SPI_SCK)
/Panel1_MCU/Lepton_PWR: C15.1, C16.1, J3.1, J3.2, Q1.3 (D)
/Panel1_MCU/MICS_CONVST: U1.26 (GPIO11), U19.19 (~CONVST)
/Panel1_MCU/MICS_LP_CS: U2.14 (Y1), U19.1 (~CS)
/Panel1_MCU/P4_Dual_USB/Standby_3.3V: C24.2, C26.1, C27.1, L1.2, R47.1, R48.2, U25.12 (VDD), U26.6 (IN)
/Panel1_MCU/P4_Dual_USB/USB_ID: R46.1, R47.2, U25.9 (ID)
/Panel1_MCU/P4_Dual_USB/VBUS: C22.1, C23.1, C25.1, J5.A4 (VBUS), J5.A9 (VBUS), J5.B4 (VBUS), J5.B9 (VBUS), J6.A4 (VBUS), J6.A9 (VBUS), J6.B4 (VBUS), J6.B9 (VBUS), R39.1, R41.2, R44.1, U26.5 (OUT)
/Panel1_MCU/P4_Dual_USB/VBUS_DET: R39.2, R43.1, U25.5 (VBUS_DET)
/Panel1_MCU/PROG_USB_D+: J6.A6 (D+), J6.B6 (D+), U1.51 (GPIO25)
/Panel1_MCU/PROG_USB_D-: J6.A7 (D-), J6.B7 (D-), U1.50 (GPIO24)
/Panel1_MCU/RADIO_CS_DEMUX_A: U1.77 (GPIO49), U3.1 (A)
/Panel1_MCU/RADIO_CS_DEMUX_B: U1.78 (GPIO50), U3.2 (B)
/Panel1_MCU/RADIO_CS_DEMUX_C: U1.79 (GPIO51), U3.3 (C)
/Panel1_MCU/RANGE _RXD: CN1.38, U27.38 (RXD2)
/Panel1_MCU/RANGE_TXD: CN1.37, U27.4 (TXD2)
/Panel1_MCU/Radio_MISO: CN1.19, U1.61 (GPIO34), U27.43 (SDO)
/Panel1_MCU/Radio_MOSI: CN1.17, U1.62 (GPIO35), U27.44 (SDI)
/Panel1_MCU/Radio_SCK: CN1.15, U1.63 (GPIO36), U27.45 (SCK)
/Panel1_MCU/SD_CLK: R145.1, U1.75 (GPIO47), U4.5 (CLK)
/Panel1_MCU/SD_CMD: R144.1, U1.74 (GPIO46), U4.3 (CMD)
/Panel1_MCU/SD_DATA0: U1.76 (GPIO48), U4.7 (DAT0)
/Panel1_MCU/SIM7080_RXD: CN1.36, U27.20 (RXD0)
/Panel1_MCU/SIM7080_TXD: CN1.35, U27.17 (TXD0)
/Panel1_MCU/SPI_Sensors/ADC_IN: U19.7 (MUXOUT), U19.14 (ADCIN)
/Panel1_MCU/SPI_Sensors/CH_out: R19.2, U18.B, U19.9 (VIN2)
/Panel1_MCU/SPI_Sensors/NH3_out: R18.2, U18.C, U19.8 (VIN0)
/Panel1_MCU/SPI_Sensors/NO2_out: R20.2, U18.K, U19.13 (VIN1)
/Panel1_MCU/SPI_Sensors/heater_voltage: C11.2, C12.2, R15.1, R16.1, R17.1, U17.5 (OUT), U18.A, U18.F, U18.H, U19.5 (REFIN/REFOUT)
/Panel1_MCU/SPI_UART_CS: U3.11 (Y4), U27.46 (~SCS)
/Panel1_MCU/Sensors_3.3V: C1.2, C2.2, C3.1, C4.1, C9.2, C13.1, C30.2, CN1.2, MT1.5 (VDDIO), MT1.8 (VDD), R1.2, R6.2, R7.1, R8.2, R9.1, R10.2, R11.1, R144.2, R145.2, U2.6 (G1), U2.16 (VCC), U3.6 (G1), U3.16 (VCC), U4.4 (VDD), U5.4 (VCC), U5.5 (V_BCKP), U17.1 (IN), U17.3 (EN), U19.2 (~RESET), U19.3 (VDD), U19.20 (VDRIVE), U20.1 (Vdd_IO), U20.14 (Vdd), U21.2 (VDD), U21.13 (VDDIO), U27.3 (VCC)
/Panel1_MCU/SiPM_3.3V: C17.1, C18.1, J2.1, Q3.3 (D)
/Panel1_MCU/Standby_3.3V: C20.1, CN1.3, CN1.4, R2.2, R3.2, R4.2, R5.2, R24.1, R28.1, R32.1, R33.1, R37.1, R38.2, U1.66 (ESP_LDO_VO4), U1.84 (VBAT), U1.85 (ESP_3V3), U1.86 (ESP_3V3), U22.2 (A0), U22.6 (VS), U23.2 (A0), U23.6 (VS), U24.7 (VIO), U24.10 (V3)
/Panel1_MCU/VTX_RXD: CN1.40, U27.36 (RXD3)
/Panel1_MCU/VTX_TXD: CN1.39, U27.37 (TXD3)
/Panel2_COM/2G4MHZ_BUSY: CN2.32, U32.14 (BUSY)
/Panel2_COM/2G4MHZ_CS: CN2.18, U32.19 (NSS)
/Panel2_COM/2G4MHZ_DIO2: R51.2, U30.2 (A), U32.8 (DIO2)
/Panel2_COM/2G4MHZ_INT: CN2.31, U32.13 (DIO1)
/Panel2_COM/2G4MHZ_RXEN: U30.4 (Y), U32.6 (RXEN)
/Panel2_COM/2G4MHZ_TXEN: R51.1, U32.7 (TXEN)
/Panel2_COM/3.3V: CN2.1, FPC1.1
/Panel2_COM/170MHZ_BUSY: CN2.26, IC3.14 (BUSY)
/Panel2_COM/170MHZ_CS: CN2.24, IC3.19 (NSS)
/Panel2_COM/170MHZ_DIO2: IC3.8 (DIO2), R50.2, U29.2 (A)
/Panel2_COM/170MHZ_INT: CN2.25, IC3.13 (DIO1)
/Panel2_COM/170MHZ_RXEN: IC3.6 (RXEN), U29.4 (Y)
/Panel2_COM/170MHZ_TXEN: IC3.7 (TXEN), R50.1
/Panel2_COM/400MHZ_BUSY: CN2.28, IC4.14 (BUSY)
/Panel2_COM/400MHZ_CS: CN2.22, IC4.19 (NSS)
/Panel2_COM/400MHZ_DIO2: IC4.8 (DIO2), R52.2, U31.2 (A)
/Panel2_COM/400MHZ_INT: CN2.27, IC4.13 (DIO1)
/Panel2_COM/400MHZ_RXEN: IC4.6 (RXEN), U31.4 (Y)
/Panel2_COM/400MHZ_TXEN: IC4.7 (TXEN), R52.1
/Panel2_COM/900MHZ_BUSY: CN2.30, IC2.14 (BUSY)
/Panel2_COM/900MHZ_CS: CN2.20, IC2.19 (NSS)
/Panel2_COM/900MHZ_DIO2: IC2.8 (DIO2), R49.2, U28.2 (A)
/Panel2_COM/900MHZ_INT: CN2.29, IC2.13 (DIO1)
/Panel2_COM/900MHZ_RXEN: IC2.6 (RXEN), U28.4 (Y)
/Panel2_COM/900MHZ_TXEN: IC2.7 (TXEN), R49.1
/Panel2_COM/GLM_LP_CS: CN2.12, FPC1.12
/Panel2_COM/HARD_RESET: CN2.14, FPC1.14
/Panel2_COM/LP_I2C_SCL: CN2.8, FPC1.8
/Panel2_COM/LP_I2C_SDA: CN2.10, FPC1.10
/Panel2_COM/LP_MISO: CN2.11, FPC1.11
/Panel2_COM/LP_MOSI: CN2.9, FPC1.9
/Panel2_COM/LP_SCK: CN2.7, FPC1.7
/Panel2_COM/LTE_modem/1.8V: R55.1, U33.40 (VDD_EXT), U34.4 (OE), U34.8 (VCCA)
/Panel2_COM/LTE_modem/NETLIGHT: R56.1, U33.41 (NETLIGHT)
/Panel2_COM/LTE_modem/RF_GNSS: C43.2, R54.1, U33.68 (GNSS_ANT)
/Panel2_COM/LTE_modem/RF_LTE: C42.1, R53.1, U33.32 (RF_ANT)
/Panel2_COM/LTE_modem/SIM_CLK: U33.16 (SIM_CLK), U35.3 (CLK)
/Panel2_COM/LTE_modem/SIM_DATA: U33.15 (SIM_DATA), U35.7 (I/O)
/Panel2_COM/LTE_modem/SIM_RST: U33.17 (SIM_RST), U35.2 (RST)
/Panel2_COM/LTE_modem/SIM_VDD: C50.1, U33.18 (SIM_VDD), U35.1 (VCC)
/Panel2_COM/LTE_modem/STATUS: R57.1, U33.42 (STATUS)
/Panel2_COM/LTE_modem/USB_D+: J9.A6 (D+), J9.B6 (D+), U33.25 (USB_DP)
/Panel2_COM/LTE_modem/USB_D-: J9.A7 (D-), J9.B7 (D-), U33.26 (USB_DM)
/Panel2_COM/LTE_modem/VBUS: C46.1, J9.A4 (VBUS), J9.A9 (VBUS), J9.B4 (VBUS), J9.B9 (VBUS), R59.2, U33.24 (USB_VBUS)
/Panel2_COM/LTE_modem_PWR: FPC1.15, FPC1.17, R58.2
/Panel2_COM/RADIO_RST: CN2.21, IC2.15 (NRST), IC3.15 (NRST), IC4.15 (NRST), U32.15 (NRST)
/Panel2_COM/Radio_2.4Ghz_PWR: C37.2, C39.1, C41.1, FPC1.31, FPC1.33, U32.9 (VCC)
/Panel2_COM/Radio_170Mhz_PWR: C34.2, C36.1, FPC1.24, FPC1.26, IC3.9 (VCC)
/Panel2_COM/Radio_400Mhz_PWR: C38.2, C40.1, FPC1.23, FPC1.25, IC4.9 (VCC)
/Panel2_COM/Radio_900Mhz_PWR: C33.2, C35.1, FPC1.32, FPC1.34, IC2.9 (VCC)
/Panel2_COM/Radio_MISO: CN2.19, IC2.16 (MISO), IC3.16 (MISO), IC4.16 (MISO), U32.16 (MISO)
/Panel2_COM/Radio_MOSI: CN2.17, IC2.17 (MOSI), IC3.17 (MOSI), IC4.17 (MOSI), U32.17 (MOSI)
/Panel2_COM/Radio_SCK: CN2.15, IC2.18 (SCK), IC3.18 (SCK), IC4.18 (SCK), U32.18 (SCK)
/Panel2_COM/SIM7080_PWRKEY: CN2.23, U34.2 (B1)
/Panel2_COM/Sensors_3.3V: CN2.2, FPC1.2, U28.5 (VCC), U29.5 (VCC), U30.5 (VCC), U31.5 (VCC)
/Panel2_COM/Standby_3.3V: CN2.3, CN2.4, FPC1.3, FPC1.4
/Panel2_COM/VTX_UART3_RXD: CN2.40, FPC1.40, U34.3 (B2)
/Panel3_GLM-PSU/3.3V_PSU/3.3V: C72.1, C73.2, C74.2, C75.2, C76.2, C77.1, C78.1, L2.2, R78.1, R80.1, R81.2, R82.2, R89.2, R90.2, R97.2, R101.2, R105.2, U41.8 (Vbus), U41.10 (Vin+), U42.8 (Vbus), U42.10 (Vin+), U43.8 (Vbus), U43.10 (Vin+), U44.8 (Vbus), U44.10 (Vin+), U45.8 (Vbus), U45.10 (Vin+), U46.8 (Vbus), U46.10 (Vin+), U47.8 (Vbus), U47.10 (Vin+)
/Panel3_GLM-PSU/3.3V_PSU/Input-Voltage: C57.1, C59.1, C61.1, C63.1, Q11.2 (D), Q12.2 (D), R66.2, U38.8 (Vbus), U38.10 (Vin+), U40.2 (VIN), U40.3 (EN)
/Panel3_GLM-PSU/GLM_670/2.8V: C52.1, C53.1, C54.1, J11.2, U36.5 (OUT), U37.9 (REFIN(+)), U37.13 (AVDD)
/Panel3_GLM-PSU/GLM_670/AIN1: R62.1, TP1.1 (1_1), U37.7 (AIN2(+))
/Panel3_GLM-PSU/GLM_670/AIN2: R63.1, TP2.1 (1_1), U37.3 (AIN3(+)P1)
/Panel3_GLM-PSU/GLM_670/GLM_GND: J11.1, U37.10 (REFIN(-)), U37.11 (PSW)
/Panel3_GLM-PSU/GLM_LP_CS: FPC2.12, U37.2 (CS)
/Panel3_GLM-PSU/HARD_RESET: FPC2.14, R72.1, R73.1
/Panel3_GLM-PSU/LP_I2C_SCL: FPC2.8, U38.5 (SCL), U41.5 (SCL), U42.2 (A0), U42.5 (SCL), U43.5 (SCL), U44.5 (SCL), U45.5 (SCL), U46.5 (SCL), U47.5 (SCL)
/Panel3_GLM-PSU/LP_I2C_SDA: FPC2.10, U38.2 (A0), U38.4 (SDA), U41.4 (SDA), U42.4 (SDA), U43.1 (A1), U43.4 (SDA), U44.4 (SDA), U45.2 (A0), U45.4 (SDA), U46.4 (SDA), U47.4 (SDA)
/Panel3_GLM-PSU/LP_MISO: FPC2.11, U37.15 (DOUTRDY)
/Panel3_GLM-PSU/LP_MOSI: FPC2.9, U37.16 (DIN)
/Panel3_GLM-PSU/LP_SCK: FPC2.7, U37.1 (SCLK)
/Panel3_GLM-PSU/LTE_modem_PWR: C79.1, C81.1, C83.1, C85.1, FPC2.15, FPC2.17, Q15.3 (D)
/Panel3_GLM-PSU/Power_Connector/GATE: Q11.1 (G), Q12.1 (G), R71.2, SW2.1
/Panel3_GLM-PSU/Radio_2.4Ghz_PWR: C87.1, C89.1, C91.1, C93.1, FPC2.31, FPC2.33, Q19.3 (D)
/Panel3_GLM-PSU/Radio_170Mhz_PWR: C88.1, C90.1, C92.1, C94.1, FPC2.24, FPC2.26, Q20.3 (D)
/Panel3_GLM-PSU/Radio_400Mhz_PWR: C95.1, C96.1, C97.1, C98.1, FPC2.23, FPC2.25, Q23.3 (D)
/Panel3_GLM-PSU/Radio_900Mhz_PWR: C80.1, C82.1, C84.1, C86.1, FPC2.32, FPC2.34, Q16.3 (D)
/Panel3_GLM-PSU/Sensors_3.3V: C99.1, C100.1, C101.1, C102.1, FPC2.2, Q25.3 (D)
/Panel3_GLM-PSU/Standby_3.3V: C51.1, C55.1, C103.1, C104.1, C105.1, C106.1, FPC2.3, FPC2.4, R70.1, R87.1, R88.1, R95.1, R96.1, R100.1, R104.1, R105.1, U36.1 (IN), U36.3 (EN), U37.14 (DVDD), U38.6 (VS), U41.1 (A1), U41.6 (VS), U42.1 (A1), U42.6 (VS), U43.6 (VS), U44.1 (A1), U44.2 (A0), U44.6 (VS), U45.1 (A1), U45.6 (VS), U46.2 (A0), U46.6 (VS), U47.6 (VS), U47.9 (Vin-)
/Panel3_GLM-PSU/VTX_PWR: C58.1, C60.1, C62.1, C64.1, J10.1, Q9.2 (D)
/Panel3_GLM-PSU/VTX_UART3_RXD: FPC2.40, J10.4
/Panel3_GLM-PSU/VTX_UART3_TXD: FPC2.39, J10.3
/Panel4_BAT_Plate/GAMMA_INT: J12.13, R128.2, U63.5 (out)
/Panel4_BAT_Plate/I2C1_SCL: J12.3, U48.14 (SCL)
/Panel4_BAT_Plate/I2C1_SDA: J12.4, U48.15 (SDA)
/Panel4_BAT_Plate/MUON_INT: J12.14, R139.2, U67.5 (out)
/Panel4_BAT_Plate/SCL_0: R107.1, U48.5 (SC0), U49.4 (SCK), U50.1 (SCL)
/Panel4_BAT_Plate/SCL_1: R109.1, U48.7 (SC1), U53.4 (SCK), U54.1 (SCL)
/Panel4_BAT_Plate/SCL_2: R111.1, U48.10 (SC2), U51.4 (SCK), U52.1 (SCL)
/Panel4_BAT_Plate/SCL_3: R113.1, U48.12 (SC3), U55.4 (SCK), U56.1 (SCL)
/Panel4_BAT_Plate/SDA_0: R106.1, U48.4 (SD0), U49.2 (CSB), U50.4 (SDA)
/Panel4_BAT_Plate/SDA_1: R108.1, U48.6 (SD1), U53.3 (SDI), U54.4 (SDA)
/Panel4_BAT_Plate/SDA_2: R110.1, U48.9 (SD2), U51.3 (SDI), U52.4 (SDA)
/Panel4_BAT_Plate/SDA_3: R112.1, U48.11 (SD3), U55.3 (SDI), U56.4 (SDA)
/Panel4_BAT_Plate/SPI_CS_1: J12.7, U59.9 (~SYNC)
/Panel4_BAT_Plate/SPI_CS_2: J12.8, U58.11 (FS/~CS)
/Panel4_BAT_Plate/SPI_MISO: J12.11, U58.13 (SDO)
/Panel4_BAT_Plate/SPI_MOSI: J12.10, U58.12 (SDI), U59.8 (DIN)
/Panel4_BAT_Plate/SPI_SCK: J12.9, U58.10 (SCLK), U59.10 (SCLK)
/Panel4_BAT_Plate/SiPM_detectors/2.8V: C117.1, U58.18 (REF+), U59.7 (VREFIN), U60.5 (OUT)
/Panel4_BAT_Plate/SiPM_detectors/COMP: R114.1, U59.2 (VOUTA)
/Panel4_BAT_Plate/SiPM_detectors/Gamma Ch/+3.3V: C119.2, C120.2, C124.2, C125.2, FB1.1, U61.5 (V+), U62.5 (V+), U63.4 (V+), U63.6 (SHDN)
/Panel4_BAT_Plate/SiPM_detectors/Gamma Ch/+30V: C113.1, C114.1, D11.1 (K), R115.1, R117.1, R119.1, R130.1
/Panel4_BAT_Plate/SiPM_detectors/Gamma Ch/OPA365-out: R129.1, U62.1, U62.4 (-)
/Panel4_BAT_Plate/SiPM_detectors/Gamma Ch/opa365_in-: C121.2, R123.2, R124.2, U61.4 (-)
/Panel4_BAT_Plate/SiPM_detectors/Gamma_Thres: R127.1, U59.4 (VOUTC)
/Panel4_BAT_Plate/SiPM_detectors/MAX_COMP: C115.1, R117.2, R118.1, U58.3 (IN3)
/Panel4_BAT_Plate/SiPM_detectors/Muon_Thres: C135.1, U59.3 (VOUTB), U67.1 (-)
/Panel4_BAT_Plate/SiPM_detectors/Müon Ch/+3.3V: C128.1, C136.2, C137.2, FB2.1, U64.3 (VIN), U64.8 (EN–), U64.12 (EN+), U66.5 (V+), U67.4 (V+), U67.6 (SHDN)
/Panel4_BAT_Plate/SiPM_detectors/Müon Ch/FB+: R140.1, R141.2, U64.2 (FB+)
/Panel4_BAT_Plate/SiPM_detectors/Müon Ch/FB–: R137.1, R138.2, U64.7 (FB–)
/Panel4_BAT_Plate/SiPM_detectors/Müon Ch/OPA365-out: R142.1, U66.1, U66.4 (-)
/Panel4_BAT_Plate/SiPM_detectors/Müon Ch/opa858_V+: C130.2, C139.1, R140.2, U64.11 (OUT+), U65.7 (V+), U65.8 (~PD)
/Panel4_BAT_Plate/SiPM_detectors/Müon Ch/opa858_V-: C131.2, C140.1, R137.2, U64.6 (OUT–), U65.5 (V-), U65.9 (V-)
/Panel4_BAT_Plate/SiPM_detectors/Müon Ch/opa858_in-: C132.2, R133.2, R135.2, U65.3 (-)
/Panel4_BAT_Plate/SiPM_detectors/Müon_ADC: C138.1, R142.2, U58.1 (IN1)
/Panel4_BAT_Plate/SiPM_detectors/RESET: R120.1, R131.1
/Panel4_BAT_Plate/TCA_RST: J12.6, U48.3 (~RESET)
/Panel5_FLIR/1.2V: C146.2, C149.2, J14.7 (VDDC_1.2V), U73.5 (OUT)
/Panel5_FLIR/2.8V_1: C144.2, C147.2, J14.16 (VDDIO), J14.23 (PWR_DWN_L), U68.4 (OE), U68.8 (VCCA), U69.4 (OE), U69.8 (VCCA), U70.1 (VCCA), U70.12 (OE), U71.5 (OUT)
/Panel5_FLIR/2.8V_2: C145.2, C148.2, J14.19 (VDD_2.8V), U72.5 (OUT)
/Panel5_FLIR/GPIO3_VSYNC: J14.2 (GPIO3_VSYNC), U70.3 (A2)
/Panel5_FLIR/I2C0_SCL: J13.6, U68.2 (B1)
/Panel5_FLIR/I2C0_SDA: J13.7, U68.3 (B2)
/Panel5_FLIR/LEPTON_MasterCLK: J13.14, U70.7 (B4)
/Panel5_FLIR/LEPTON_PWR_EN: J13.4, R143.1, U71.3 (EN), U72.3 (EN), U73.3 (EN)
/Panel5_FLIR/LEPTON_RST: J13.5, U69.2 (B1)
/Panel5_FLIR/LEPTON_SPI3_CS: J13.10, U69.3 (B2)
/Panel5_FLIR/LEPTON_SPI3_MISO: J13.12, U70.8 (B3)
/Panel5_FLIR/LEPTON_SPI3_SCK: J13.11, U70.10 (B1)
/Panel5_FLIR/LEPTON_VSYNC: J13.9, U70.9 (B2)
/Panel5_FLIR/Lepton_PWR: C141.2, C142.2, C143.2, J13.1, J13.2, U70.11 (VCCB), U71.1 (IN), U72.1 (IN), U73.1 (IN)
/Panel5_FLIR/MASTER_CLK: J14.26 (MASTER_CLK), U70.2 (A1)
/Panel5_FLIR/RESET_L: J14.24 (RESET_L), U69.7 (A1)
/Panel5_FLIR/SCL: J14.21 (SCL), U68.7 (A1)
/Panel5_FLIR/SDA: J14.22 (SDA), U68.6 (A2)
/Panel5_FLIR/SPI_CLK: J14.13 (SPI_CLK), U70.5 (A4)
/Panel5_FLIR/SPI_CS_L: J14.14 (SPI_CS_L), U69.6 (A2)
/Panel5_FLIR/SPI_MISO: J14.12 (SPI_MISO), U70.4 (A3)
GND: C1.1, C2.1, C3.2, C4.2, C5.2, C6.2, C7.2, C8.2, C9.1, C10.2, C11.1, C12.1, C13.2, C14.1, C15.2, C16.2, C17.2, C18.2, C19.2, C20.2, C21.2, C22.2, C23.2, C24.1, C25.2, C26.2, C27.2, C28.1, C29.1, C30.1, C31.1, C32.2, C33.1, C34.1, C35.2, C36.2, C37.1, C38.1, C39.2, C40.2, C41.2, C42.2, C43.1, C44.2, C45.1, C46.2, C47.2, C48.2, C49.2, C50.2, C51.2, C52.2, C53.2, C54.2, C55.2, C57.2, C58.2, C59.2, C60.2, C61.2, C62.2, C63.2, C64.2, C65.2, C66.2, C67.2, C69.2, C70.2, C71.2, C73.1, C74.1, C75.1, C76.1, C77.2, C78.2, C79.2, C80.2, C81.2, C82.2, C83.2, C84.2, C85.2, C86.2, C87.2, C88.2, C89.2, C90.2, C91.2, C92.2, C93.2, C94.2, C95.2, C96.2, C97.2, C98.2, C99.2, C100.2, C101.2, C102.2, C103.2, C104.2, C105.2, C106.2, C107.1, C107.2, C108.1, C108.2, C109.1, C109.2, C110.1, C110.2, C111.1, C111.2, C112.1, C112.2, C113.2, C114.2, C115.2, C116.1, C116.2, C117.2, C118.2, C119.1, C120.1, C122.2, C123.2, C124.1, C125.1, C126.2, C127.2, C128.2, C129.2, C130.1, C131.1, C134.2, C135.2, C136.1, C137.1, C138.2, C139.2, C140.2, C141.1, C142.1, C143.1, C144.1, C145.1, C146.1, C147.1, C148.1, C149.1, CN1.5, CN1.6, CN1.13, CN1.16, CN1.33, CN1.34, CN2.5, CN2.6, CN2.13, CN2.16, CN2.33, CN2.34, D3.1 (K), D6.2, D7.2, D8.1 (K), D9.1 (K), D10.1 (K), FB1.2, FB2.2, FPC1.5, FPC1.6, FPC1.13, FPC1.16, FPC1.18, FPC1.19, FPC1.20, FPC1.21, FPC1.22, FPC1.27, FPC1.28, FPC1.29, FPC1.30, FPC1.35, FPC1.36, FPC1.37, FPC1.38, FPC2.5, FPC2.6, FPC2.13, FPC2.16, FPC2.18, FPC2.19, FPC2.20, FPC2.21, FPC2.22, FPC2.27, FPC2.28, FPC2.29, FPC2.30, FPC2.35, FPC2.36, FPC2.37, FPC2.38, IC1.6 (VSS_1), IC1.7 (VSS_2), IC1.9 (VSS_3), IC2.1 (GND), IC2.2 (GND), IC2.3 (GND), IC2.4 (GND), IC2.5 (GND), IC2.10 (GND), IC2.11 (GND), IC2.12 (GND), IC2.20 (GND), IC2.22 (GND), IC3.1 (GND), IC3.2 (GND), IC3.3 (GND), IC3.4 (GND), IC3.5 (GND), IC3.10 (GND), IC3.11 (GND), IC3.12 (GND), IC3.20 (GND), IC3.22 (GND), IC4.1 (GND), IC4.2 (GND), IC4.3 (GND), IC4.4 (GND), IC4.5 (GND), IC4.10 (GND), IC4.11 (GND), IC4.12 (GND), IC4.20 (GND), IC4.22 (GND), J2.2, J2.12, J2.15, J3.3, J3.8, J3.13, J3.15, J4.A1 (GND), J4.A12 (GND), J4.B1 (GND), J4.B12 (GND), J5.A1 (GND), J5.A12 (GND), J5.B1 (GND), J5.B12 (GND), J6.A1 (GND), J6.A12 (GND), J6.B1 (GND), J6.B12 (GND), J7.2 (Ext), J8.2 (Ext), J9.A1 (GND), J9.A12 (GND), J9.B1 (GND), J9.B12 (GND), J10.2, J12.1, J12.2, J12.12, J12.15, J13.3, J13.8, J13.13, J13.15, J14.1 (GND), J14.6 (GND), J14.8 (GND), J14.9 (GND), J14.10 (GND), J14.11 (SPI_MOSI), J14.15 (GND), J14.18 (GND), J14.20 (GND), J14.25 (GND), J14.27 (GND), J14.30 (GND), L3.2, MT1.6 (GND), Q2.2 (E), Q4.2 (E), Q7.2 (E), Q8.2 (E), Q10.3 (E), Q13.2 (S), Q14.2 (S), Q17.2 (E), Q18.2 (E), Q21.2 (E), Q22.2 (E), Q24.2 (E), Q26.3 (E), Q27.2 (S), Q28.2 (S), R14.1, R18.1, R19.1, R20.1, R29.1, R30.1, R31.1, R40.1, R41.1, R42.1, R43.2, R45.2, R59.1, R60.1, R61.1, R62.2, R63.2, R72.2, R75.2, R79.2, R116.2, R118.2, R121.2, R122.1, R123.1, R132.2, R133.1, R134.1, R138.1, R141.1, R143.2, SW1.COM, SW1.GND, U1.1 (GND), U1.3 (GND), U1.15 (GND), U1.33 (GND), U1.40 (GND), U1.47 (GND), U1.52 (GND), U1.83 (GND), U2.4 (~G2A), U2.5 (~G2B), U2.8 (GND), U3.4 (~G2A), U3.5 (~G2B), U3.8 (GND), U4.6 (VSS), U4.9 (CD1), U4.10 (CD2), U4.11 (EH), U4.12 (EH), U4.13 (EH), U4.14 (EH), U5.3 (GND), U5.12 (GND), U5.13 (GND), U5.14 (GND), U5.15 (GND), U5.16 (GND), U5.17 (GND), U5.18 (GND), U5.19 (GND), U5.20 (GND), U5.21 (GND), U5.22 (GND), U5.23 (GND), U5.24 (GND), U5.25 (GND), U5.26 (GND), U5.27 (GND), U5.28 (GND), U5.29 (GND), U5.30 (GND), U5.31 (GND), U5.32 (GND), U5.33 (GND), U5.34 (GND), U5.35 (GND), U5.36 (GND), U6.6 (VSS), U7.5 (VSS), U7.13 (EXP), U8.1 (VSS), U8.5 (VSS), U8.9 (VSS), U8.11 (VSS), U8.13 (EXP), U9.2 (VSS), U9.7 (EXP), U10.6 (GND), U10.20 (GND), U10.21 (GND), U11.4 (VSS), U12.3 (VSS), U12.8 (VSS), U13.1 (GND), U13.7 (GND), U14.1 (GND), U14.2 (GND), U14.3 (GND), U14.8 (GND), U14.9 (GND), U14.11 (GND), U14.15, U14.18, U14.24 (GND), U14.25 (GND), U14.26 (GND), U14.27 (GND), U15.1 (VSSA), U15.2 (VSSA), U15.5 (VSSA), U15.6 (VSSA), U15.7 (A1), U15.8 (SYN), U15.11 (VSSD), U15.14 (A0), U15.15 (VSSA), U15.16 (VSSA), U16.3 (GND), U16.5 (PGND), U17.2 (GND), U18.D, U19.6 (GND), U19.15 (GND), U20.5 (GND), U20.10 (Reserved), U20.12 (GND), U20.13 (GND), U20.15 (Reserved), U20.16 (GND), U21.9 (GND), U21.11 (GND), U22.1 (A1), U22.7 (GND), U23.1 (A1), U23.7 (GND), U24.3 (GND), U24.11 (GND), U25.3 (CURRENT_MODE), U25.10 (GND), U26.2 (GND), U27.25 (RST), U27.49 (GND), U28.3 (GND), U29.3 (GND), U30.3 (GND), U31.3 (GND), U32.1 (GND), U32.2 (GND), U32.3 (GND), U32.4 (GND), U32.5 (GND), U32.10 (GND), U32.11 (GND), U32.12 (GND), U32.20 (GND), U32.22 (GND), U33.8 (GND), U33.13 (GND), U33.19 (GND), U33.21 (GND), U33.27 (GND), U33.30 (GND), U33.31 (GND), U33.33 (GND), U33.36 (GND), U33.37 (GND), U33.45 (GND), U33.63 (GND), U33.66 (GND), U33.67 (GND), U33.69 (GND), U33.70 (GND), U33.71 (GND), U33.72 (GND), U33.73 (GND), U33.74 (GND), U33.75 (GND), U33.76 (GND), U33.77 (GND), U34.5 (GND), U35.5 (GND), U35.9 (GND), U36.2 (GND), U37.4 (AIN3(-)P2), U37.8 (AIN2(-)), U37.12 (GND), U38.1 (A1), U38.7 (GND), U39.2, U40.7 (GND), U40.9 (EP), U41.2 (A0), U41.7 (GND), U42.7 (GND), U43.2 (A0), U43.7 (GND), U44.7 (GND), U45.7 (GND), U46.1 (A1), U46.7 (GND), U47.1 (A1), U47.2 (A0), U47.7 (GND), U48.1 (A0), U48.2 (A1), U48.8 (GND), U48.13 (A2), U48.16 (VCC), U49.1 (GND), U49.3 (SDI), U49.6 (VDDIO), U49.7 (GND), U50.2 (VDD), U50.3 (GND), U51.1 (GND), U51.2 (CSB), U51.5 (SDO), U51.6 (VDDIO), U51.7 (GND), U51.8 (VDD), U52.2 (VDD), U52.3 (GND), U53.1 (GND), U53.2 (CSB), U53.5 (SDO), U53.6 (VDDIO), U53.7 (GND), U53.8 (VDD), U54.2 (VDD), U54.3 (GND), U55.1 (GND), U55.2 (CSB), U55.5 (SDO), U55.6 (VDDIO), U55.7 (GND), U55.8 (VDD), U56.2 (VDD), U56.3 (GND), U57.1 (PGND), U57.2 (GND), U57.4 (~SHDN), U57.5 (VCC), U58.8 (~RESET), U58.14 (DGND), U58.15 (~CONVST), U58.16 (VBD), U58.17 (VA), U58.19 (REF-), U58.20 (AGND), U58.23 (COM), U59.1 (VA), U59.6 (GND), U60.1 (IN), U60.2 (GND), U60.3 (EN), U61.2 (V-), U62.2 (V-), U63.2 (V-), U64.4 (GND), U64.13 (EP), U66.2 (V-), U67.2 (V-), U68.5 (GND), U69.5 (GND), U70.6 (GND), U71.2 (GND), U72.2 (GND), U73.2 (GND), Y1.2, Y1.4
unnamed: C31.2, U27.1 (VDD), U27.2 (VDD), U27.35 (VDD)
unnamed: C68.2, R76.2
unnamed: C71.1, R77.2
unnamed: C118.1, R119.2
unnamed: C121.1, R124.1, R125.2, R126.1, U61.1
unnamed: C126.1, R129.2
unnamed: C127.1, R130.2
unnamed: D1.2 (A), R6.1
unnamed: D1.1 (K), U2.7 (Y7)
unnamed: D2.2 (A), R10.1
unnamed: D2.1 (K), U3.7 (Y7)
unnamed: D3.2 (A), R12.1
unnamed: D4.2 (A), R32.2
unnamed: D5.2 (A), R33.2
unnamed: D8.2 (A), R56.2
unnamed: D9.2 (A), R57.2
unnamed: D10.2 (A), R80.2
unnamed: D11.2 (A), L3.1, U57.6 (LX)
unnamed: D13.2 (A), R125.1
unnamed: C122.1, D13.1 (K), Q27.3 (D), U62.3 (+)
unnamed: D15.2 (A), R136.1, U65.6
unnamed: C134.1, D15.1 (K), Q28.3 (D), U66.3 (+)
unnamed: J4.A5 (CC1), R30.2
unnamed: J4.B5 (CC2), R31.2
unnamed: J5.A5 (CC1), U25.1 (CC1)
unnamed: J5.B5 (CC2), U25.2 (CC2)
unnamed: J6.A5 (CC1), R42.2
unnamed: J6.B5 (CC2), R40.2
unnamed: C44.1, D6.1, J7.1 (In), R53.2
unnamed: C45.2, D7.1, J8.1 (In), R54.2
unnamed: J9.A5 (CC1), R60.2
unnamed: J9.B5 (CC2), R61.2
unnamed: J11.3, R64.2
unnamed: J11.4, R65.2
unnamed: Q1.1 (G), Q2.3 (C), R22.2
unnamed: Q1.2 (S), R21.1, R22.1, U22.9 (Vin-)
unnamed: Q2.1 (B), R23.2
unnamed: Q3.1 (G), Q4.3 (C), R26.2
unnamed: Q3.2 (S), R25.1, R26.1, U23.9 (Vin-)
unnamed: Q4.1 (B), R27.2
unnamed: Q5.1 (B), R34.2
unnamed: Q5.3 (C), R36.1
unnamed: Q6.1 (B), R35.2
unnamed: Q7.1 (B), R46.2
unnamed: Q7.3 (C), R48.1, U26.4 (EN)
unnamed: Q8.1 (B), R58.1
unnamed: Q8.3 (C), R55.2, U33.39 (PWRKEY)
unnamed: Q9.1 (G), R67.2, R68.2
unnamed: Q9.3 (S), R66.1, R67.1, U38.9 (Vin-)
unnamed: Q10.2 (B), R69.2
unnamed: Q10.1 (C), R68.1
unnamed: C65.1, C66.1, Q11.3 (S), Q12.3 (S), R71.1, R74.2, U39.1
unnamed: Q13.3 (D), Q14.3 (D), SW2.2
unnamed: Q13.1 (G), R73.2
unnamed: C67.1, Q14.1 (G), R74.1, R75.1
unnamed: Q15.1 (G), Q17.3 (C), R83.2
unnamed: Q15.2 (S), R81.1, R83.1, U41.9 (Vin-)
unnamed: Q16.1 (G), Q18.3 (C), R84.2
unnamed: Q16.2 (S), R82.1, R84.1, U42.9 (Vin-)
unnamed: Q17.1 (B), R85.2
unnamed: Q18.1 (B), R86.2
unnamed: Q19.1 (G), Q21.3 (C), R91.2
unnamed: Q19.2 (S), R89.1, R91.1, U43.9 (Vin-)
unnamed: Q20.1 (G), Q22.3 (C), R92.2
unnamed: Q20.2 (S), R90.1, R92.1, U44.9 (Vin-)
unnamed: Q21.1 (B), R93.2
unnamed: Q22.1 (B), R94.2
unnamed: Q23.1 (G), Q24.3 (C), R98.2
unnamed: Q23.2 (S), R97.1, R98.1, U45.9 (Vin-)
unnamed: Q24.1 (B), R99.2
unnamed: Q25.1 (G), Q26.1 (C), R102.2
unnamed: Q25.2 (S), R101.1, R102.1, U46.9 (Vin-)
unnamed: Q26.2 (B), R103.2
unnamed: Q27.1 (G), R120.2, R122.2
unnamed: Q28.1 (G), R131.2, R134.2
unnamed: R15.2, U18.E
unnamed: R16.2, U18.G
unnamed: R17.2, U18.J
unnamed: R106.2, R107.2, R108.2, R109.2, R110.2, R111.2, R112.2, R113.2
unnamed: R7.2, U4.2 (CD/DAT3)
unnamed: R8.1, U4.8 (DAT1)
unnamed: R9.2, U4.1 (DAT2)
unnamed: R12.2, U5.6 (1PPS)
unnamed: R11.2, U5.10 (~RESET)
unnamed: R13.2, U7.3 (ADDR)
unnamed: U7.9 (SCL_C), U11.2 (SCL)
unnamed: U7.1 (SDA_C), U11.1 (SDA)
unnamed: R14.2, U15.4 (REXT)
unnamed: C10.1, U19.4 (REGCAP)
unnamed: C14.2, U21.10 (CAP)
unnamed: R23.1, R24.2, U22.3 (~Alert)
unnamed: R27.1, R28.2, U23.3 (~Alert)
unnamed: J4.A6 (D+), J4.B6 (D+), U24.1 (UD+)
unnamed: J4.A7 (D-), J4.B7 (D-), U24.2 (UD-)
unnamed: R44.2, R45.1, U26.3 (FB)
unnamed: L1.1, U26.1 (LX)
unnamed: C32.1, U27.33 (VCORE)
unnamed: C28.2, U27.32 (XI), Y1.3
unnamed: C29.2, U27.31 (XO), Y1.1
unnamed: U33.2 (UART1_RXD), U34.7 (A1)
unnamed: U33.1 (UART1_TXD), U34.6 (A2)
unnamed: C56.2, R64.1, U37.5 (AIN1(+))
unnamed: C56.1, R65.1, U37.6 (AIN1(-))
unnamed: R69.1, R70.2, U38.3 (~Alert)
unnamed: C68.1, U40.1 (BST)
unnamed: C70.1, R77.1, U40.6 (COMP)
unnamed: C72.2, R78.2, R79.1, U40.5 (FB)
unnamed: C69.1, U40.4 (SS)
unnamed: L2.1, R76.1, U40.8 (SW)
unnamed: R85.1, R87.2, U41.3 (~Alert)
unnamed: R86.1, R88.2, U42.3 (~Alert)
unnamed: R93.1, R95.2, U43.3 (~Alert)
unnamed: R94.1, R96.2, U44.3 (~Alert)
unnamed: R99.1, R100.2, U45.3 (~Alert)
unnamed: R103.1, R104.2, U46.3 (~Alert)
unnamed: R114.2, R115.2, R116.1, U57.3 (FB)
unnamed: U58.21 (ADCIN), U58.22 (MUXOUT)
unnamed: R121.1, U61.3 (+)
unnamed: R126.2, R128.1, U63.3 (+)
unnamed: C123.1, R127.2, U63.1 (-)
unnamed: C133.1, U64.10 (C1+)
unnamed: C133.2, U64.9 (C1–)
unnamed: C129.1, U64.5 (CP)
unnamed: R132.1, U65.4 (+)
unnamed: C132.1, R135.1, U65.1 (FB)
unnamed: R136.2, R139.1, U67.3 (+)
VBAT: C47.1, C48.1, C49.1, CN2.39, FPC1.39, U33.34 (VBAT), U33.35 (VBAT), U34.1 (VCCB)
