budabalint/T.E.E.M.O/Circuit/sx1281 module/module.kicad_pcb

## KiCad design Circuit/sx1281 module/module.kicad_pcb (2026-04-26)

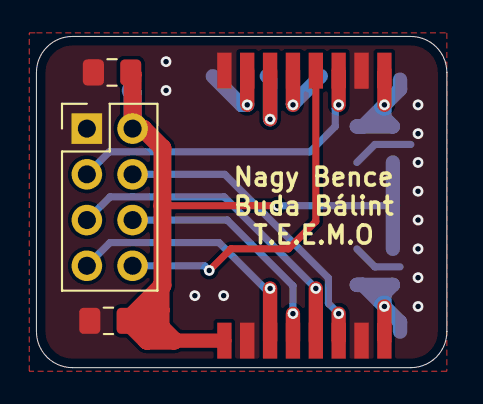
[picture p49: board module.kicad_pcb from above]

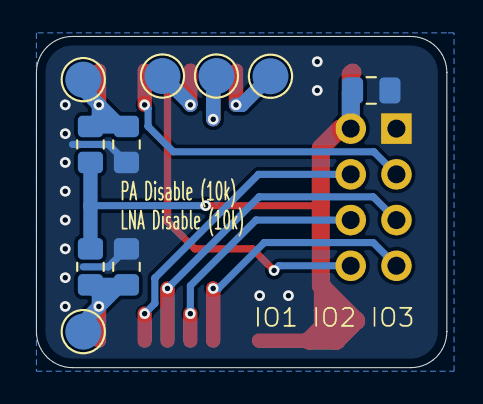
[picture p50: board module.kicad_pcb from below]

Board: 2 copper layers, 22.8 x 18.4 mm, 14 parts (10 on the bottom side), 13 nets.

Parts:
C2, C5, C6: C; C_0805_2012Metric_Pad1.18x1.45mm_HandSolder
J1: Conn_02x08_Counter_Clockwise; E28-2G4M27SX
J4: 2.4G_Radio; PinHeader_2x04_P2.54mm_Vertical
R1, R2, R3, R4: R; R_0805_2012Metric_Pad1.20x1.40mm_HandSolder
TP1, TP2, TP3, TP4, TP5: TestPoint; TestPoint_Pad_D2.0mm

Connections:
+3.3V: C2.1, C5.1, C6.1, J1.1, J4.2, R1.1, R3.1
/2.4g_cs: J1.6, J4.4
/2.4g_en: J1.11, J4.3
/2.4g_int: J1.12, J4.8
/IO1: J1.15, TP3.1
/IO2: J1.14, TP4.1
/IO3: J1.13, TP1.1
/LNA_EN: J1.8, R1.2, R2.1, TP5.1
/PA_EN: J1.9, R3.2, R4.1, TP2.1
/SPI_CLK: J1.5, J4.5
/SPI_MISO: J1.3, J4.7
/SPI_MOSI: J1.4, J4.6
GND: C2.2, C5.2, C6.2, J1.2, J1.7, J1.10, J1.16, J4.1, R2.2, R4.2
