budabalint/T.E.E.M.O/Circuit/CanSat/CanSat.kicad_pcb

## KiCad design Circuit/CanSat/CanSat.kicad_pcb (2026-04-26)

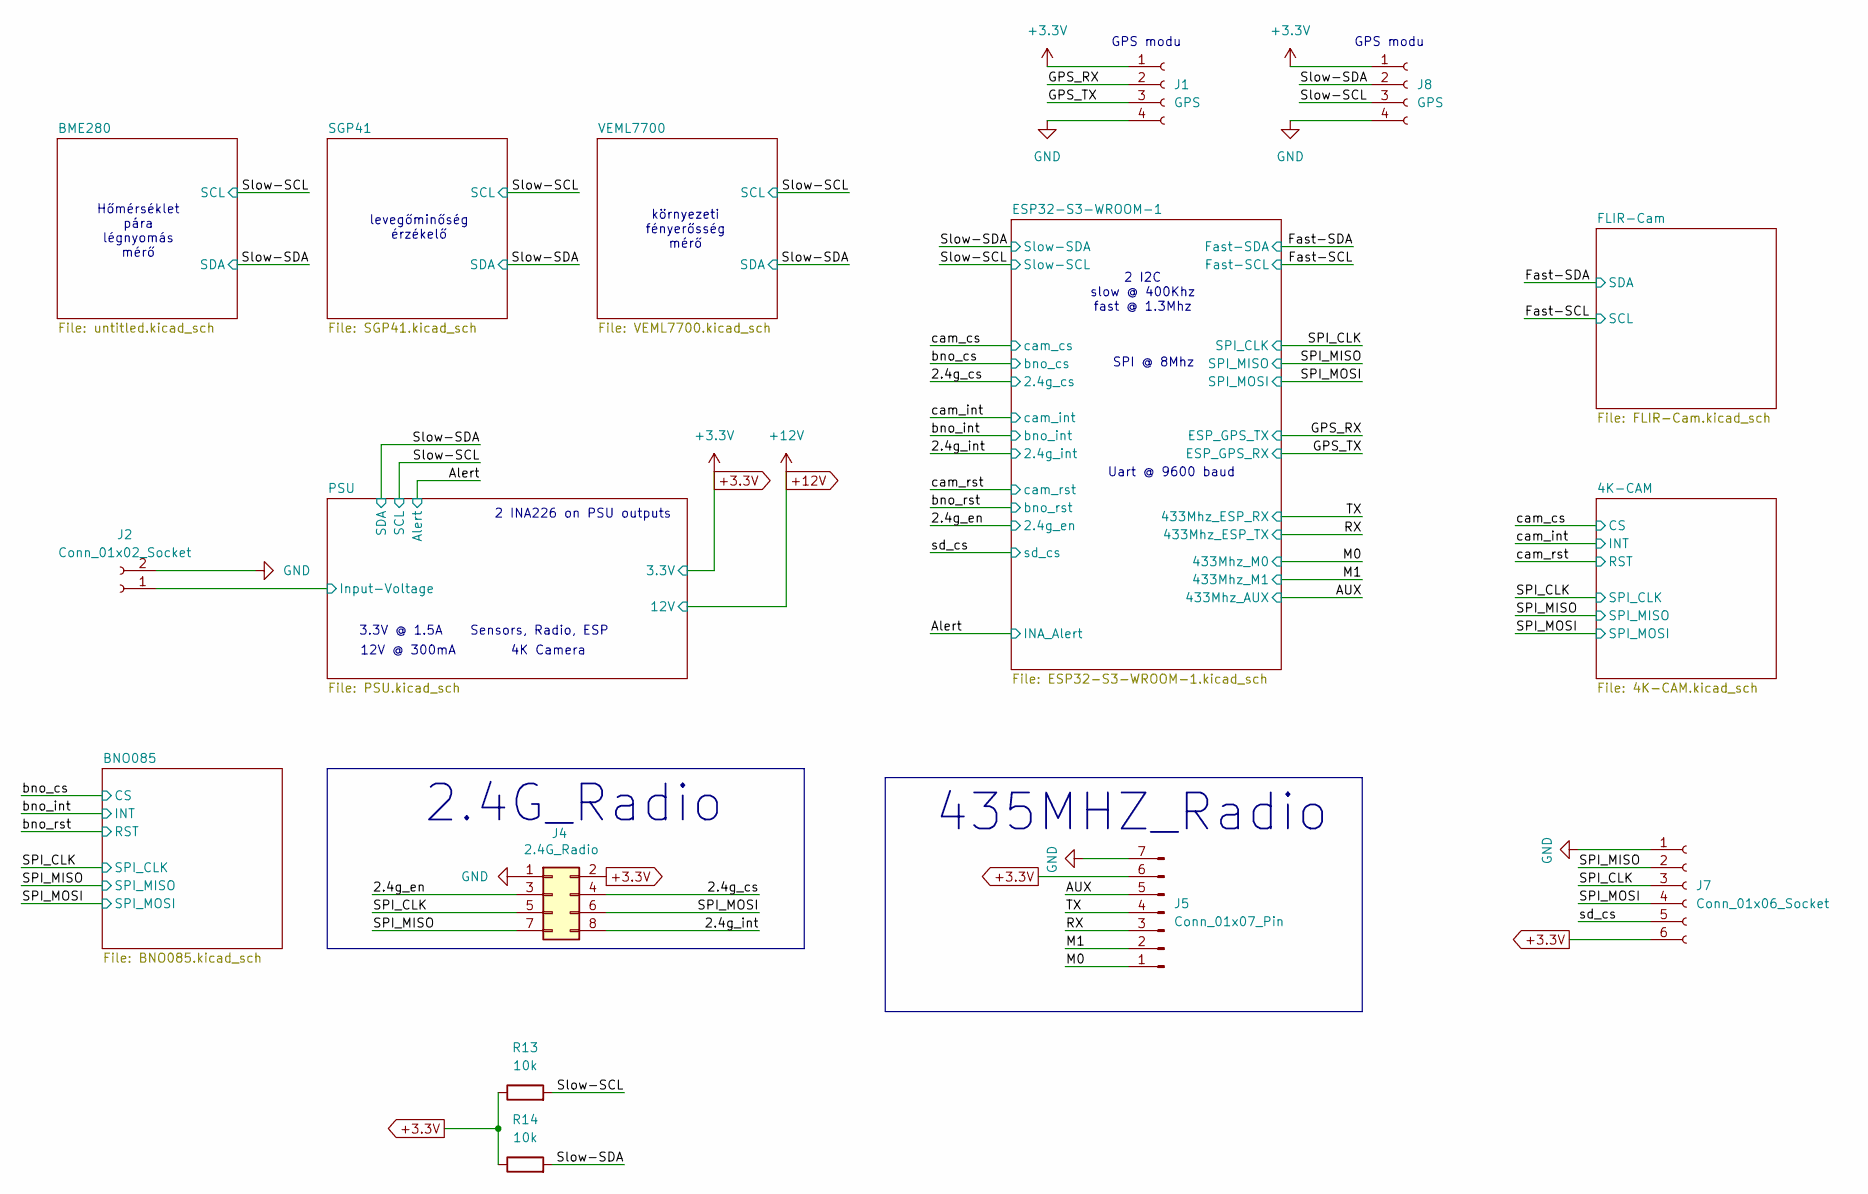
[picture p51: schematic CanSat.kicad_sch, CANSAT T.E.E.M.O KiCad Circuit]

Parts:
J1, J8: GPS; JST_PH_B4B-PH-K_1x04_P2.00mm_Vertical
J2: Conn_01x02_Socket; JST_PH_B2B-PH-K_1x02_P2.00mm_Vertical
J4: 2.4G_Radio; PinHeader_2x04_P2.54mm_Vertical
J5: Conn_01x07_Pin; PinHeader_1x07_P2.54mm_Vertical
J7: Conn_01x06_Socket; PinHeader_1x06_P2.54mm_Vertical
R13, R14: 10k; R_0805_2012Metric

Connections:
+3.3V: J1.1, J4.2, J5.6, J7.6, J8.1, R13.1, R14.1; also elsewhere on the board
/2.4g_cs: J4.4; also elsewhere on the board
/2.4g_en: J4.3; also elsewhere on the board
/2.4g_int: J4.8; also elsewhere on the board
/AUX: J5.5; also elsewhere on the board
/GPS_RX: J1.2; also elsewhere on the board
/GPS_TX: J1.3; also elsewhere on the board
/M0: J5.1; also elsewhere on the board
/M1: J5.2; also elsewhere on the board
/RX: J5.3; also elsewhere on the board
/SPI_CLK: J4.5, J7.3; also elsewhere on the board
/SPI_MISO: J4.7, J7.2; also elsewhere on the board
/SPI_MOSI: J4.6, J7.4; also elsewhere on the board
/Slow-SCL: J8.3, R13.2; also elsewhere on the board
/Slow-SDA: J8.2, R14.2; also elsewhere on the board
/TX: J5.4; also elsewhere on the board
/sd_cs: J7.5; also elsewhere on the board
GND: J1.4, J2.2, J4.1, J5.7, J7.1, J8.4; also elsewhere on the board

Notes on the sheet:
12V @ 300mA 4K Camera
SPI @ 8Mhz
környezeti fényerősség mérő
2 INA226 on PSU outputs
levegőminőség érzékelő
435MHZ_Radio
GPS modu
2 I2C slow @ 400Khz fast @ 1.3Mhz
Uart @ 9600 baud
2.4G_Radio
Hőmérséklet pára légnyomás mérő
3.3V @ 1.5A Sensors, Radio, ESP
