budabalint/T.E.E.M.O/Circuit/CanSat/CanSat.kicad_pcb

## KiCad design Circuit/CanSat/CanSat.kicad_pcb (continued)

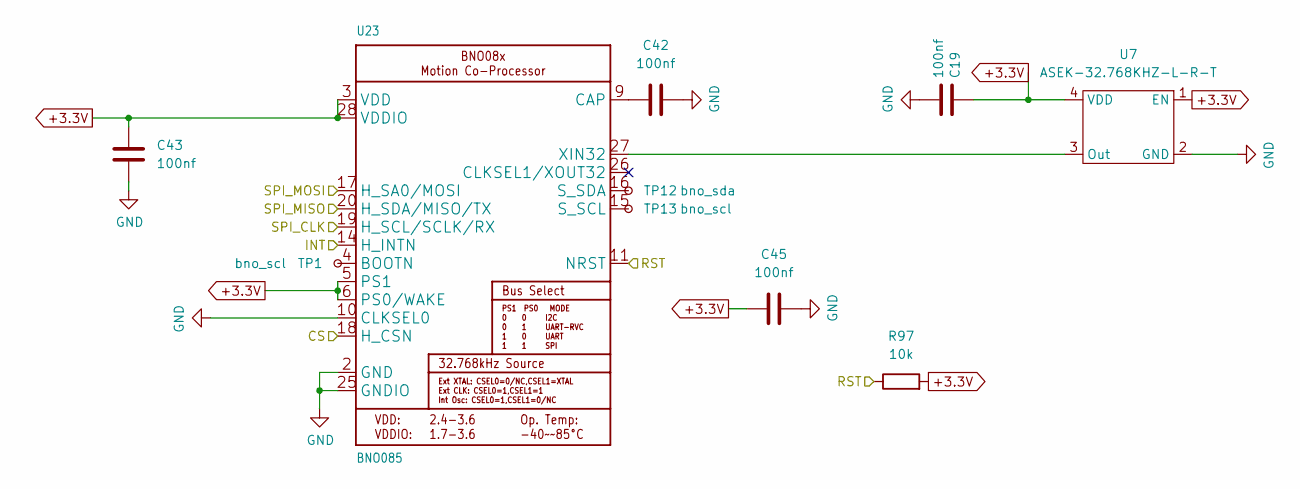
[picture p52: schematic BNO085.kicad_sch]

Parts:
C19, C42, C43, C45: 100nf; C_0805_2012Metric
R97: 10k; R_0805_2012Metric
TP1, TP13: bno_scl; TestPoint_Pad_D1.5mm
TP12: bno_sda; TestPoint_Pad_D1.5mm
U7: ASEK-32.768KHZ-L-R-T; Crystal_SMD_3225-4Pin_3.2x2.5mm
U23: BNO085; LGA-28_5.2x3.8mm_P0.5mm

Connections:
+3.3V: C19.1, C43.1, C45.1, R97.2, U7.1 (EN), U7.4 (VDD), U23.3 (VDD), U23.5 (PS1), U23.6 (PS0/WAKE), U23.28 (VDDIO); also elsewhere on the board
/SPI_CLK: U23.19 (H_SCL/SCLK/RX); also elsewhere on the board
/SPI_MISO: U23.20 (H_SDA/MISO/TX); also elsewhere on the board
/SPI_MOSI: U23.17 (H_SA0/MOSI); also elsewhere on the board
/bno_cs: U23.18 (H_CSN); also elsewhere on the board
/bno_int: U23.14 (H_INTN); also elsewhere on the board
/bno_rst: R97.1, U23.11 (NRST); also elsewhere on the board
GND: C19.2, C42.2, C43.2, C45.2, U7.2 (GND), U23.2 (GND), U23.10 (CLKSEL0), U23.25 (GNDIO); also elsewhere on the board
unnamed 75: TP1.1, U23.4 (BOOTN); also elsewhere on the board
unnamed: C42.1, U23.9 (CAP)
unnamed 77: TP13.1, U23.15 (S_SCL); also elsewhere on the board
unnamed 78: TP12.1, U23.16 (S_SDA); also elsewhere on the board
unnamed: U7.3 (Out), U23.27 (XIN32)

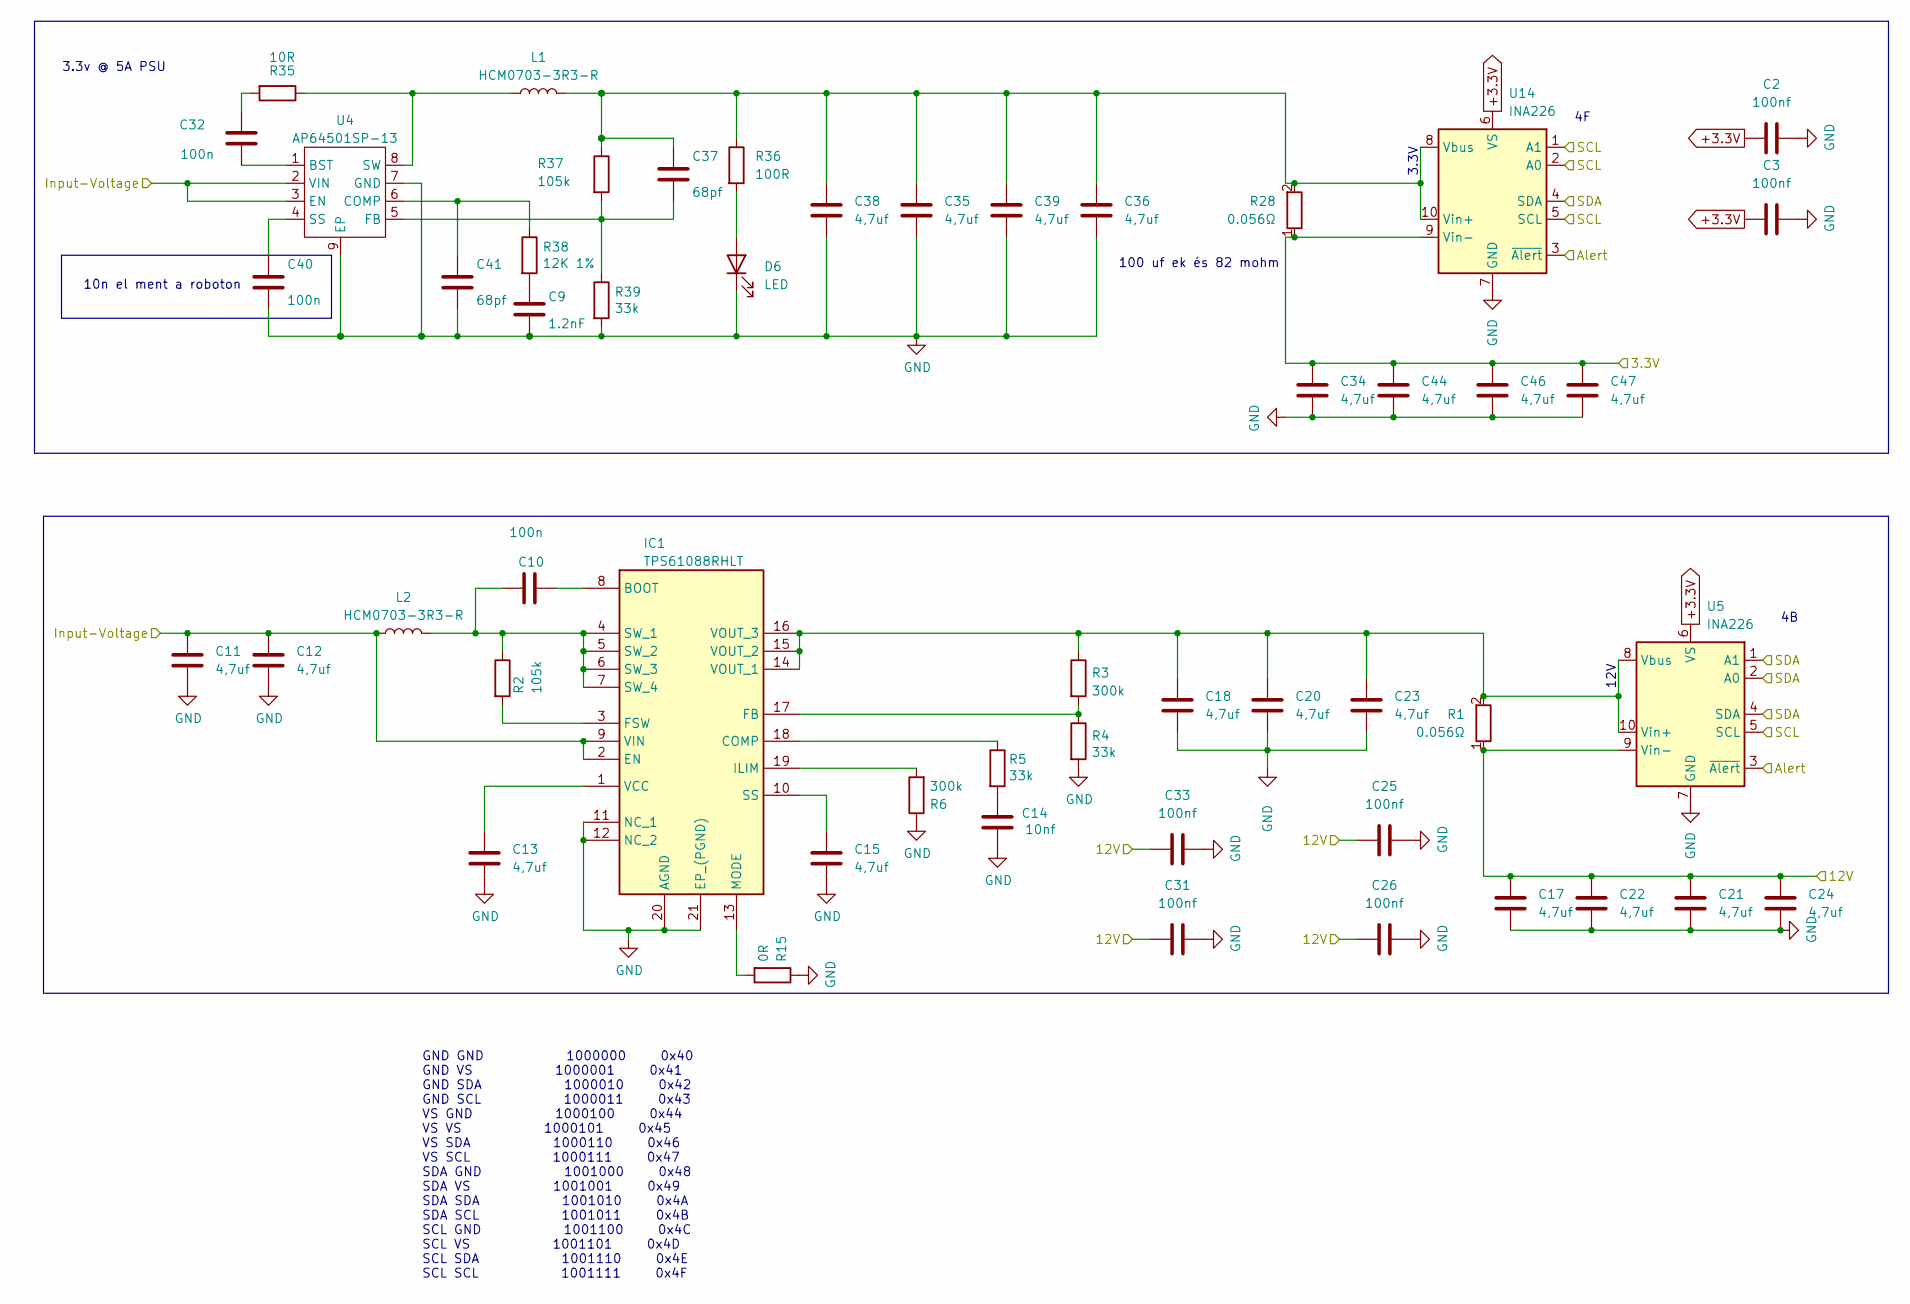
[picture p53: schematic PSU.kicad_sch]

Parts:
C2, C3, C25, C26, C31, C33: 100nf; C_0805_2012Metric
C9: 1.2nF; C_0805_2012Metric
C10, C32, C40: 100n; C_0805_2012Metric
C11, C12, C13, C15, C17, C18, C20, C21, C22, C23, C24, C34, C35, C36, C38, C39, C44, C46, C47: 4,7uf; C_0805_2012Metric
C14: 10nf; C_0805_2012Metric
C37, C41: 68pf; C_0805_2012Metric
D6: LED; D_1206_3216Metric
IC1: TPS61088RHLT; BQ24031IRHLRQ1; Manufacturer_Part_Number TPS61088RHLT; Mouser Part Number 595-TPS61088RHLT
L1, L2: HCM0703-3R3-R; HCM1A0805
R1, R28: 0.056Ω; R_1206_3216Metric
R2, R37: 105k; R_0805_2012Metric
R3, R6: 300k; R_0805_2012Metric
R4, R5, R39: 33k; R_0805_2012Metric
R15: 0R; R_0805_2012Metric
R35: 10R; R_0805_2012Metric
R36: 100R; R_0805_2012Metric
R38: 12K 1%; R_0805_2012Metric
U4: AP64501SP-13; SOIC-8-1EP_3.9x4.9mm_P1.27mm_EP2.95x4.9mm_Mask2.71x3.4mm_Th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
U5, U14: INA226; VSSOP-10_3x3mm_P0.5mm

Connections:
+3.3V: C2.1, C3.1, C34.1, C44.1, C46.1, C47.1, R28.1, U5.6 (VS), U14.6 (VS), U14.9 (Vin-); also elsewhere on the board
+12V: C17.1, C21.1, C22.1, C24.1, C25.1, C26.1, C31.1, C33.1, R1.1, U5.9 (Vin-); also elsewhere on the board
/Alert: U5.3 (~Alert), U14.3 (~Alert); also elsewhere on the board
/PSU/Input-Voltage: C11.1, C12.1, IC1.2 (EN), IC1.9 (VIN), L2.2, U4.2 (VIN), U4.3 (EN); also elsewhere on the board
/Slow-SCL: U5.5 (SCL), U14.1 (A1), U14.2 (A0), U14.5 (SCL); also elsewhere on the board
/Slow-SDA: U5.1 (A1), U5.2 (A0), U5.4 (SDA), U14.4 (SDA); also elsewhere on the board
GND: C2.2, C3.2, C9.2, C11.2, C12.2, C13.2, C14.2, C15.2, C17.2, C18.2, C20.2, C21.2, C22.2, C23.2, C24.2, C25.2, C26.2, C31.2, C33.2, C34.2, C35.2, C36.2, C38.2, C39.2, C40.2, C41.2, C44.2, C46.2, C47.2, D6.1 (K), IC1.11 (NC_1), IC1.12 (NC_2), IC1.20 (AGND), IC1.21 (EP_(PGND)), R4.2, R6.1, R15.1, R39.2, U4.7 (GND), U4.9 (EP), U5.7 (GND), U14.7 (GND); also elsewhere on the board
unnamed: C9.1, R38.2
unnamed: C14.1, R5.2
unnamed: C32.1, R35.2
unnamed: D6.2 (A), R36.2
unnamed: C10.2, IC1.8 (BOOT)
unnamed: IC1.18 (COMP), R5.1
unnamed: IC1.17 (FB), R3.2, R4.1
unnamed: IC1.3 (FSW), R2.2
unnamed: IC1.19 (ILIM), R6.2
unnamed: IC1.13 (MODE), R15.2
unnamed: C15.1, IC1.10 (SS)
unnamed: C10.1, IC1.4 (SW_1), IC1.5 (SW_2), IC1.6 (SW_3), IC1.7 (SW_4), L2.1, R2.1
unnamed: C13.1, IC1.1 (VCC)
unnamed: C18.1, C20.1, C23.1, IC1.14 (VOUT_1), IC1.15 (VOUT_2), IC1.16 (VOUT_3), R1.2, R3.1, U5.8 (Vbus), U5.10 (Vin+)
unnamed: C32.2, U4.1 (BST)
unnamed: C41.1, R38.1, U4.6 (COMP)
unnamed: C37.2, R37.2, R39.1, U4.5 (FB)
unnamed: C40.1, U4.4 (SS)
unnamed: L1.1, R35.1, U4.8 (SW)
unnamed: C35.1, C36.1, C37.1, C38.1, C39.1, L1.2, R28.2, R36.1, R37.1, U14.8 (Vbus), U14.10 (Vin+)

Notes on the sheet:
12V
100 uf ek és 82 mohm
10n el ment a roboton
3.3v @ 5A PSU
3.3V
GND GND 1000000 0x40 GND VS 1000001 0x41 GND SDA 1000010 0x42 GND SCL 1000011 0x43 VS GND 1000100 0x44 VS VS 1000101 0x45 VS SDA 1000110 0x46 VS SCL 1000111 0x47 SDA GND 1001000 0x48 SDA VS 1001001 0x49 SDA SDA 1001010 0x4A SDA SCL 1001011 0x4B SCL GND 1001100 0x4C SCL VS 1001101 0x4D SCL SDA 10011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

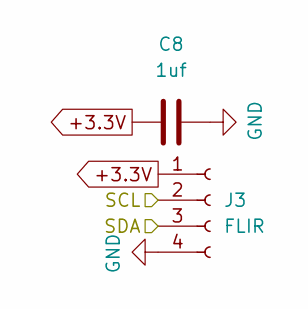
[picture p54: schematic FLIR-Cam.kicad_sch]

Parts:
C8: 1uf; C_0805_2012Metric
J3: FLIR; JST_PH_B4B-PH-K_1x04_P2.00mm_Vertical

Connections:
+3.3V: C8.1, J3.1; also elsewhere on the board
/Fast-SCL: J3.2; also elsewhere on the board
/Fast-SDA: J3.3; also elsewhere on the board
GND: C8.2, J3.4; also elsewhere on the board

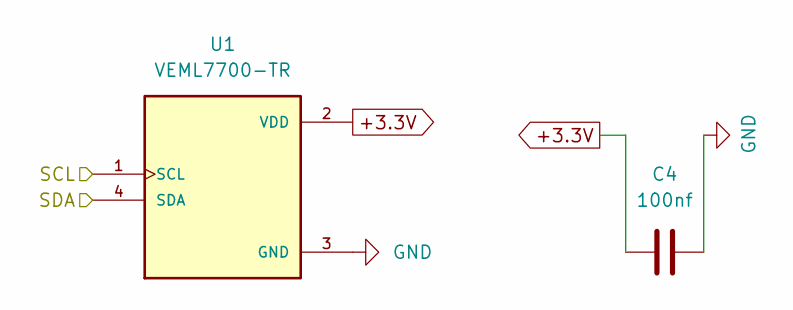
[picture p55: schematic VEML7700.kicad_sch]

Parts:
C4: 100nf; C_0805_2012Metric
U1: VEML7700-TR; XDCR_VEML7700-TR; PARTREV 1.6

Connections:
+3.3V: C4.1, U1.2 (VDD); also elsewhere on the board
/Slow-SCL: U1.1 (SCL); also elsewhere on the board
/Slow-SDA: U1.4 (SDA); also elsewhere on the board
GND: C4.2, U1.3 (GND); also elsewhere on the board

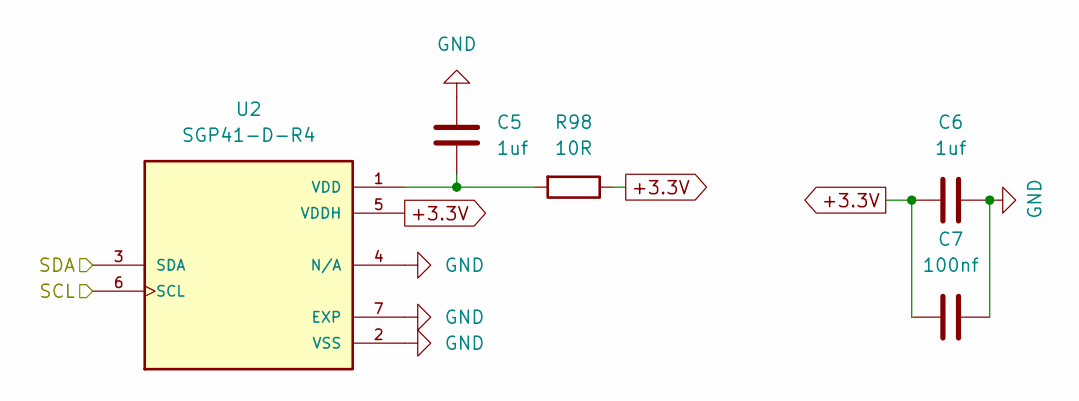
[picture p56: schematic SGP41.kicad_sch]

Parts:
C5, C6: 1uf; C_0805_2012Metric
C7: 100nf; C_0805_2012Metric
R98: 10R; R_0805_2012Metric
U2: SGP41-D-R4; XDCR_SGP41-D-R4; PARTREV 1.0

Connections:
+3.3V: C6.1, C7.1, R98.1, U2.5 (VDDH); also elsewhere on the board
/Slow-SCL: U2.6 (SCL); also elsewhere on the board
/Slow-SDA: U2.3 (SDA); also elsewhere on the board
GND: C5.2, C6.2, C7.2, U2.2 (VSS), U2.4 (N/A), U2.7 (EXP); also elsewhere on the board
unnamed: C5.1, R98.2, U2.1 (VDD)

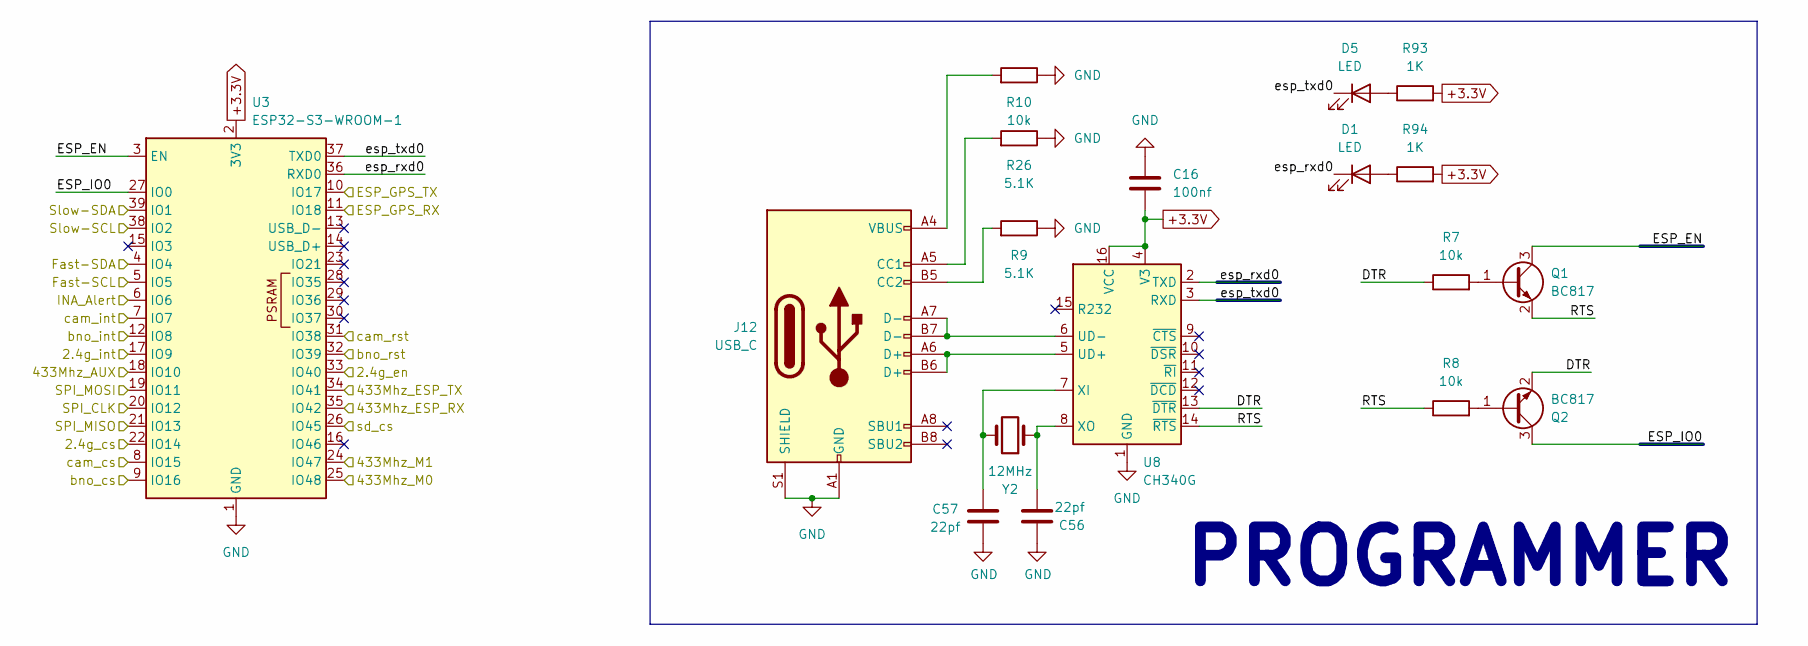
[picture p57: schematic ESP32-S3-WROOM-1.kicad_sch]

Parts:
C16: 100nf; C_0805_2012Metric
C56, C57: 22pf; C_0805_2012Metric
D1, D5: LED; D_1206_3216Metric
J12: USB_C; USB_C_Receptacle_Palconn_UTC16-G
Q1, Q2: BC817; SOT-23
R7, R8, R10: 10k; R_0805_2012Metric
R9, R26: 5.1K; R_0805_2012Metric
R93, R94: 1K; R_0805_2012Metric
U3: ESP32-S3-WROOM-1
U8: CH340G; SOIC-16_3.9x9.9mm_P1.27mm
Y2: 12MHz; Crystal_SMD_HC49-SD

Connections:
+3.3V: C16.2, R93.2, R94.2, U3.2 (3V3), U8.4 (V3), U8.16 (VCC); also elsewhere on the board
/2.4g_cs: U3.22 (IO14); also elsewhere on the board
/2.4g_en: U3.33 (IO40); also elsewhere on the board
/2.4g_int: U3.17 (IO9); also elsewhere on the board
/AUX: U3.18 (IO10); also elsewhere on the board
/Alert: U3.6 (IO6); also elsewhere on the board
/ESP32-S3-WROOM-1/DTR: Q2.2 (E), R7.1, U8.13 (~DTR)
/ESP32-S3-WROOM-1/ESP_EN: Q1.3 (C), U3.3 (EN)
/ESP32-S3-WROOM-1/ESP_IO0: Q2.3 (C), U3.27 (IO0)
/ESP32-S3-WROOM-1/RTS: Q1.2 (E), R8.1, U8.14 (~RTS)
/ESP32-S3-WROOM-1/esp_rxd0: D1.1 (K), U3.36 (RXD0), U8.2 (TXD)
/ESP32-S3-WROOM-1/esp_txd0: D5.1 (K), U3.37 (TXD0), U8.3 (RXD)
/Fast-SCL: U3.5 (IO5); also elsewhere on the board
/Fast-SDA: U3.4 (IO4); also elsewhere on the board
/GPS_RX: U3.10 (IO17); also elsewhere on the board
/GPS_TX: U3.11 (IO18); also elsewhere on the board
/M0: U3.25 (IO48); also elsewhere on the board
/M1: U3.24 (IO47); also elsewhere on the board
/RX: U3.34 (IO41); also elsewhere on the board
/SPI_CLK: U3.20 (IO12); also elsewhere on the board
/SPI_MISO: U3.21 (IO13); also elsewhere on the board
/SPI_MOSI: U3.19 (IO11); also elsewhere on the board
/Slow-SCL: U3.38 (IO2); also elsewhere on the board
/Slow-SDA: U3.39 (IO1); also elsewhere on the board
/TX: U3.35 (IO42); also elsewhere on the board
/bno_cs: U3.9 (IO16); also elsewhere on the board
/bno_int: U3.12 (IO8); also elsewhere on the board
/bno_rst: U3.32 (IO39); also elsewhere on the board
/cam_cs: U3.8 (IO15); also elsewhere on the board
/cam_int: U3.7 (IO7); also elsewhere on the board
/cam_rst: U3.31 (IO38); also elsewhere on the board
/sd_cs: U3.26 (IO45); also elsewhere on the board
GND: C16.1, C56.2, C57.2, J12.A1 (GND), J12.A12 (GND), J12.B1 (GND), J12.B12 (GND), J12.S1 (SHIELD), R9.1, R10.1, R26.1, U3.1 (GND), U3.40 (GND), U3.41 (GND), U8.1 (GND); also elsewhere on the board
unnamed: D1.2 (A), R94.1
unnamed: D5.2 (A), R93.1
unnamed: J12.A5 (CC1), R26.2
unnamed: J12.B5 (CC2), R9.2
unnamed: J12.A4 (VBUS), J12.A9 (VBUS), J12.B4 (VBUS), J12.B9 (VBUS), R10.2
unnamed: Q1.1 (B), R7.2
unnamed: Q2.1 (B), R8.2
unnamed: J12.A6 (D+), J12.B6 (D+), U8.5 (UD+)
unnamed: J12.A7 (D-), J12.B7 (D-), U8.6 (UD-)
unnamed: C57.1, U8.7 (XI), Y2.2
unnamed: C56.1, U8.8 (XO), Y2.1

Notes on the sheet:
PROGRAMMER

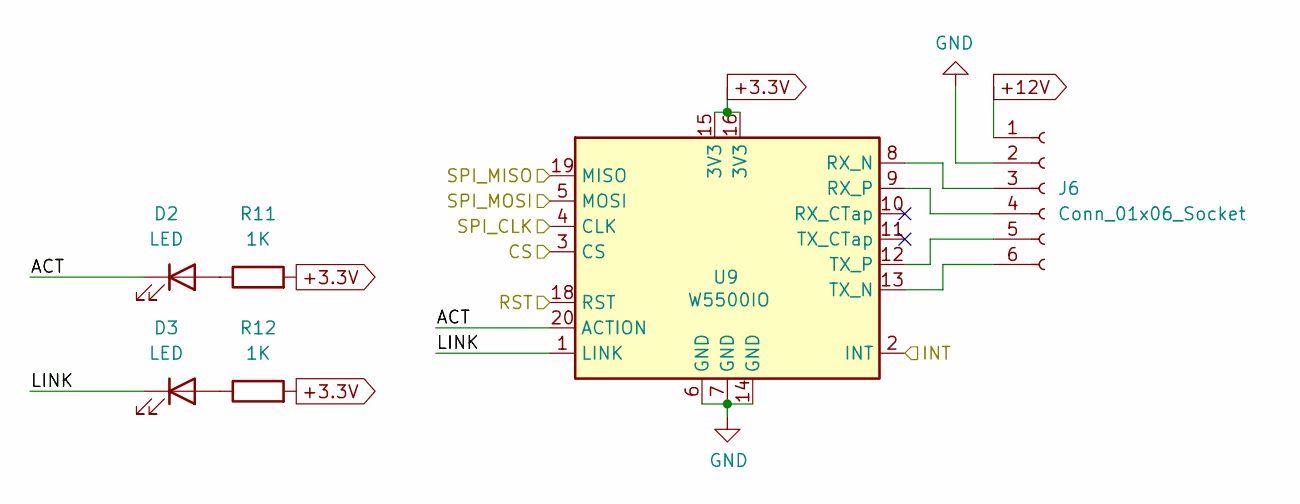
[picture p58: schematic 4K-CAM.kicad_sch]

Parts:
D2, D3: LED; D_1206_3216Metric
J6: Conn_01x06_Socket; JST_PH_B6B-PH-K_1x06_P2.00mm_Vertical
R11, R12: 1K; R_0805_2012Metric
U9: W5500IO; W5500-io

Connections:
+3.3V: R11.2, R12.2, U9.15 (3V3), U9.16 (3V3); also elsewhere on the board
+12V: J6.1; also elsewhere on the board
/4K-CAM/ACT: D2.1 (K), U9.20 (ACTION)
/4K-CAM/LINK: D3.1 (K), U9.1 (LINK)
/SPI_CLK: U9.4 (CLK); also elsewhere on the board
/SPI_MISO: U9.19 (MISO); also elsewhere on the board
/SPI_MOSI: U9.5 (MOSI); also elsewhere on the board
/cam_cs: U9.3 (CS); also elsewhere on the board
/cam_int: U9.2 (INT); also elsewhere on the board
/cam_rst: U9.18 (RST); also elsewhere on the board
GND: J6.2, U9.6 (GND), U9.7 (GND), U9.14 (GND); also elsewhere on the board
unnamed: D2.2 (A), R11.1
unnamed: D3.2 (A), R12.1
unnamed: J6.3, U9.8 (RX_N)
unnamed: J6.4, U9.9 (RX_P)
unnamed: J6.5, U9.12 (TX_P)
unnamed: J6.6, U9.13 (TX_N)

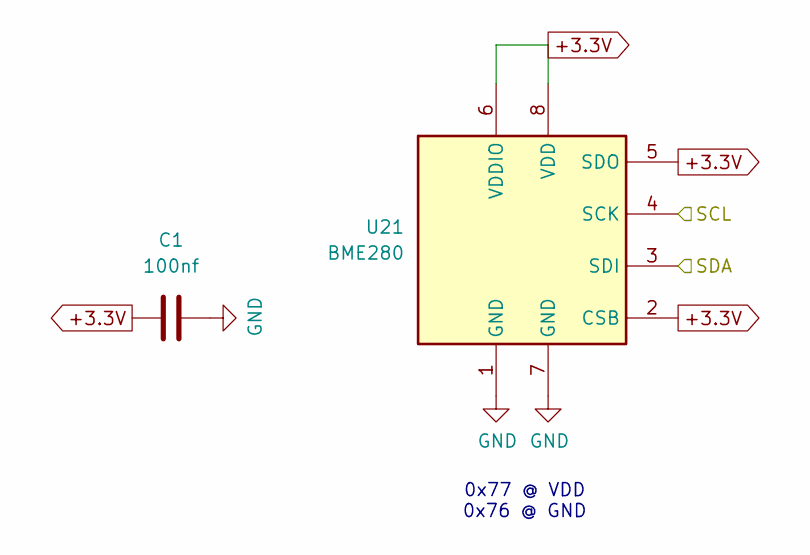
[picture p59: schematic untitled.kicad_sch]

Parts:
C1: 100nf; C_0805_2012Metric
U21: BME280; Bosch_LGA-8_2.5x2.5mm_P0.65mm_ClockwisePinNumbering

Connections:
+3.3V: C1.1, U21.2 (CSB), U21.5 (SDO), U21.6 (VDDIO), U21.8 (VDD); also elsewhere on the board
/Slow-SCL: U21.4 (SCK); also elsewhere on the board
/Slow-SDA: U21.3 (SDI); also elsewhere on the board
GND: C1.2, U21.1 (GND), U21.7 (GND); also elsewhere on the board

Notes on the sheet:
0x77 @ VDD 0x76 @ GND

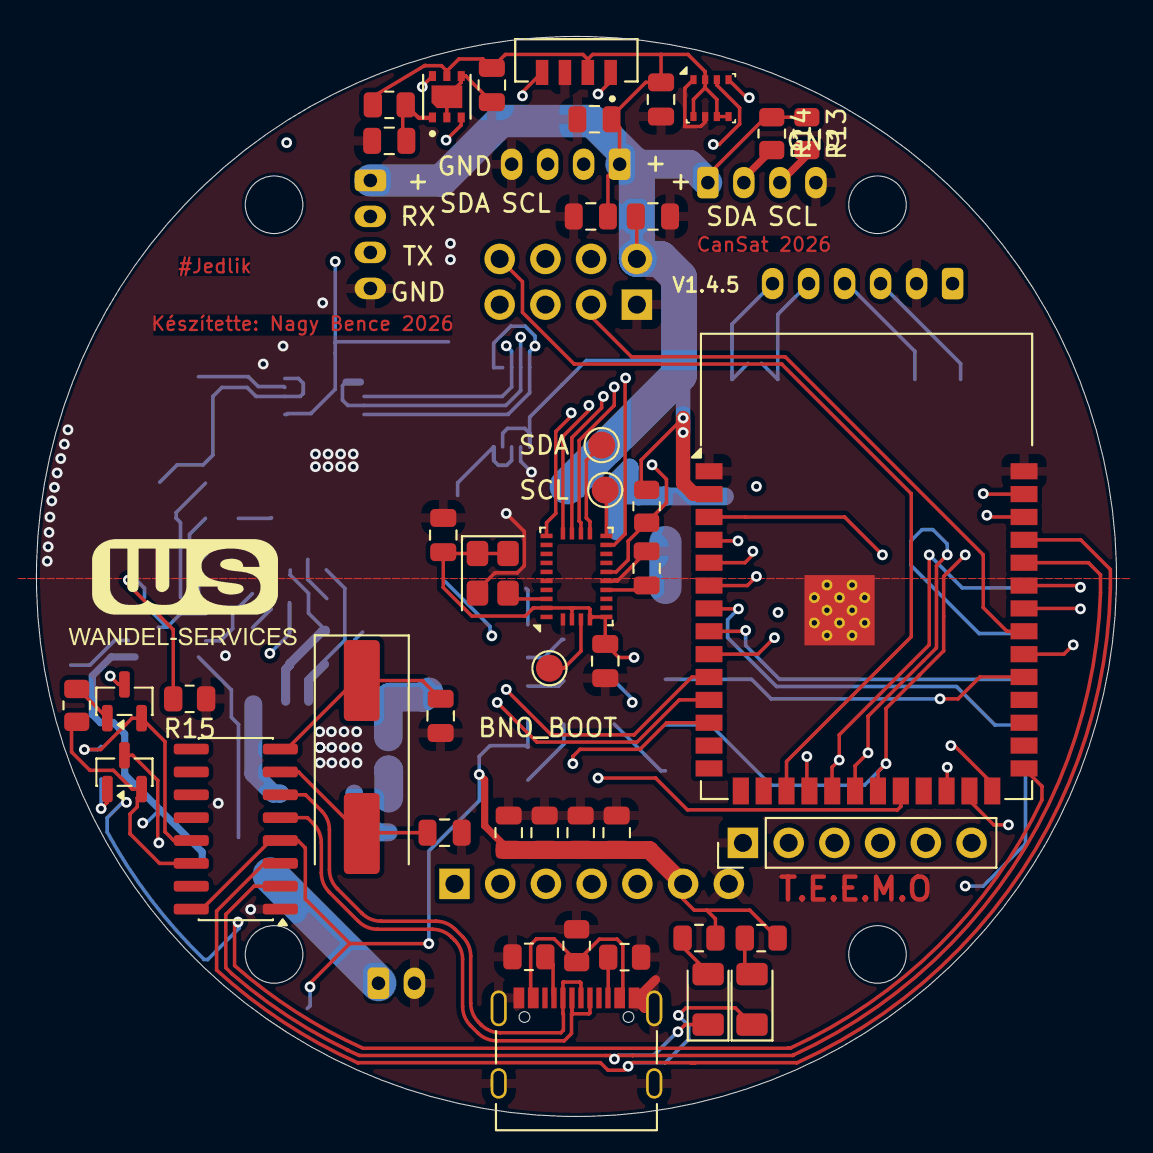
[picture p60: board Circuit/CanSat/CanSat.kicad_pcb from above]

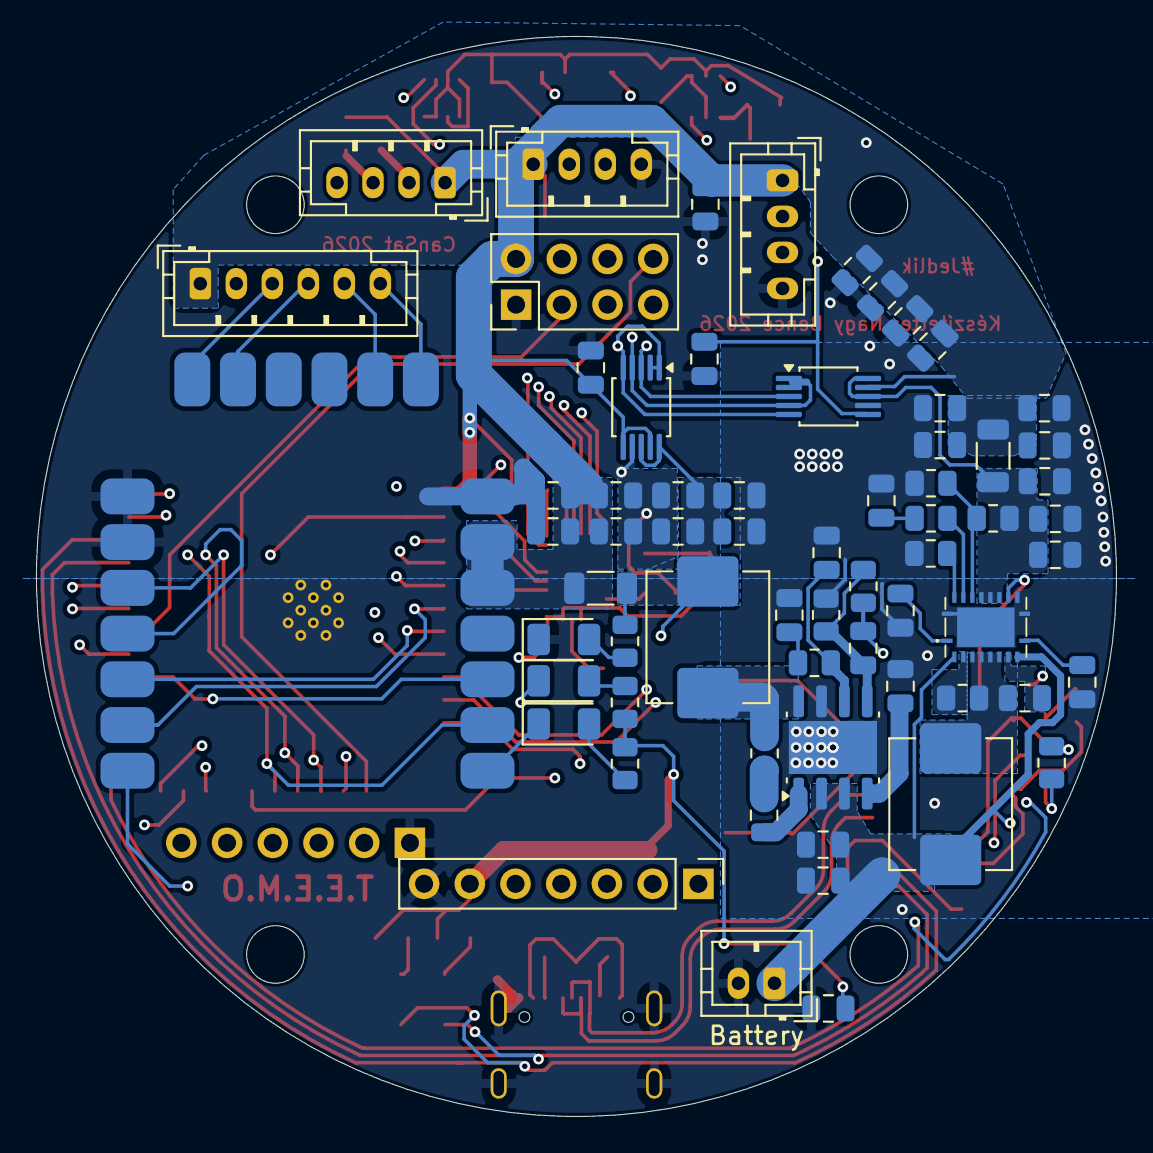
[picture p61: board Circuit/CanSat/CanSat.kicad_pcb from below]

Board: 4 copper layers, 60.0 x 60.0 mm, 109 parts (66 on the bottom side), 80 nets.

Other parts of the board:
BNO_BOOT: bno_scl; TestPoint_Pad_D1.5mm
Battery: Conn_01x02_Socket; JST_PH_B2B-PH-K_1x02_P2.00mm_Vertical
C27, C28, C29, C30: 4,7uf; C_0805_2012Metric
SCL: bno_scl; TestPoint_Pad_D1.5mm
SDA: bno_sda; TestPoint_Pad_D1.5mm

Their connections:
+3.3V: C27.1, C28.1, C29.1, C30.1; also elsewhere on the board
/PSU/Input-Voltage: Battery.1; also elsewhere on the board
GND: Battery.2, C27.2, C28.2, C29.2, C30.2; also elsewhere on the board
unnamed 75: BNO_BOOT.1; also elsewhere on the board
unnamed 77: SCL.1; also elsewhere on the board
unnamed 78: SDA.1; also elsewhere on the board
