budabalint/T.E.E.M.O/src/Ground_station/2.4Ghz/src/main.cpp

#include <SPI.h>
#include <RF24.h>
#include <nRF24L01.h>

#define CE_PIN   40
#define CS_PIN   14
#define MOSI_PIN 11
#define MISO_PIN 9
#define CLK_PIN  12

RF24 radio(CE_PIN, CS_PIN);

const byte address[6] = "00001";

void setup() {
  Serial.begin(921600);
  while (!Serial) {
  }
  SPI.begin(CLK_PIN, MISO_PIN, MOSI_PIN);

  if (!radio.begin()) {
    Serial.println("init error");
    while (1) {}
  }

  radio.setDataRate(RF24_2MBPS);
  radio.setPALevel(RF24_PA_MIN);
  radio.setChannel(85);
  radio.setPayloadSize(32);
  radio.setAutoAck(false);
  radio.openReadingPipe(1, address);
  radio.startListening();
  
  Serial.println("Vevő kész. Várakozás az adatokra...");
  radio.printDetails();
}

void loop() {
  if (radio.available()) {
    char text[32] = {0};
    radio.read(&text, sizeof(text));
    Serial.println(text);
    //Serial.println(radio.testRPD());
  }
}
