budabalint/T.E.E.M.O/src/ESP_CanSat/src/ThermalCam.cpp

#include <Wire.h>
#include <ThermalCam.h>
#include <hardware_pins.h>
#include <Create_Packet.h>

#define MLX_I2C_ADDR 0x66

uint8_t calculateCRC08(const uint8_t *data, size_t len) {
    uint8_t crc = 0x00;
    while (len--) {
        uint8_t extract = *data++;
        for (uint8_t tempI = 8; tempI; tempI--) {
            uint8_t sum = (crc ^ extract) & 0x01;
            crc >>= 1;
            if (sum) {
                crc ^= 0x8C;
            }
            extract >>= 1;
        }
    }
    return crc;
}

ThermalCam::ThermalCam() {
    writePtr = bufferA;
    readPtr = bufferB;
    newFrameReady = false;
    bufferMutex = xSemaphoreCreateMutex();
}


void ThermalCam::begin(int i2c_speed) {
    pinMode(THERMAL_CAM_I2C_SDA, INPUT_PULLUP);
    pinMode(THERMAL_CAM_I2C_SCL, INPUT_PULLUP);
    Wire1.begin(THERMAL_CAM_I2C_SDA, THERMAL_CAM_I2C_SCL); 
    Wire1.setBufferSize(4096);
    
    Wire1.setClock(i2c_speed); 

    MLX90642_Init(MLX_I2C_ADDR);
    MLX90642_SetRefreshRate(MLX_I2C_ADDR, MLX90642_REF_RATE_32HZ);
}


bool ThermalCam::captureFrameToBuffer() {
    int status = MLX90642_GetFrameData(MLX_I2C_ADDR, mlxAux, mlxRawPix, writePtr);
    
    if (status < 0) return false;

    xSemaphoreTake(bufferMutex, portMAX_DELAY);
    newFrameReady = true;
    xSemaphoreGive(bufferMutex);
    
    return true;
}


void ThermalCam::swapBuffersIfNew() {
    if (xSemaphoreTake(bufferMutex, 10) == pdTRUE) {
        if (newFrameReady) {
            uint16_t* temp = readPtr;
            readPtr = writePtr;
            writePtr = temp;
            
            newFrameReady = false;
        }
        xSemaphoreGive(bufferMutex);
    }
}

ThermalPacket ThermalCam::getPacketFromBuffer(uint8_t groupId, uint16_t frameSeq) {
    ThermalPacket packet;
    packet.startByte = 0xFE;
    packet.packetId  = 0xCC;
    packet.groupId   = groupId;
    packet.frameSeq  = frameSeq;

    uint16_t* currentPixels = readPtr;
    int index = 0;

    for (int r = 0; r < 3; r++) {
        int row = groupId * 3 + r;
        int startPixel = row * 32;
        uint16_t data[4];

        for (int i = 0; i < 8; i++) {
            int pIdx = startPixel + (i * 4);

            if (pIdx + 3 >= MLX90642_TOTAL_NUMBER_OF_PIXELS) {
                data[0] = data[1] = data[2] = data[3] = 0;
            } else {
                data[0] = (uint16_t)(currentPixels[pIdx + 0] / 5);
                data[1] = (uint16_t)(currentPixels[pIdx + 1] / 5);
                data[2] = (uint16_t)(currentPixels[pIdx + 2] / 5);
                data[3] = (uint16_t)(currentPixels[pIdx + 3] / 5);
            }

            packet.data[index++] = (uint8_t)((data[0] >> 2) & 0xFF);
            packet.data[index++] = (uint8_t)(((data[0] & 0x03) << 6) | ((data[1] >> 4) & 0x3F));
            packet.data[index++] = (uint8_t)(((data[1] & 0x0F) << 4) | ((data[2] >> 6) & 0x0F));
            packet.data[index++] = (uint8_t)(((data[2] & 0x3F) << 2) | ((data[3] >> 8) & 0x03));
            packet.data[index++] = (uint8_t)(data[3] & 0xFF);
        }
    }

    packet.crc = calculateCRC08((uint8_t*)&packet, sizeof(packet) - 1);
    return packet;
}
