budabalint/T.E.E.M.O/src/2026/ESP_CanSat/include/4Kcam.h

#pragma once

#include <Arduino.h>
#include <SPI.h>
#include <Ethernet.h>

class Maincam {
public:
    bool checkW5500();
    Maincam();
    void sendRTSPCommand(String method, String url, String extraHeaders = "");
    bool begin();
    String readResponse(bool lookForSession = false);
    void sendNALPacket(byte* data, int len, bool newNAL);
    void ReadAndSendImage(unsigned long timeoutMaxMs);

private:
    EthernetClient _rtspClient;
    String sessionID = "";
    int CSeq = 1;
};
