budabalint/T.E.E.M.O/(commit log)

2025-11-27 backut commit first version of panel
    [2.4G-Radio.kicad_sch, 4K-CAM.kicad_sch, 868 MHZ-Radio.kicad_sch, BNO085.kicad_sch, Battery.kicad_sch, CanSat.kicad_pcb, CanSat.kicad_sch, ESP32-S3-WROOM-1.kicad_sch]
2026-01-09 pcb last before finish
    [BNO085.kicad_sch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]
2026-01-09 Main code sensors first try
2026-01-10 pcb update
    [CanSat.kicad_sch]
2026-01-10 all sensors work
2026-01-10 sensor package assembly complete
2026-01-10 kicad update
2026-01-10 Thermal Camera files added
2026-01-11 Thermal Camera packet building
2026-01-12 camera I2C bug fixed
    [ThermalCam.cpp, main.cpp]
2026-01-12 Sensor readtime optimalization
2026-01-13 All packet bug fixed
    [CreatePacket.cpp, Create_Packet.h, ThermalCam.cpp, main.cpp]
2026-01-23 433 Mhz radio code fixed
    [main.cpp]
2026-01-24 thread management started
2026-01-25 thread management
2026-01-26 Thread mangae debuging
2026-01-27 Thermal cam I2c buffer bug fixed
    [ThermalCam.h, main.cpp]
2026-01-28 Uart radio bug fixed
    [hardware_pins.h, main.cpp]
2026-02-02 w5500 and first code on the pcb
2026-02-03 Ina sensor bug fixed
    [CanSat.cpp, Ina_Sensor.cpp, config.h, main.cpp]
2026-02-05 All sensor works on the pcb
2026-02-07 the 433 mhz radio and all sensors are working and the ground station receives the data
2026-02-20 ground station code
2026-02-20 gnd station 433 code finished
2026-02-21 packet bug and ground station code fixed
    [CreatePacket.cpp, Create_Packet.h, SGP41.cpp, main.cpp, settings.h]
2026-03-10 sensors init bug fixed
    [CanSat.cpp, CanSat.h, CreatePacket.cpp, main.cpp]
2026-03-12 bno and sd spi debuging
2026-03-13 bno I2C
2026-03-13 bno I2c sd bug finaly fixed
    [CanSat.cpp, main.cpp]
2026-03-16 Implement SetPinModes function in CanSat
    Added SetPinModes function to initialize pin modes for various components.
2026-03-20 Refactor motor control logic for yaw and pitch
2026-03-23 drid rotater code bug fixing
    [main.cpp]
2026-03-24 grid rotater working code with manual buttons
2026-03-25 grid rotater uart commands
2026-03-27 adc values for manual mode
2026-04-26 latest pcb, sx module, initial new sensor panel
    [CanSat.kicad_pcb, CanSat.kicad_sch, ESP32-S3-WROOM-1.kicad_sch, Flexi sensor panel.kicad_pcb, Flexi sensor panel.kicad_sch, PSU.kicad_sch, module.kicad_pcb, module.kicad_sch]
2026-06-30 grid rotater bug fixing
    [main.cpp]
2026-07-01 2.4ghz radio code fixed
    [main.cpp]
2026-07-02 mjpeg creator and ESP Flash writer
    [partitions.csv]
2026-07-02 mjpeg stream to serial
    [partitions.csv]
2026-07-02 mjpeg decoder bug fixed
    [ThermalCam.cpp, ThermalCam.h, main.cpp, mjpeg_stream_decoder.py]
2026-07-02 mjpeg stream decoder and reciever codeoptimalized
    [partitions.csv]
2026-07-02 SX1280 code implemented to ESP cansat
    [partitions.csv]
2026-07-16 megy az espn az új képjavító cucc meg a pythonok megvannak a dekódolásra
    [partitions.csv]
2026-07-30 adc értékek
2026-07-30 ina current szar
2026-08-04 grid rotator code bugfixes before competition
    [main.cpp]
2026-08-04 grid rotater auto mode fixed
    [main.cpp]
2026-08-04 PCB folder cleanup
    [Flexi sensor panel.kicad_pcb, Flexi sensor panel.kicad_sch, SGP30.kicad_sch]
2026-08-04 Cansat V2 pcb initial
2026-08-18 esp32-S3 jtag debug and serial
    [partitions.csv]
